lc285800/rk3588-camera-robot/artifacts/20260721/M17-guided-live-acceptance/aligned-marker.jpg

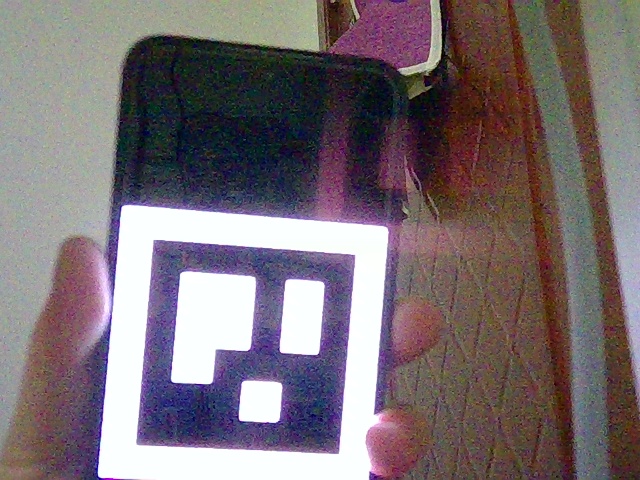
artifacts/20260721/M17-guided-live-acceptance/aligned-marker.jpg
