lc285800/rk3588-camera-robot/artifacts/20260721/M17-live-acceptance-prep/current-view.jpg

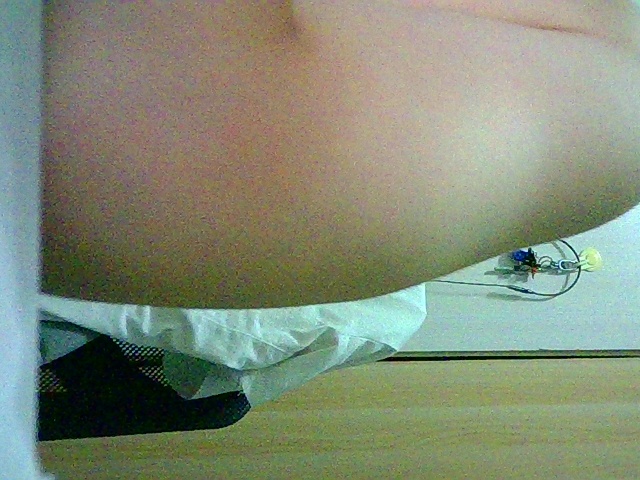
artifacts/20260721/M17-live-acceptance-prep/current-view.jpg
