lc285800/rk3588-camera-robot/README.md

# LubanVision：RK3588 ROS 2 视觉跟踪云台机器人

LubanVision 是一个以 Linux、ROS 2 和主动视觉为主线的机器人学习项目。鲁班猫5
（RK3588，4GB RAM）读取 USB 摄像头图像，ROS 2 节点识别 ArUco 标记并计算画面误差，
通过 RK3588 硬件 PWM 控制 SG90 云台，持续将目标保持在画面中心。

首版不依赖AI模型。所有核心环境、代码、日志和故障都可以通过SSH直接分析与修复，
优先保证项目完整落地。

## 系统分工

```text
MacBook M2（项目控制台）
  Git / 文档 / 任务管理 / SSH 运维
                 │ 家庭局域网
Windows + WSL2（开发工作站） ───── 鲁班猫5 RK3588（机器人运行端）
  ROS 2编译、RViz、rosbag分析          USB摄像头
                                      │ 图像
                              ArUco识别 + PID控制
                                      │ Linux PWM
                            RK3588 PWM13_M1 / Pin 32
                                      │ 3.3V PWM信号
                                1～2个SG90云台
```

Mac和Windows断开后，机器人仍能在鲁班猫5上独立运行。第一阶段使用单轴水平跟踪；验证稳定
后增加第二个SG90，升级为水平和俯仰双轴跟踪。

## 首版交付能力

- USB摄像头ROS 2驱动与远程图像查看。
- OpenCV ArUco检测、目标中心和置信状态发布。
- 可测试的PID视觉伺服控制器。
- RK3588 Linux PWM驱动和SG90安全角度控制。
- 目标丢失后的保持、回中和有限扫描状态机。
- 摄像头、PWM或节点异常时停止更新舵机，禁止无限旋转或撞限位。
- YAML参数、rosbag记录、systemd开机待命和结构化日志。
- 后续可选的人体检测、RK3588 NPU推理和网页监控。

## 仓库状态

仓库只保留LubanVision相关内容。`lubanvision_vision`提供离线ArUco检测和ROS目标观测节点；
`lubanvision_camera_cpp`提供M06验收使用的低开销V4L2相机发布和速率探针，不依赖
`cv_bridge`或OpenCV开发包。`lubanvision_interfaces`提供目标观测消息；
`lubanvision_control`提供ROS无关的PID、目标丢失状态机和模拟云台闭环；
`lubanvision_hardware`提供默认禁用、严格脉宽限位、异常清理的sysfs PWM核心，以及M16
标定和M17单轴视觉跟踪节点。M17基础跟随已完成：物理方向由静止目标A/B确定为`-1`，最终
引导式闭环取得533条有效检测，平均绝对水平误差0.0555、最终0.0341、故障0，退出后PWM与
全部进程安全清理。保守默认仍使用1.85-1.95ms；经现场验证的70-110度、`Kp=6`、最大5度/秒
配置单独记录为测试档案，不自动取代安全默认。短时手持实测确认1.00ms约0度、1.90ms约
90度、2.50ms约150度，舵机为位置型而非360度连续旋转型；目测结果不能替代升级供电后的
量角器测量与连续运行验收。M18硬件故障注入已完成：观测进程退出后按保持/回中转移，USB
摄像头断开时节点明确报错退出且重连重启恢复，PWM已有消费者时每个启用沿只拒绝一次且不
接管。当前下一任务为M19 bringup与systemd待命部署。

## 文档

- [项目协作规则](AGENTS.md)
- [快速入门](docs/01_quick_start.md)
- [系统设计](docs/02_design.md)
- [项目进展](docs/03_progress_status.md)
- [问题记录](docs/04_issue_log.md)
- [测试计划](docs/05_test_plan.md)
- [WSL2 ROS 2安装记录](docs/06_wsl_ros2_install.md)
- [RK3588 ROS 2安装与验证记录](docs/07_rk_ros2_install.md)
- [RK3588 Clash代理与ROS下载记录](docs/rk3588_clash_proxy_ros.md)
- [半小时任务执行手册](docs/08_execution_playbook.md)
- [鲁班猫5 V1硬件参考资料](硬件_鲁班猫5/README.md)
