lc285800/rk3588-camera-robot/assets/markers/aruco_4x4_50_id23.png

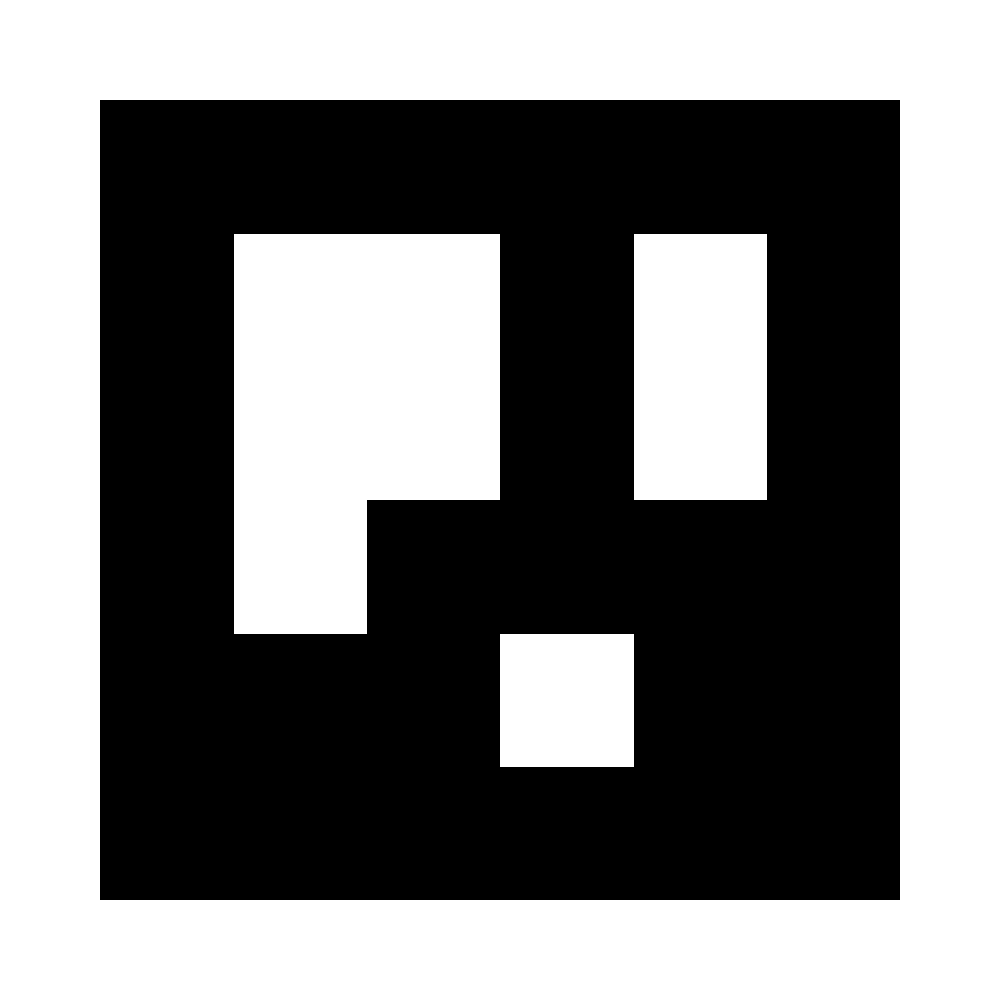
assets/markers/aruco_4x4_50_id23.png
