lc285800/rk3588-camera-robot/(list of files, cad)

Other CAD files:
硬件_鲁班猫5/EBF410149V1R0_20240221/LubanCat5_EBF410149V1R0_PCB_20240221_TOP.dxf
硬件_鲁班猫5/EBF410149V1R0_20240221/LubanCat5_EBF410149V1R0_PCB_20240221_BOT.dxf
