lc285800/rk3588-camera-robot/artifacts/20260722/M18-fault-injection/camera-unbind-result.txt

fault_exit_code=1
recovery_exit_code=124
camera_node=online
result=PASS
