lc285800/rk3588-camera-robot/artifacts/20260720/M16-three-point-calibration/result.md

# M16三点保守标定（第1轮）

## 状态

方向复验和临时软件映射已通过，M16保持进行中（受限）。正式项目代码已经在真实RK/SG90
链路执行，但本轮只重复M15已冒烟验证的1.45-1.55ms范围，不扩大脉宽，不声明机械实测
角度或正式安全范围。

## 软件与系统结果

- 使用`lubanvision_hardware.SysfsPwmChannel`，没有直接拼接sysfs动作命令。
- 顺序为1.50、1.45、1.50、1.55、1.50ms，每点保持约2秒。
- 安全核心正常退出并取消导出PWM。
- Boot ID未变化，uptime连续增长，温度约33-34 C。
- USB摄像头、NVMe和以太网保持在线，动作窗口无新增内核消息。

## 尚未完成

- 供电升级后重新执行同一序列，才可把供电稳定纳入M15完成证据。
- 尚未测量85/90/95度机械角度，YAML为`provisional_three_point`。

## 第2轮方向复验

为消除第1轮顺序记忆的不确定性，单独执行1.50ms中位2秒、1.45ms观察点3秒、1.50ms回中
2秒。安全核心正常关闭，RK与主要外设保持在线，动作窗口无新增内核消息。原始记录位于
`logs/run2-1450-direction.txt`，当前等待用户确认1.45ms实际方向。

用户要求再次观察后，第3轮原样重复同一序列。动作、系统监控和PWM清理再次通过，记录位于
`logs/run3-1450-direction-repeat.txt`。用户确认1.45ms从中位向左转动，恢复1.50ms时向右
回到中位，PWM关闭后保持不动。因此当前方向映射为：脉宽减小向左，中位为1.50ms；1.55ms
方向仍需单独确认。

第4轮从1.50ms中位单独切换到1.55ms三秒后回中，安全核心、系统监控和PWM清理均通过，
记录位于`logs/run4-1550-direction.txt`。用户确认1.55ms向右转动，恢复1.50ms时向左回中并
停止。最终方向映射为：脉宽减小向左，脉宽增大向右，1.50ms为中位。

## 临时标定模型与回归

- 新增`ServoCalibration`，把85/90/95度名义命令映射到1.45/1.50/1.55ms；PWM硬限位仍独立
  生效，越界、非数值、非有限值和非法配置均拒绝。
- WSL与RK的关键文件SHA-256一致。
- WSL硬件包：38项通过；完整工作区：82项通过，0错误、0失败、0跳过。
- RK硬件包：38项通过；完整工作区：82项通过，0错误、0失败、0跳过。
- RK测试前后`pwmchip3/pwm0`均未导出；测试本身没有驱动真实舵机。
- Mac静态编译和脚本检查通过。系统Python缺少PyYAML，YAML解析尝试未执行，已记录在
  `logs/failed-attempts.txt`，正式ROS测试由WSL和RK完成。
