lc285800/rk3588-camera-robot/artifacts/20260720/M15-safe-pwm-core/result.md

# M15受限sysfs PWM核心

## 结论

通过。新增`lubanvision_hardware`包和ROS无关的受限sysfs PWM核心，在WSL与RK完成构建、
单元测试、lint和全工作区回归。整个验证只使用模拟sysfs后端，RK真实`pwmchip3/pwm0`始终
未导出，没有驱动SG90。

## 安全语义

- 默认只接受已经完成硬件冒烟的1.45-1.55ms临时范围，中位为1.50ms，周期为20ms。
- 配置拒绝负通道、非法极性、非整数脉宽、越界脉宽和无效超时。
- 拒绝接管已由其他进程导出的PWM通道。
- 导出后先配置周期、中位和极性，默认保持禁用；显式启用前再次恢复中位。
- 应用异常时先禁用再取消导出；禁用失败仍尝试取消导出。
- 内核导出超时和启用写入异常均覆盖清理路径。
- 平台YAML明确标记`calibration_status: provisional_smoke_only`和
  `enabled_by_default: false`，不得解释为M16正式标定结果。

## 验证结果

- WSL：硬件包23项全部通过；全工作区67项、0错误、0失败、0跳过。
- RK：硬件包23项全部通过；全工作区67项、0错误、0失败、0跳过。
- 关键源码与测试文件在Mac、WSL、RK的SHA-256一致。
- Flake8依赖发出`SelectableGroups`弃用警告，不影响项目代码和测试结论。

## 状态边界

该工作消除了后续直接拼接sysfs命令的风险，但不改变M15供电结论。当前12V 1.5A输入和板载
共享5V仍只允许已有的小步冒烟记录；更换供电并复测前，M15保持进行中，M16保持未开始。
