lc285800/rk3588-camera-robot/artifacts/20260720/M15-servo-smoke/result.md

# M15 SG90硬件冒烟测试

## 结论

有限通过。PWM13_M1真实信号、Pin 32接线、共地和SG90基本动作链路成立；用户现场确认舵机
产生轻微转动。当前供电条件不满足正式标定要求，因此M15仍保持进行中，不进入扩大脉宽范围
或连续动作测试。

## 动作序列

- 周期固定为20,000,000 ns（50 Hz）。
- 依次输出1.50、1.45、1.50、1.55、1.50 ms，每步约1秒。
- 用户确认观察到轻微转动。
- 测试后PWM已关闭并取消导出。
- 原始动作时间、并行健康监控和测试后状态位于`logs/servo-smoke.txt`。

## 系统健康

- 测试期间uptime连续增长，Boot ID未变化，RK没有重启。
- SoC温度约33-35 C。
- USB摄像头、NVMe和以太网在测试后仍在线。
- 动作窗口没有新增内核错误。

## 供电限制

鲁班猫当前使用12V 1.5A输入，低于硬件规格书的12V 2A；SG90暂时使用板卡40Pin共享5V，
板上同时连接USB摄像头、CPU风扇、Mini-PCIe Wi-Fi和M.2 NVMe。该配置只接受本次短时小步
冒烟结果，不能据此声明供电裕量、堵转安全或完整舵机标定通过。

继续M16前应换为可靠的12V 3A板卡电源，或让SG90使用独立稳压5V 2A以上电源并与鲁班猫
共地。更换供电后先重复中位和小步动作，再逐步测量安全脉宽范围。

板卡电源树、40Pin 5V和Pin 32映射依据仓库`硬件_鲁班猫5/`中的V1规格书及EBF410149V1R0
原理图，资料版本和SHA-256记录在该目录的`README.md`与`checksums.txt`。
