lc285800/rk3588-camera-robot/artifacts/20260715/M09-target-observation-interface/result.md

# M09 Target Observation Interface Result

## Expected

Build one shared ROS 2 message on WSL amd64 and RK arm64. The message must carry the source image
timestamp, target ID, pixel error, normalized error, area, confidence, and detection state.

## Actual

- Both devices were reachable through passwordless SSH; the RK camera device was online.
- `lubanvision_interfaces` built successfully on WSL in 5.53 seconds and RK in 10.8 seconds.
- `ros2 interface show` exposed the same `TargetObservation` definition on both architectures.
- Python constructed a populated message on both devices and assertions for target ID, detected status,
  and normalized X error passed.

## Conclusion

PASS. M09 is complete and T-BUILD-01 is now complete. The next task is M10 offline ArUco detection.
