lc285800/rk3588-camera-robot/artifacts/20260721/M16-document-sync/result.md

# M16文档一致性复核

## 结论

- README、设计、项目进度、问题日志、测试计划和执行手册对当前状态表述一致。
- M15保持进行中：等待12V 3A板卡输入或独立稳压5V舵机电源条件下复测。
- M16保持进行中（受限）：三点方向和临时名义映射已通过，机械量角和安全边界仍待可靠供电。
- M17尚未开始，不在当前供电条件下提前进入真实视觉闭环。
- M16代码、现场记录和双端测试已由提交`8b0d1fc`留痕。

## 本次范围

本次只同步文档日期、恢复点和复核证据，不修改代码、不驱动PWM，也不重复真实舵机动作。
此前WSL/RK硬件包各38项、完整工作区各82项测试结果继续作为M16当前软件回归结论。
