lc285800/rk3588-camera-robot/artifacts/20260716/M14-simulated-gimbal/result.md

# M14 模拟云台闭环

## 结论

通过。实现确定性的ROS无关单轴云台模型和`simulation_probe`，正负阶跃均稳定收敛，控制
方向、绝对输出限幅和每周期增量限幅符合M12语义。

## 模型与验收

- 初始归一化图像误差：`+0.6`和`-0.6`。
- 仿真周期：0.05秒；持续8秒；一阶执行器时间常数0.18秒。
- 参数：`Kp=1.5`、`Ki=0`、`Kd=0.12`、死区0.003。
- 限幅：绝对输出0.5，每周期输出变化0.08。
- 通过条件：90%响应小于3秒，2%稳定时间小于5秒，超调小于5%，稳态误差小于0.005。

## 结果

| 阶跃 | 90%响应 | 2%稳定 | 超调 | 稳态误差 | 最大输出 | 最大周期变化 |
|---|---:|---:|---:|---:|---:|---:|
| +0.6 | 1.85 s | 2.75 s | 0.00% | 0.002169 | 0.500 | 0.080 |
| -0.6 | 1.85 s | 2.75 s | 0.00% | 0.002169 | 0.500 | 0.080 |

WSL与RK的控制包各33项测试全部通过，工作区各44项测试、0错误、0失败、0跳过。Mac、WSL
和RK生成的JSON、CSV和SVG哈希完全一致。

## 首轮失败与修正

首轮`Kp=1.8`、`Ki=0.12`、`Kd=0.08`、死区0.005时，上升时间1.55秒且超调3.63%，但积分
与死区形成约0.017误差的低幅极限环，8秒内未进入2%稳定带。正式验收改为保守PD参数后通过。
该过程记录为`ISSUE-20260716-15`，模拟参数不得直接作为真实SG90参数。

## 产物

- `data/step_response.csv`：两组161点原始响应。
- `data/metrics.json`：参数和验收指标。
- `data/step_response.svg`：阶跃误差曲线。
- `checksums.txt`：三端一致性校验值。
- `logs/`：WSL与RK测试摘要。

## 下一任务

M15：只读盘点PCA9685、I2C总线和独立5V供电，不驱动舵机。
