lc285800/rk3588-camera-robot/artifacts/20260716/M13-target-loss-state/result.md

# M13 目标丢失状态机

## 结论

通过。新增ROS无关的跟踪状态机，状态仅包含`TRACKING`、`HOLDING`和`RETURNING`，
首版默认不自动扫描。

## 已验证行为

- 首次发现目标进入跟踪并请求清理PID历史。
- 目标丢失后在`hold_timeout`内保持当前位置。
- 到达超时边界后进入回中状态。
- 从保持或回中重新捕获目标时请求清理PID历史。
- 持续跟踪不会每周期重复清PID。
- 零保持超时会立即回中。
- 非法时间、时间倒退和非布尔可见状态被拒绝。

## 双端结果

WSL与RK的控制包均收集27项测试并全部通过；各自工作区汇总38项测试、0错误、0失败、
0跳过。

## WSL复核

之前的免密SSH配置仍有效。正确目标是`liu@192.168.2.100:2222`；本次失败由误用
`evanliu`用户名造成。WSL的`sshd`为active，`~/.ssh`权限700，`authorized_keys`权限600。

## 下一任务

M14：建立模拟云台闭环，生成正负阶跃响应曲线和收敛指标。
