lc285800/rk3588-camera-robot/docs/04_issue_log.md

# 问题记录

问题编号使用`ISSUE-YYYYMMDD-NN`。每项记录环境、现象、复现、日志、根因、修复和回归
结果；密码、Wi-Fi密钥和私有令牌不得写入。

## 模板

- 编号、状态、日期：
- 环境：Mac、WSL或RK；系统、内核、ROS 2版本、代码提交：
- 现象与期望：
- 最小复现：
- 日志、截图或rosbag：
- 已排除项：
- 根因：
- 修复：
- 回归验证：
- 预防措施：

## 当前问题

### ISSUE-20260722-19：M18断流与PWM占用故障可能无限重试

- 状态：已解决。
- 环境：鲁班猫5、ROS 2 Humble、USB UVC摄像头、PWM13_M1。
- 现象：旧相机节点对不可恢复的`DQBUF/QBUF`错误只做节流日志并继续定时读取；跟踪节点收到
  连续`true`消息且PWM被占用时，会在每条消息上重新尝试获取硬件。
- 风险：设备断开后形成无意义循环，或故障状态下高速重试PWM，与T-CAM-03和T-SERVO-04不符。
- 修复：相机节点对不可恢复V4L2错误立即抛出并退出，增加默认1秒无帧看门狗；跟踪节点锁存
  启用请求，每个`false -> true`沿最多尝试获取一次。
- 回归：真实解绑`6-1:1.0`后节点以`No such device`和状态1退出，重新绑定后恢复15 FPS；外部
  占用PWM时10Hz启用消息只产生一次拒绝，通道保持禁用。观测源退出按保持、回中转移，测试后
  相机、NVMe、网线在线且PWM释放。证据位于`artifacts/20260722/M18-fault-injection/`。

### ISSUE-20260702-01：Mac不承担ROS 2 Humble目标构建

- 状态：已决策。
- 说明：MacBook M2负责主仓、文档和SSH；Windows/WSL2负责桌面开发，RK负责ARM64运行。
- 影响：Mac缺少colcon不是项目阻塞项。

### ISSUE-20260708-02：RK3588镜像与板卡版本待确认

- 状态：已解决。
- 风险：LubanCat-5与LubanCat-5-V2镜像、设备树不能混用。
- 验证：记录背面丝印、镜像完整名称、`uname -a`和`cat /etc/os-release`。
- 结果：设备树确认为`Embedfire LubanCat-5`，系统为Ubuntu 22.04.5 LTS ARM64，内核
  `6.1.84`；内存、存储和时间同步正常。

### ISSUE-20260708-03：WSL与RK跨机DDS验证

- 状态：已解决，采用定向发现方案。
- 结果：默认multicast受WSL2 NAT限制；M08改用RK侧Fast DDS Discovery Server
  `192.168.2.120:11811`后，WSL可以发现并订阅RK的`/camera/image_raw`，读取到
  `640x480 bgr8`样本且短测约15 Hz。
- 约束：RK主动访问WSL私网仍不可用，但不影响当前RK发布、WSL订阅的工作流；禁止通过关闭
  全部Windows防火墙规避该约束。

### ISSUE-20260708-04：舵机PWM路线和安全范围未知

- 状态：部分解决，方向已确认，等待可靠供电和机械量角。
- 风险：选错PWM复用、信号管脚、供电或脉宽范围可能导致无响应、板卡掉压、抖动或撞限位。
- 决策：首版单轴不采购PCA9685，使用物理Pin 32的`GPIO4_B6 / PWM13_M1`输出信号；
  SG90仍使用独立5V供电并与鲁班猫共地。
- 回归：2026-07-17无外设软件验证成功输出50 Hz、1.5 ms脉宽，Pin 142复用为PWM13。
- 硬件冒烟：2026-07-20真实SG90执行1.50/1.45/1.50/1.55/1.50ms短序列，用户确认轻微转动；
  RK未重启，摄像头、NVMe和网线保持在线，PWM已安全关闭并取消导出。
- 受限标定：单独复验确认1.45ms向左、1.50ms居中、1.55ms向右；临时软件映射使用
  85/90/95度名义值，双端硬件包各38项、工作区各82项测试通过。
- 待验证：当前板卡仅使用12V 1.5A输入且SG90暂接板载共享5V，不能证明供电裕量。升级为
  12V 3A输入或独立稳压5V舵机电源后，再完成M15，并对M16做实际机械量角和边界复验。

### ISSUE-20260708-05：Rockchip FFmpeg包阻塞ROS相机驱动安装

- 状态：已绕过并完成回归。
- 环境：LubanCat-5，Ubuntu 22.04.5 ARM64，Rockchip multimedia PPA，ROS 2 Humble。
- 现象：安装`ros-humble-v4l2-camera`或`ros-humble-cv-bridge`时，Ubuntu标准
  `libavcodec-dev`、`libavutil-dev`等要求精确版本，但板卡已安装带`+rkmpp`后缀的运行库。
- 已排除：ROS基础环境、V4L2设备和摄像头本身正常；640x480 MJPEG 30 FPS原始采集通过。
- 约束：不得直接强制降级或删除Rockchip多媒体运行库，以免破坏板卡硬件编解码环境。
- 最终方案：M06验收改用`lubanvision_camera_cpp/v4l2_camera_publisher`，直接读取V4L2
  YUYV并发布`bgr8`，不依赖`cv_bridge`或OpenCV开发包。Python节点只保留为低频调试样例。
- 回归：C++链路两轮15 FPS冒烟测试通过，M07稳定性预跑在暂停前累计11700帧、`missed=0`，
  且已按用户验收口径通过。因此无需改动Rockchip多媒体运行库，本问题关闭。

### ISSUE-20260708-06：ROS旧签名密钥过期

- 状态：已解决。
- 现象：使用旧`ros.key`执行`apt update`返回`EXPKEYSIG F42ED6FBAB17C654`。
- 根因：项目旧文档记录的Open Robotics签名密钥已经过期。
- 修复：从ROS官方`ros-infrastructure/ros-apt-source` 1.2.0发布获取
  `ros2-apt-source_1.2.0.jammy_all.deb`，核对SHA-256后安装，由配置包管理新密钥和软件源。
- 回归：ROS软件源`InRelease`签名通过，`ros-humble-ros-base`安装完成。
- 预防：不再手工复制长期固定的`ros.key`；优先使用官方`ros2-apt-source`配置包。

### ISSUE-20260708-07：ROS软件源下载慢且直连HTTPS异常

- 状态：已缓解。
- 现象：RK直连`packages.ros.org`时HTTPS证书主机名不匹配，HTTP下载大量小包速度慢。
- 修复：仅将`packages.ros.org`转发到MacBook Clash `7897`端口，中科大Ubuntu镜像保持直连。
- 实测：代理连通和HTTP 200正常；剩余7.33 MB ROS包用时8分54秒，平均13.7 KB/s。
- 结论：代理提高可用性和稳定性，但本次未表现出明显吞吐加速；大量小包约4秒一次请求是
  主要耗时。配置和删除方法见`docs/rk3588_clash_proxy_ros.md`。

### ISSUE-20260708-08：ROS包版权测试失败

- 状态：已解决。
- 环境：RK ROS 2 Humble，`lubanvision_vision` 0.1.0。
- 现象：`colcon test`发现3项测试，Flake8和PEP257通过，`ament_copyright`报告许可证未知。
- 根因：Humble的`ament_copyright`不识别简写`Licensed under the Apache License, Version 2.0`。
- 修复：本地5个Python文件已替换为完整Apache 2.0标准版权头。
- 回归：清理该包构建与安装缓存后重新构建，3项测试全部通过，0错误、0失败、0跳过。

### ISSUE-20260708-09：Python ROS原始图像发布性能不足

- 状态：已解决，保留Python节点但M06验收改用C++节点。
- 现象：M06消息尺寸和编码正确，但默认可靠QoS下`ros2 topic hz`短时只观察到约0.46 Hz。
- 对照：同一摄像头由Python OpenCV连续读取120帧，实测27.82 FPS，排除V4L2采集瓶颈。
- 根因：640x480 BGR图像约0.88 MiB；RK上Python给`sensor_msgs/Image.data`赋值921600字节时
  仅约6.9 msg/s，构造raw图像消息本身已低于15 FPS目标。Best Effort和Cyclone DDS不能解决
  该发布端瓶颈。
- 修复：新增`lubanvision_camera_cpp`，直接使用V4L2 YUYV采集，C++内转换为`bgr8`并发布标准
  `sensor_msgs/Image`；发布器和探针支持`reliability`参数，M06使用reliable QoS验收。
- 回归现状：发布者实际QoS确认为`BEST_EFFORT/VOLATILE`；`topic echo --qos-profile
  sensor_data`能够收到640高的图像，但收到前报告丢失2条。轻量Python订阅计数器首次得到
  0帧，测试脚本又因未启用`pipefail`误返回成功，结果无效。
- 修复补充：2026-07-09已新增`image_rate_probe`作为包内订阅计数探针；相机节点新增
  `stats_interval_sec`发布端计数日志。
- 回归：`lubanvision_camera_cpp`在RK构建通过；C++发布器以640x480、`bgr8`、15 FPS、reliable
  QoS运行两轮短测，发布端稳定15 FPS，C++探针接收端分别为15.06 FPS和15.09 FPS，
  `bad_frames=0`，SIGINT退出正常。
- 预防措施：后续高带宽raw图像链路优先使用C++节点；Python节点可保留作低频调试或接口样例。

### ISSUE-20260708-10：相机节点退出时重复关闭ROS上下文

- 状态：已解决。
- 现象：测试发送SIGINT或timeout后，`rclpy.shutdown()`报告`rcl_shutdown already called`。
- 根因：信号处理已关闭上下文，`finally`再次无条件调用shutdown。
- 修复：只在`rclpy.ok()`为真时调用`rclpy.shutdown()`。
- 回归：同步RK后使用SIGINT退出，要求进程无Python traceback。
- 2026-07-09回归：使用`timeout -s INT`结束相机节点，日志未出现Python traceback或
  `rcl_shutdown already called`。

### ISSUE-20260709-11：WSL2 NAT阻塞默认跨机DDS图像发现

- 状态：已绕过，M08通过；默认multicast和RK主动访问WSL私网仍不可用。
- 环境：RK `192.168.2.120/24`，WSL Linux接口`172.30.122.43/20`，Windows/SSH入口
  `192.168.2.100:2222`，ROS_DOMAIN_ID=20。
- 现象：RK发布`/camera/image_raw`正常，RK本机可通过Fast DDS discovery server发现该话题；
  WSL无法通过默认multicast或`ROS_DISCOVERY_SERVER=192.168.2.120:11811`发现该话题。
- 最小复现：RK启动`v4l2_camera_publisher`；WSL执行`ros2 topic list`仅看到`/parameter_events`
  和`/rosout`。RK启动ROS自带Fast DDS discovery server后，RK本机配合`ROS_SUPER_CLIENT=True`
  可见`/camera/image_raw`，WSL仍不可见。
- 网络证据：WSL可ping RK且可TCP连接RK SSH 22。2026-07-09首次`nc -u`探测未到达；2026-07-10
  WSL重启并恢复portproxy后，WSL到RK UDP探测可到达RK监听端口。RK经Windows路由访问WSL私网
  `172.30.127.238`仍失败。
- 根因判断：当前WSL2 NAT网络不提供ROS 2 DDS所需的UDP/multicast可达性；`192.168.2.100`
  是Windows侧地址，不是WSL Linux参与DDS的接口地址。
- 解决：M08采用RK侧Fast DDS Discovery Server `192.168.2.120:11811`。RK相机发布器和WSL订阅
  端统一设置`ROS_DOMAIN_ID=20`、`ROS_DISCOVERY_SERVER=192.168.2.120:11811`；WSL额外设置
  `ROS_SUPER_CLIENT=True`。该方案下WSL可发现`/camera/image_raw`，可读取`640x480 bgr8`
  图像样本，`ros2 topic hz`短测约15 Hz。
- 后续：不要依赖默认multicast发现；不要直接关闭全部Windows防火墙。若将来需要RK主动连接WSL
  私网服务，再处理Windows路由或迁移到支持mirrored networking的环境。
- 2026-07-10补充：Windows 10 Home环境未验证到可用mirrored networking。删除`.wslconfig`后
  WSL私网IP变更导致`2222`端口转发失效，已更新portproxy到`172.30.127.238:22`并恢复SSH。
  尝试启用Windows三层转发：`以太网`和`vEthernet (WSL)`接口Forwarding已开启，
  `IPEnableRouter=1`已写入注册表，RemoteAccess服务已启动；RK添加
  `172.30.112.0/20 via 192.168.2.100`后仍无法访问WSL私网。当前M08不再等待Windows重启，
  后续如需双向三层互访，再重启Windows验证路由开关或改用不依赖WSL2 NAT的网络/桥接方案。

### ISSUE-20260715-12：M11独立进程发现和图像QoS不稳定

- 状态：已解决，保留Discovery Server启动等待约束。
- 环境：RK ROS 2 Humble/Fast DDS，M11 ArUco节点，640x480 BGR图像。
- 现象：默认发现、`ROS_LOCALHOST_ONLY=1`以及双方都设`ROS_SUPER_CLIENT=True`时，独立探针
  发布82帧而检测节点收到0帧；Best Effort订阅真实Reliable相机时接收间歇，约4至5 FPS。
- 无效尝试：在加载ROS环境前启用`set -u`导致`AMENT_TRACE_SETUP_FILES`未定义；停止
  `ros2 run`外层PID未结束实际节点；两项均已在后续脚本修正并保留失败记录。
- 根因：该网络必须沿用M08的Fast DDS角色配置；发布端是普通Discovery Server客户端，检测
  订阅端设为SUPER_CLIENT。图像QoS必须与M06的Reliable发布路径一致。
- 修复：节点图像订阅改为Reliable/Volatile；按Server、SUPER_CLIENT检测节点、普通相机发布
  端顺序启动并等待发现。停止时先停相机，后停检测节点；捕获`ExternalShutdownException`。
- 回归：真实相机发布225帧保持15 FPS；发现完成后检测节点每2秒稳定增加30帧，输入错误0，
  无标记场景误检0。确定性同executor集成用于字段和时间戳验证，61条观测错误0。
- 预防：M11后续启动文件固化DDS角色和Reliable QoS；性能窗口忽略发现建立前的累计时间。

### ISSUE-20260716-13：macOS tar元数据干扰RK Python lint

- 状态：已解决。
- 环境：Mac向RK同步新`lubanvision_control`包，RK ROS 2 Humble。
- 现象：首次tar同步生成`._setup.py`等AppleDouble文件，导致copyright、Flake8和PEP257
  读取到非UTF-8内容或空字节。
- 根因：macOS文件扩展属性随归档生成AppleDouble伴随文件，非项目源码问题。
- 修复：远端同步后删除`._*`，清理该包build/install缓存后重新构建测试。
- 回归：本包16项测试全部通过，0失败。
- 预防：从macOS向Linux归档同步源码时禁用扩展属性，并在验收前检查和删除`._*`。

### ISSUE-20260716-14：WSL SSH误用Mac本地用户名

- 状态：已解决。
- 环境：Mac连接Windows端口转发`192.168.2.100:2222`进入WSL Ubuntu 22.04。
- 现象：TCP端口和SSH协议均正常，但使用`evanliu@192.168.2.100:2222`时公钥认证被拒绝。
- 已排除：Windows主机在线、2222端口可达、WSL `sshd`为active、远端主机密钥未变化。
- 根因：WSL Linux账号是`liu`，`evanliu`是Mac本地账号；公钥安装在
  `/home/liu/.ssh/authorized_keys`，错误账号下自然无法匹配。
- 修复：恢复使用`ssh -p 2222 liu@192.168.2.100`。
- 回归：BatchMode免密登录成功；主机`DESKTOP-KSDDPU2`、ROS 2 Humble和colcon均可用。
- 预防：快速入门固定记录三机用户名；认证失败时先核对目标用户，再检查密钥和端口转发。

### ISSUE-20260716-15：模拟闭环积分与死区形成低幅极限环

- 状态：已解决，硬件参数仍需M16-M17重新标定。
- 环境：M14归一化单轴模拟云台，`dt=0.05 s`，一阶舵机时间常数`0.18 s`。
- 现象：首轮参数`Kp=1.8`、`Ki=0.12`、`Kd=0.08`、死区`0.005`时，正负阶跃上升时间
  1.55秒、超调3.63%，但8秒内未进入2%稳定带；末段误差在约0.017附近持续摆动。
- 根因：积分在死区外继续积累，进入死区后输出回零；一阶执行器惯性将误差推过中心，随后
  积分反向释放，形成对称低幅极限环。
- 修复：M14验收参数改为保守PD：`Kp=1.5`、`Ki=0`、`Kd=0.12`、死区`0.003`，保留输出
  和周期增量限幅。
- 回归：正负阶跃均1.85秒达到90%响应、2.75秒进入2%稳定带、0%超调、稳态误差0.002169。
- 预防：软件模拟参数不得直接作为硬件参数；真实SG90接入后从PD开始，小步增加积分并监测
  死区附近振荡。

### ISSUE-20260720-16：受限PWM核心首次回归与清理边界

- 状态：已解决。
- 环境：WSL与RK ROS 2 Humble，`lubanvision_hardware`首次构建测试。
- 无效尝试：在加载ROS环境前启用`set -u`，两端均因`AMENT_TRACE_SETUP_FILES`未定义而在
  构建前退出；Mac的系统Python和工作区Python均无pytest，未在Mac临时安装依赖。
- 首轮回归：20项功能测试通过，但PEP257因`__exit__`文档字符串不是祈使语气而失败。
- 安全审计：修正文档字符串时发现，导出后若等待通道节点超时，旧实现可能不请求取消导出；
  启用写入报错时也应立即尝试关闭。
- 修复：ROS环境在nounset前加载；修正文档字符串；导出写入成功后立即记录所有权；新增导出
  超时清理测试；启用写入异常时尝试关闭。
- 回归：WSL和RK硬件包各23项测试全部通过，全工作区各67项测试0失败；RK真实PWM未导出。

### ISSUE-20260721-17：M17真实闭环视场方向与安全启动

- 状态：安全启动工具已完成，机械朝向待用户调整后复核。
- 环境：鲁班猫5、`/dev/video1`、单轴Pan云台、M17默认禁用跟踪节点。
- 现象：实拍640x480画面明显侧转并朝向桌面/柜体下方；当前场景没有ID 23标记。若画面水平轴
  与Pan机械转轴不一致，控制器虽能识别旋转后的ArUco，图像X误差却不能代表实际Pan方向。
- 风险：未经目标检测直接启动会造成无意义动作；脚本异常可能留下相机、检测或录包进程。
- 修复：新增确定性的ID 23标记和`m17_live_acceptance.sh`。脚本要求连续5帧检测才显式启用，
  使用精确进程组管理相机、检测、控制、指标和rosbag；退出时发布禁用并复核PWM，绝不接管
  已导出的通道。
- 无效尝试：首轮脚本在加载ROS环境前保持`set -u`，因Humble环境脚本读取未定义变量而提前
  退出；修正为仅在source期间关闭nounset。本轮发生在启动节点前，PWM未导出。
- 回归：无标记3秒门控超时按预期返回失败，未启用舵机，所有精确进程组退出且PWM清理通过。
- 待办：将相机安装为画面水平轴与Pan轴一致，让ID 23标记入镜后运行20秒真实动态验收。

### ISSUE-20260721-18：SG90名义角度与实际位置不一致

- 状态：已修正当前默认映射，精确量角和长期端点安全性仍待验收。
- 现象：原1.45/1.50/1.55ms只验证方向，却被临时标成85/90/95度；扩展测试中也曾把脉宽中点
  1.75ms误称为90度，实际用户观察约80度。连续序列结束后的视觉判断又造成位置混淆。
- 根因：在没有量角器的情况下把理论线性中点和命令标签误当成机械实测角度。
- 实测事实：用户手持观察确认1.00ms约0度、1.90ms约90度、2.50ms约150度；各点均停止在
  固定位置并可返回。舵机为位置型，非360度连续旋转型，未实测到180度。
- 修复：以后一次只保持一个待确认位置；代码与YAML的自动跟踪中心改为1.90ms，默认硬限位
  改为1.85-1.95ms，对应名义85-95度。扩展端点只记录为短时目测标定，不用于自动跟踪。
- 预防：角度标签必须区分“命令值”“目测值”和“量具实测值”；用户确认前不得写成正式角度。

### ISSUE-20260721-19：安装后主观方向判断矛盾

- 状态：已解决。
- 现象：移动手机的动态测试中，用户先后观察到方向可能正确和可能相反；大幅移动又导致标记
  离开画面，无法仅凭摄像头动作判断控制符号。
- 根因：手机、摄像头和图像坐标的左右参照不同，同时移动目标会改变误差，主观观察不可靠。
- 方法：舵机每轮从90度启动，手机标记固定不动；分别运行`direction=+1`和`-1`，比较同一轮
  最初10条与最后10条观测的绝对水平误差。
- 结果：`+1`从0.590恶化到0.754；`-1`从0.185收敛到0.035，降低约81%。负方向测试持续
  检测91帧、故障0，PWM从1.900增至1.924ms且结束后释放。
- 修复：硬件节点、平台YAML和验收脚本默认方向统一固定为`-1`；后续方向回归必须使用静止
  目标的误差收敛数据，不接受单独的肉眼方向描述作为结论。

### ISSUE-20260721-20：M17验收启用竞态与人工动作时机不明确

- 状态：已解决。
- 现象：一次动态测试的启用消息先匹配rosbag而非跟踪节点，整轮状态均为disabled；人工测试
  又因不知道何时移动手机而产生无效数据。手机过近且屏幕过亮时识别率仅28.7%。
- 修复：启用/禁用消息改为多次可靠发布；开始计时前订阅`/gimbal/state`并强制确认
  `enabled=true`。最终测试由模型逐步发出中央、左移、回中、右移指令；手机后移20-30厘米、
  亮度约50%，使预检恢复到81/81帧。
- 回归：最终引导式闭环533条有效检测，平均绝对误差0.0555、最终0.0341、故障0；PWM和所有
  进程清理通过。未启用的竞态轮明确作废，不纳入性能结论。
