lc285800/rk3588-camera-robot/硬件_鲁班猫5/EBF410149V1R0_20240221/LubanCat5_EBF410149V1R0_SCH_20240221.pdf

# Page 1 Content

# 野火 RK3588 LubanCat 5 原理图

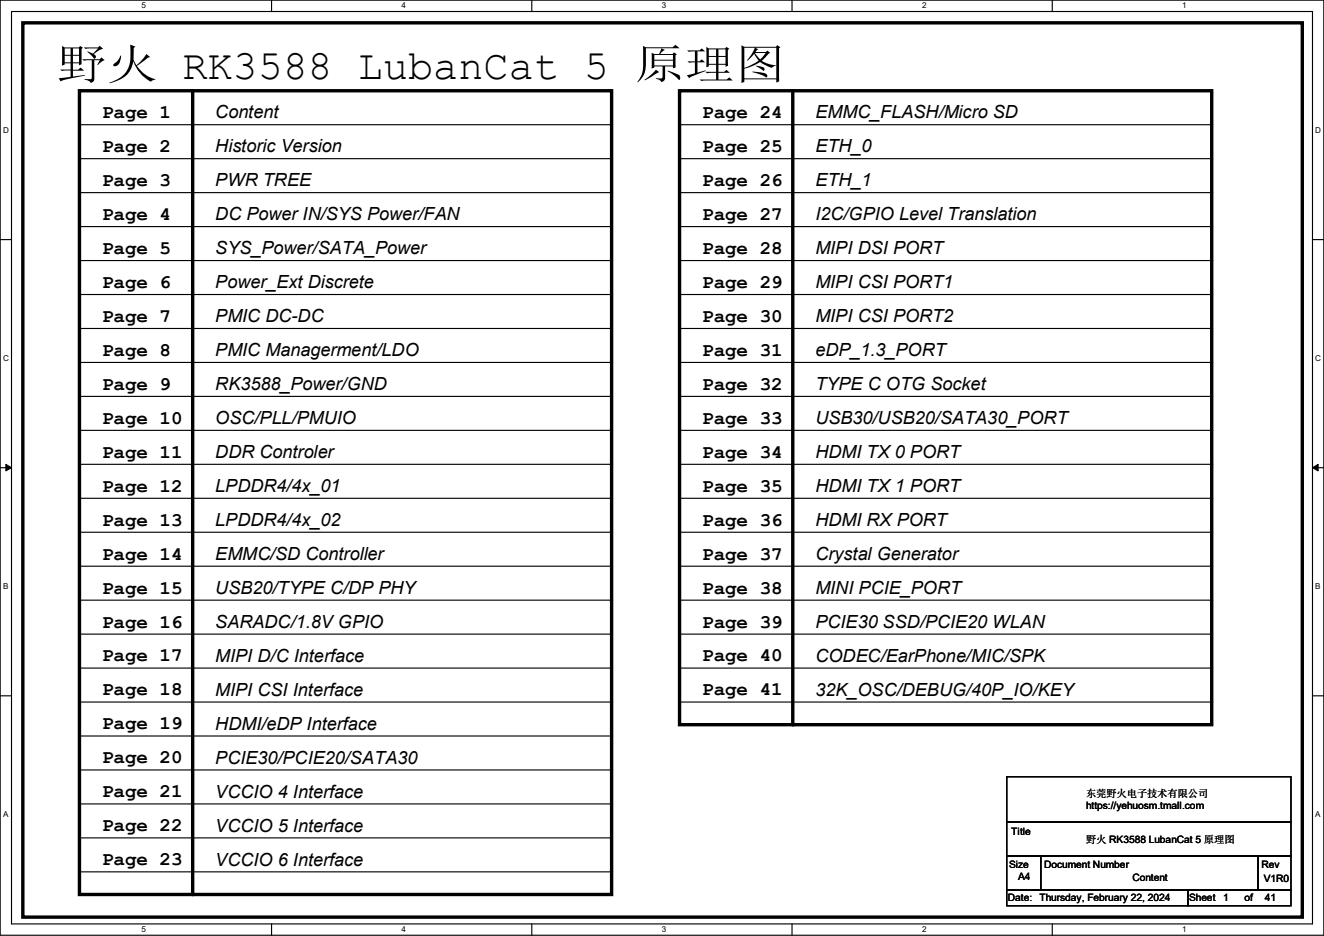
[picture p4: page 1]
Page 14; Page 15; Page 16; Page 17; Page 12; Page 2; Page 3; Page 4; Page 5; Page 6; Page 8; Page 7; Page 9; Page 10; Page 11; Page 13; Page 18; Page 19; Page 20; Page 21; Page 22; Page 23; VCCIO 6 Interface; Page 24; EMMC_FLASH/Micro SD; Page 25; ETH_0; Page 26; ETH_1; Page 27; I2C/GPIO Level Translation; Page 28; MIPI DSI PORT; Page 29; MIPI CSI PORT1; Page 30; MIPI CSI PORT2; Page 31; eDP_1.3_PORT; Page 32; TYPE C OTG Socket; Page 33; USB30/USB20/SATA30_PORT; Page 34; HDMI TX 0 PORT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

Historic Version
PWR TREE
DC Power IN/SYS Power/FAN
SYS_Power/SATA_Power
Power_Ext Discrete
PMIC DC-DC
PMIC Managerment/LDO
RK3588_Power/GND
OSC/PLL/PMUIO
DDR Controler
LPDDR4/4x_01
LPDDR4/4x_02
EMMC/SD Controller
USB20/TYPE C/DP PHY
SARADC/1.8V GPIO
MIPI D/C Interface
MIPI CSI Interface
HDMI/eDP Interface
PCIE30/PCIE20/SATA30
VCCIO 4 Interface
VCCIO 5 Interface

东莞野火电子技术有限公司
https://yehuosm.tmall.com

野火 RK3588 LubanCat 5 原理图

# Historic Version

# 版本号

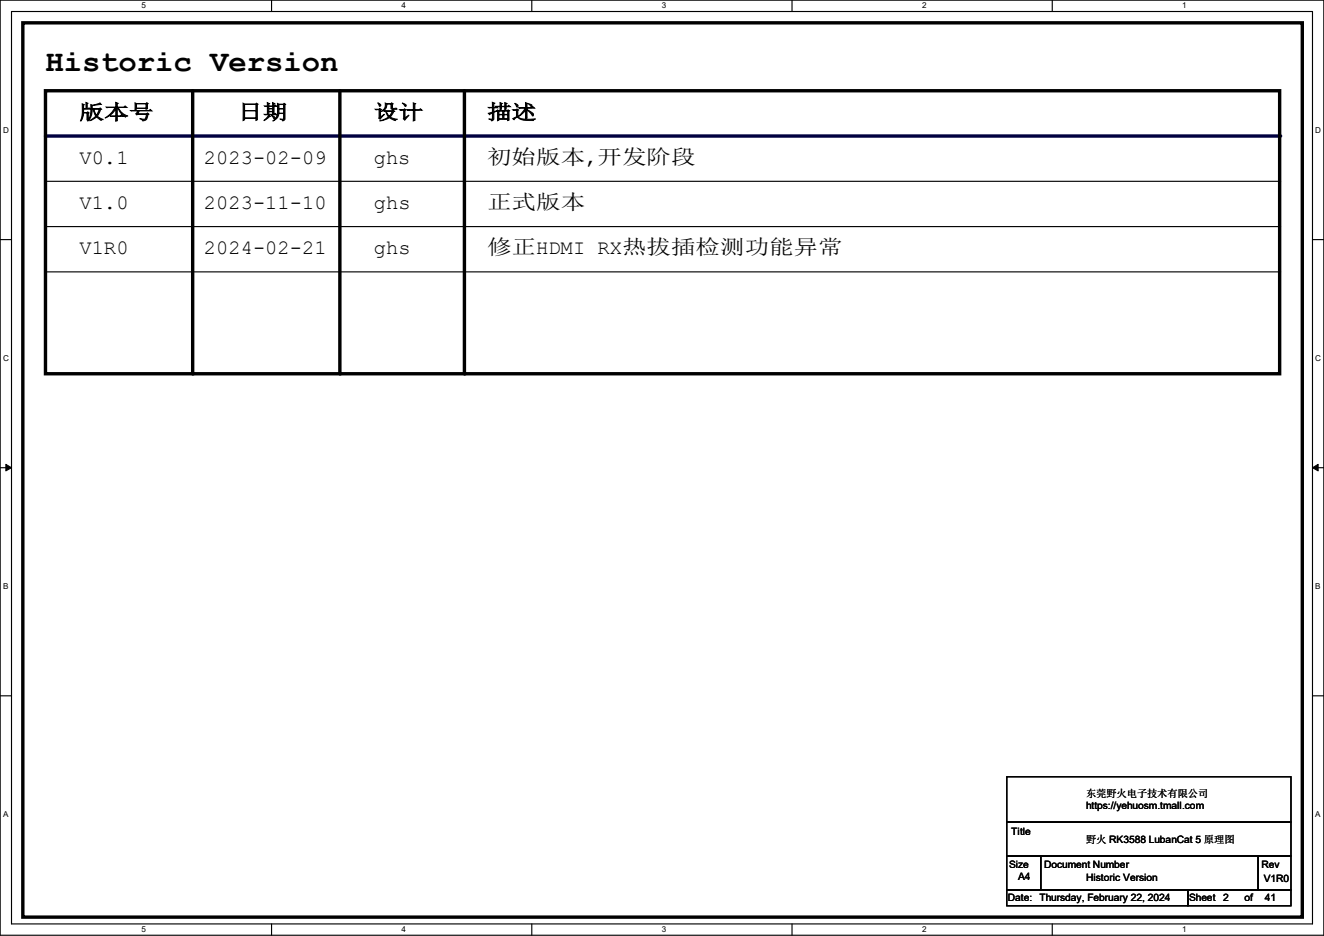
[picture p5: page 2]
ghs; 初始版本,开发阶段; 正式版本; 修正HDMI RX热拔插检测功能异常; Title; Size; Document Number; Rev; Date:; Sheet; Historic Version; Thursday, February 22, 2024

东莞野火电子技术有限公司
https://yehuosm.tmall.com

野火 RK3588 LubanCat 5 原理图

# Power tree

## VCC3V3_SYS

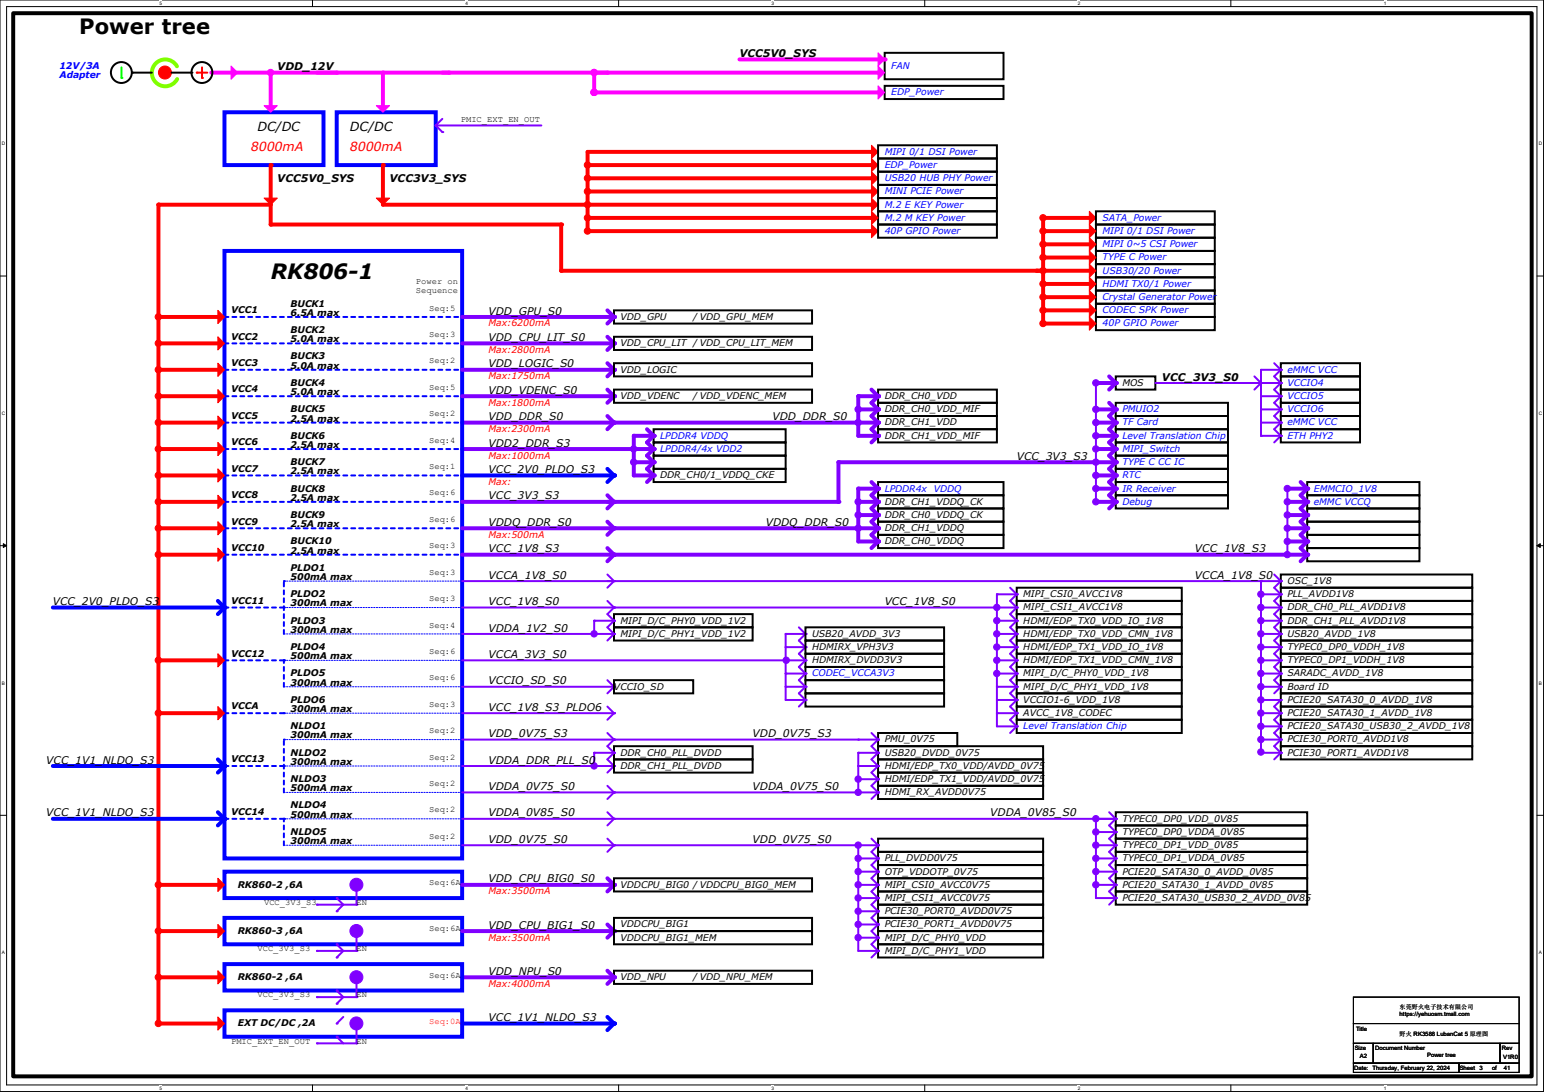
[picture p6: page 3]
VCCIO4 VCCIO5; eMMC VCC; USB20_DVDD_0V75; VCC5V0_SYS; HDMIRX_VPH3V3; USB20_AVDD_3V3; VCCIO_SD; HDMI/EDP_TX1_VDD/AVDD_0V75; PMU_0V75; AVCC_1V8_CODEC; VCCIO1-6_VDD_1V8; FAN; MOS; DDR_CH0_VDD_MIF; DDR_CH0_VDD; DDR_CH1_VDD_MIF; DDR_CH1_VDD; VCC_3V3_S3; DDR_CH0/1_VDDQ_CKE; Power on Sequence; Seq:3; Seq:5; LPDDR4/4x VDD2; LPDDR4 VDDQ Seq:2; VCC1; BUCK3 5.0A max; BUCK4 5.0A max; BUCK1 6.5A max; VCC2; BUCK2; 5.0A max; VCC3; VCC4; Seq:4; Seq:2; Seq:1; VCC5; BUCK7 2.5A max; BUCK8 2.5A max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

MIPI 0/1 DSI Power
EDP_Power
USB20 HUB PHY Power
MINI PCIE Power
M.2 E KEY Power
M.2 M KEY Power
40P GPIO Power

SATA_Power
MIPI 0~5 CSI Power
TYPE C Power
USB30/20 Power
HDMI TX0/1 Power
Crystal Generator Power
CODEC SPK Power

PMUIO2
TF Card
Level Translation Chip
MIPI_Switch
TYPE C CC IC
RTC
IR Receiver
Debug

东莞野火电子技术有限公司 https://yehuosm.tmall.com

野火 RK3588 LubanCat 5 原理图

# DC IN

12V 3A

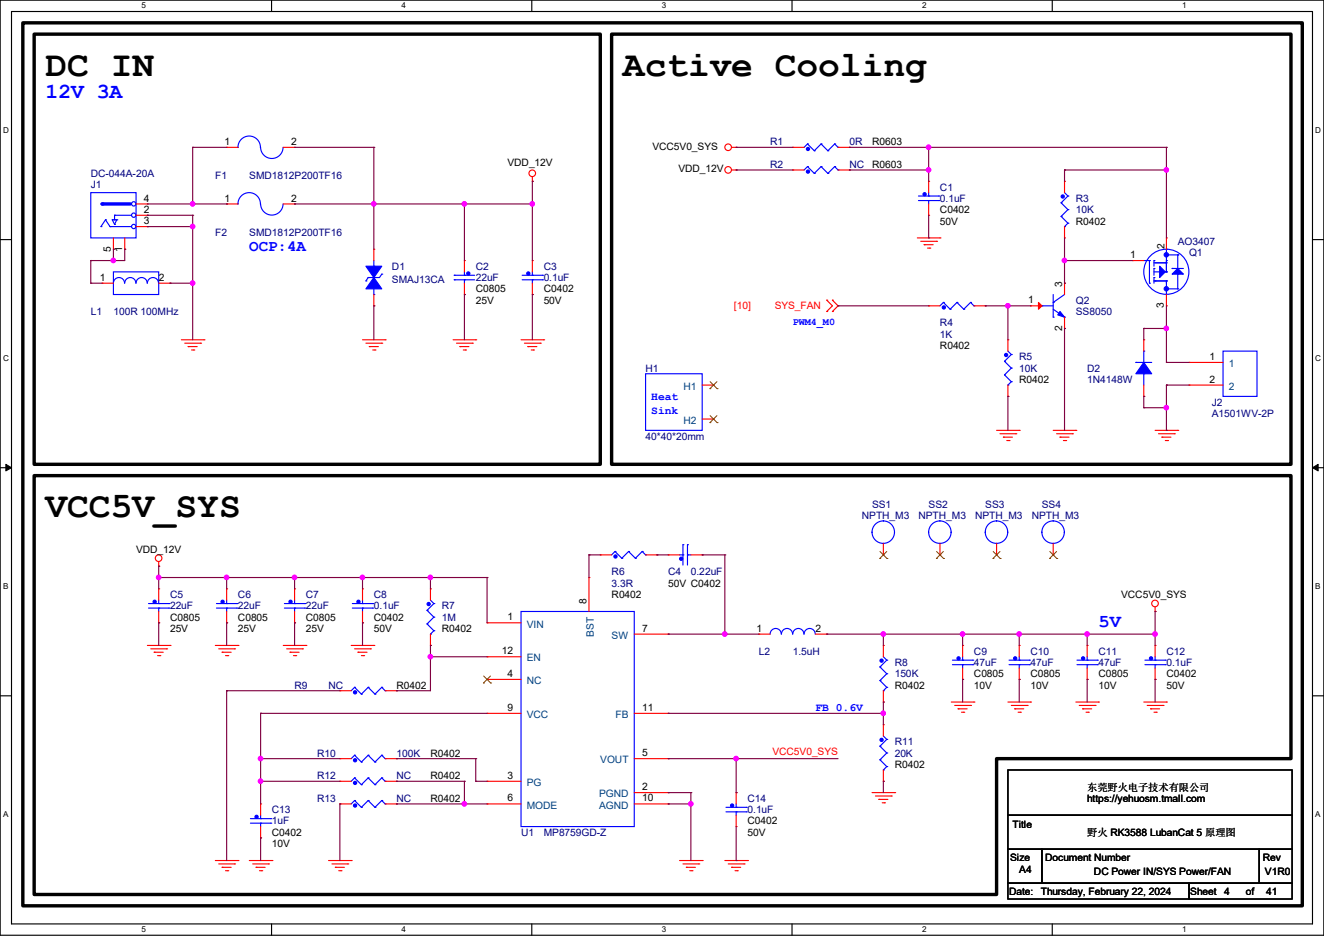
[picture p7: page 4]

东莞野火电子技术有限公司
https://yehuosm.tmall.com

# VCC3V3_SYS

3.4V

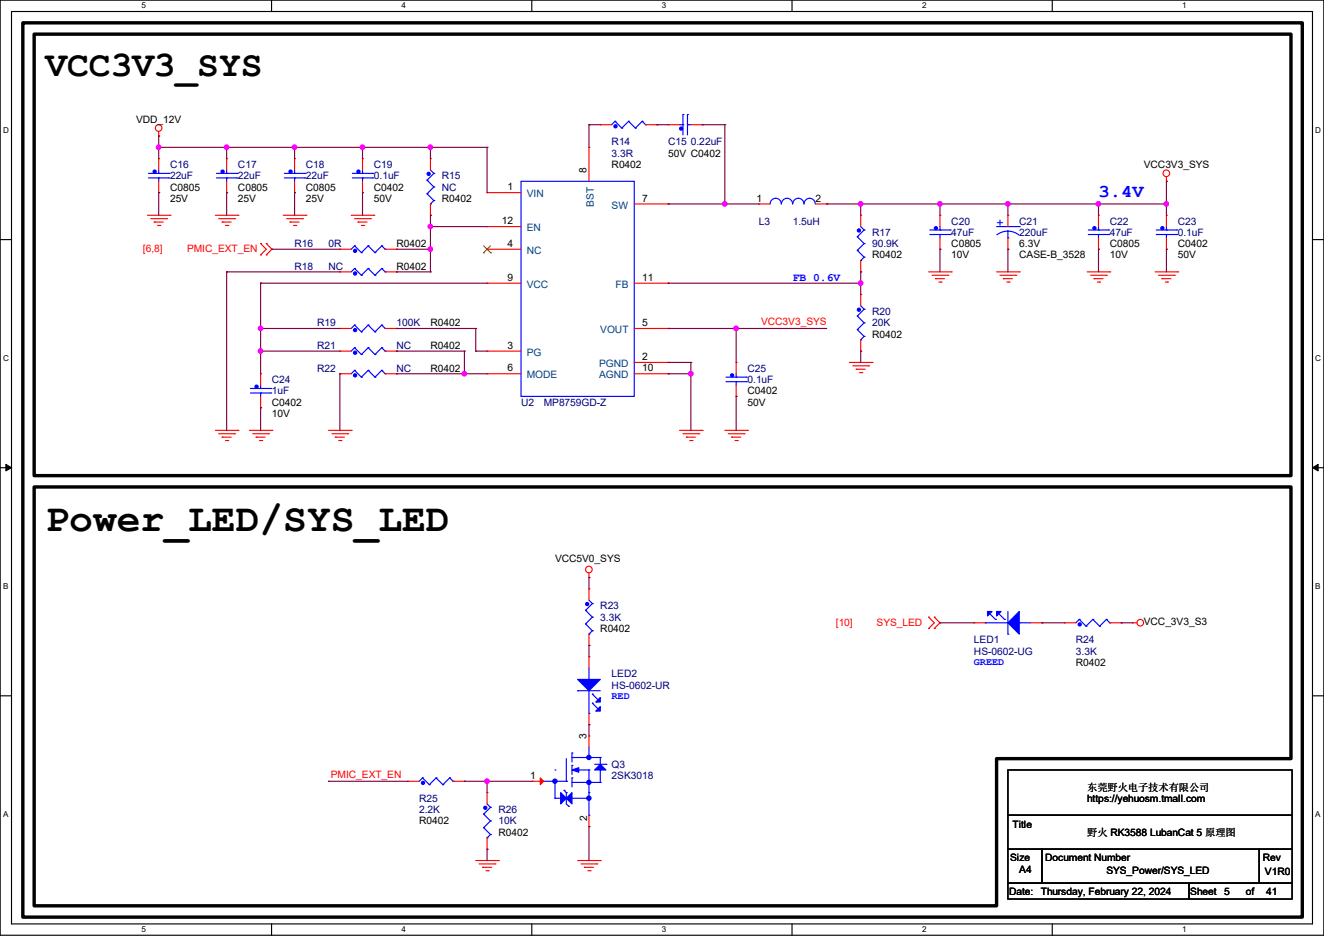
[picture p8: page 5]

东莞野火电子技术有限公司
https://yehuosm.tmall.com

VDD_CPU_BIG1 100R | RK3588

## Feedback from RK3588

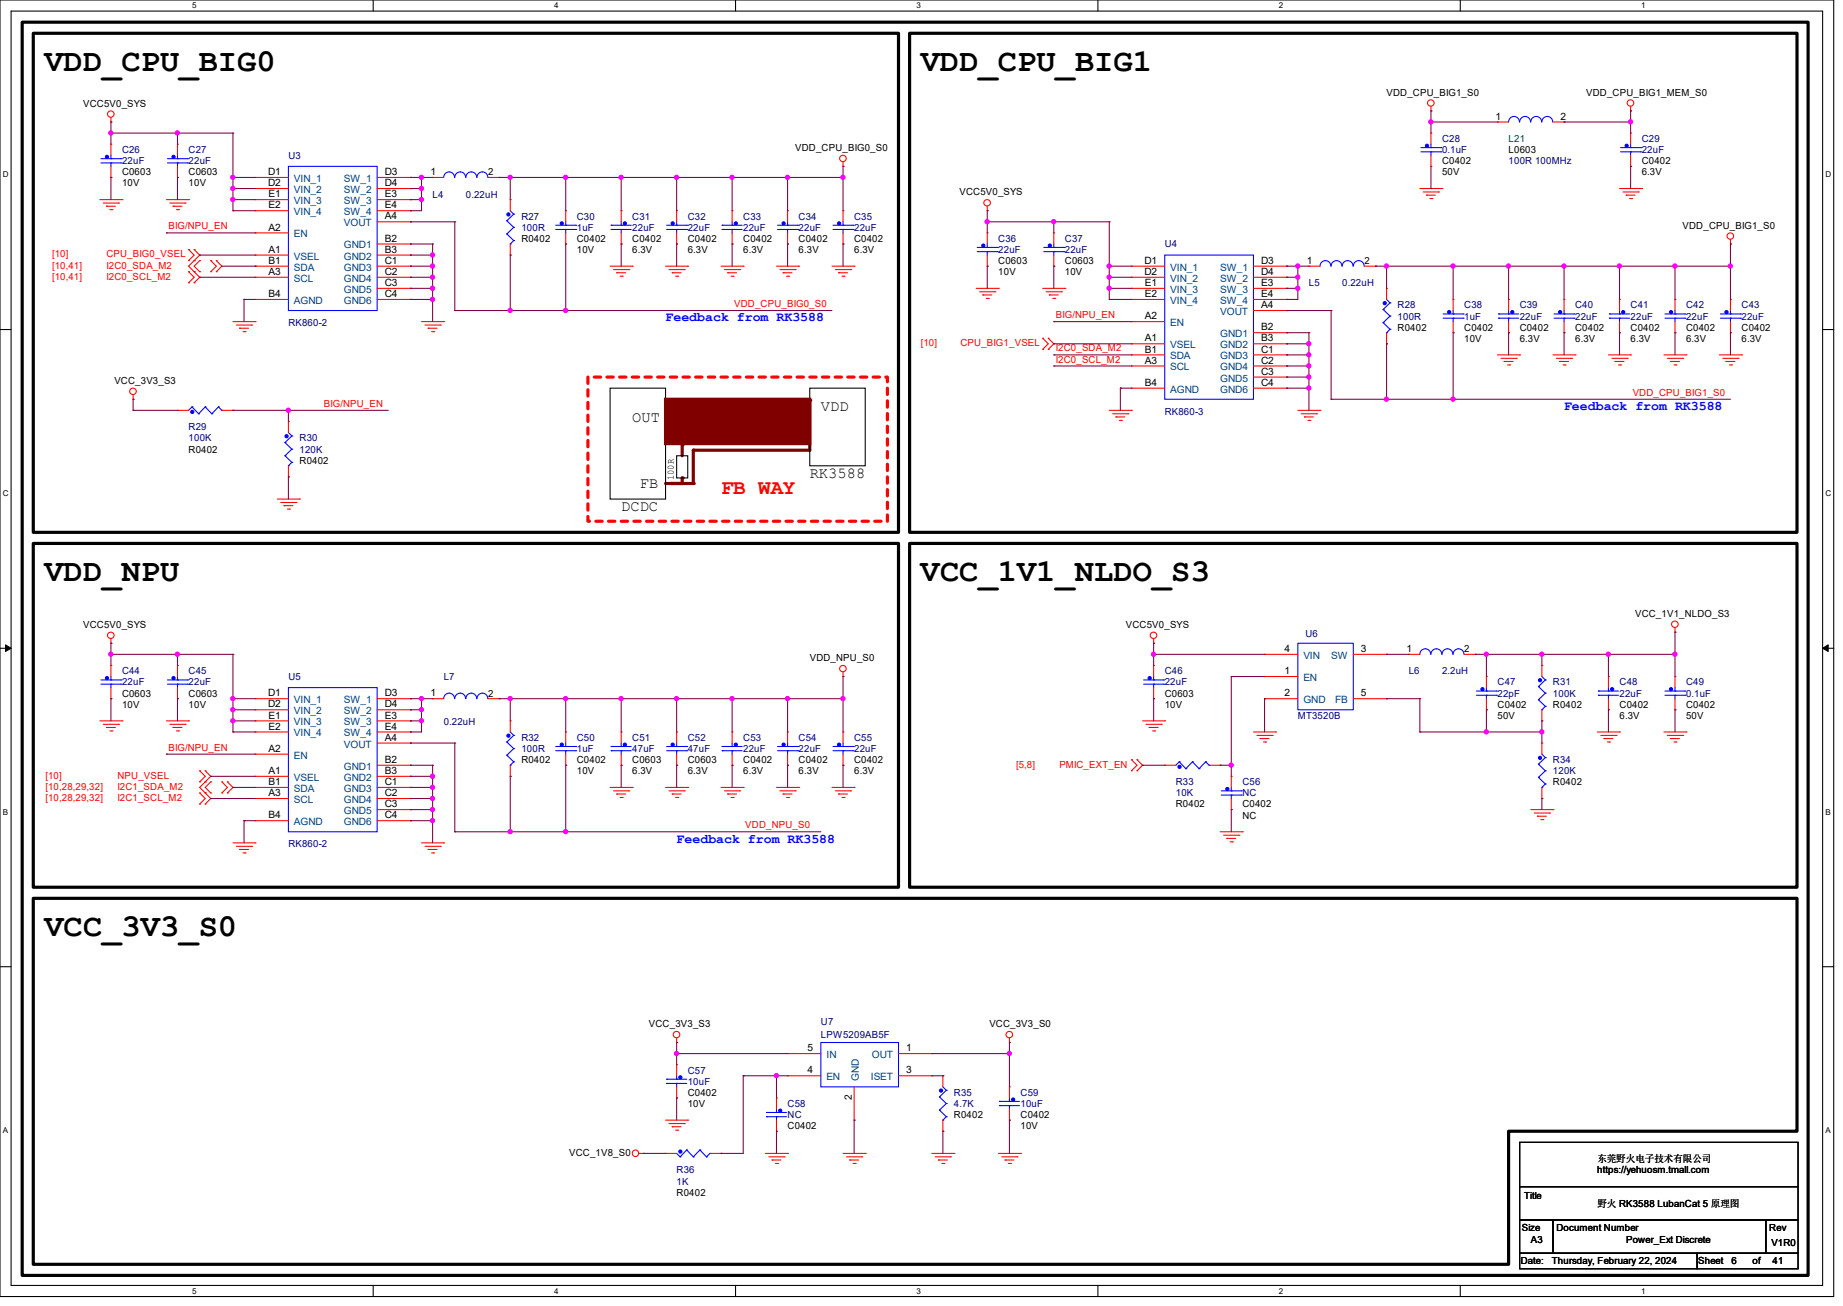
[picture p9: page 6]

东莞野火电子技术有限公司 https://yehuosm.tmall.com

# PMIC DC-DC 100R RK3588S

## Low frequency:

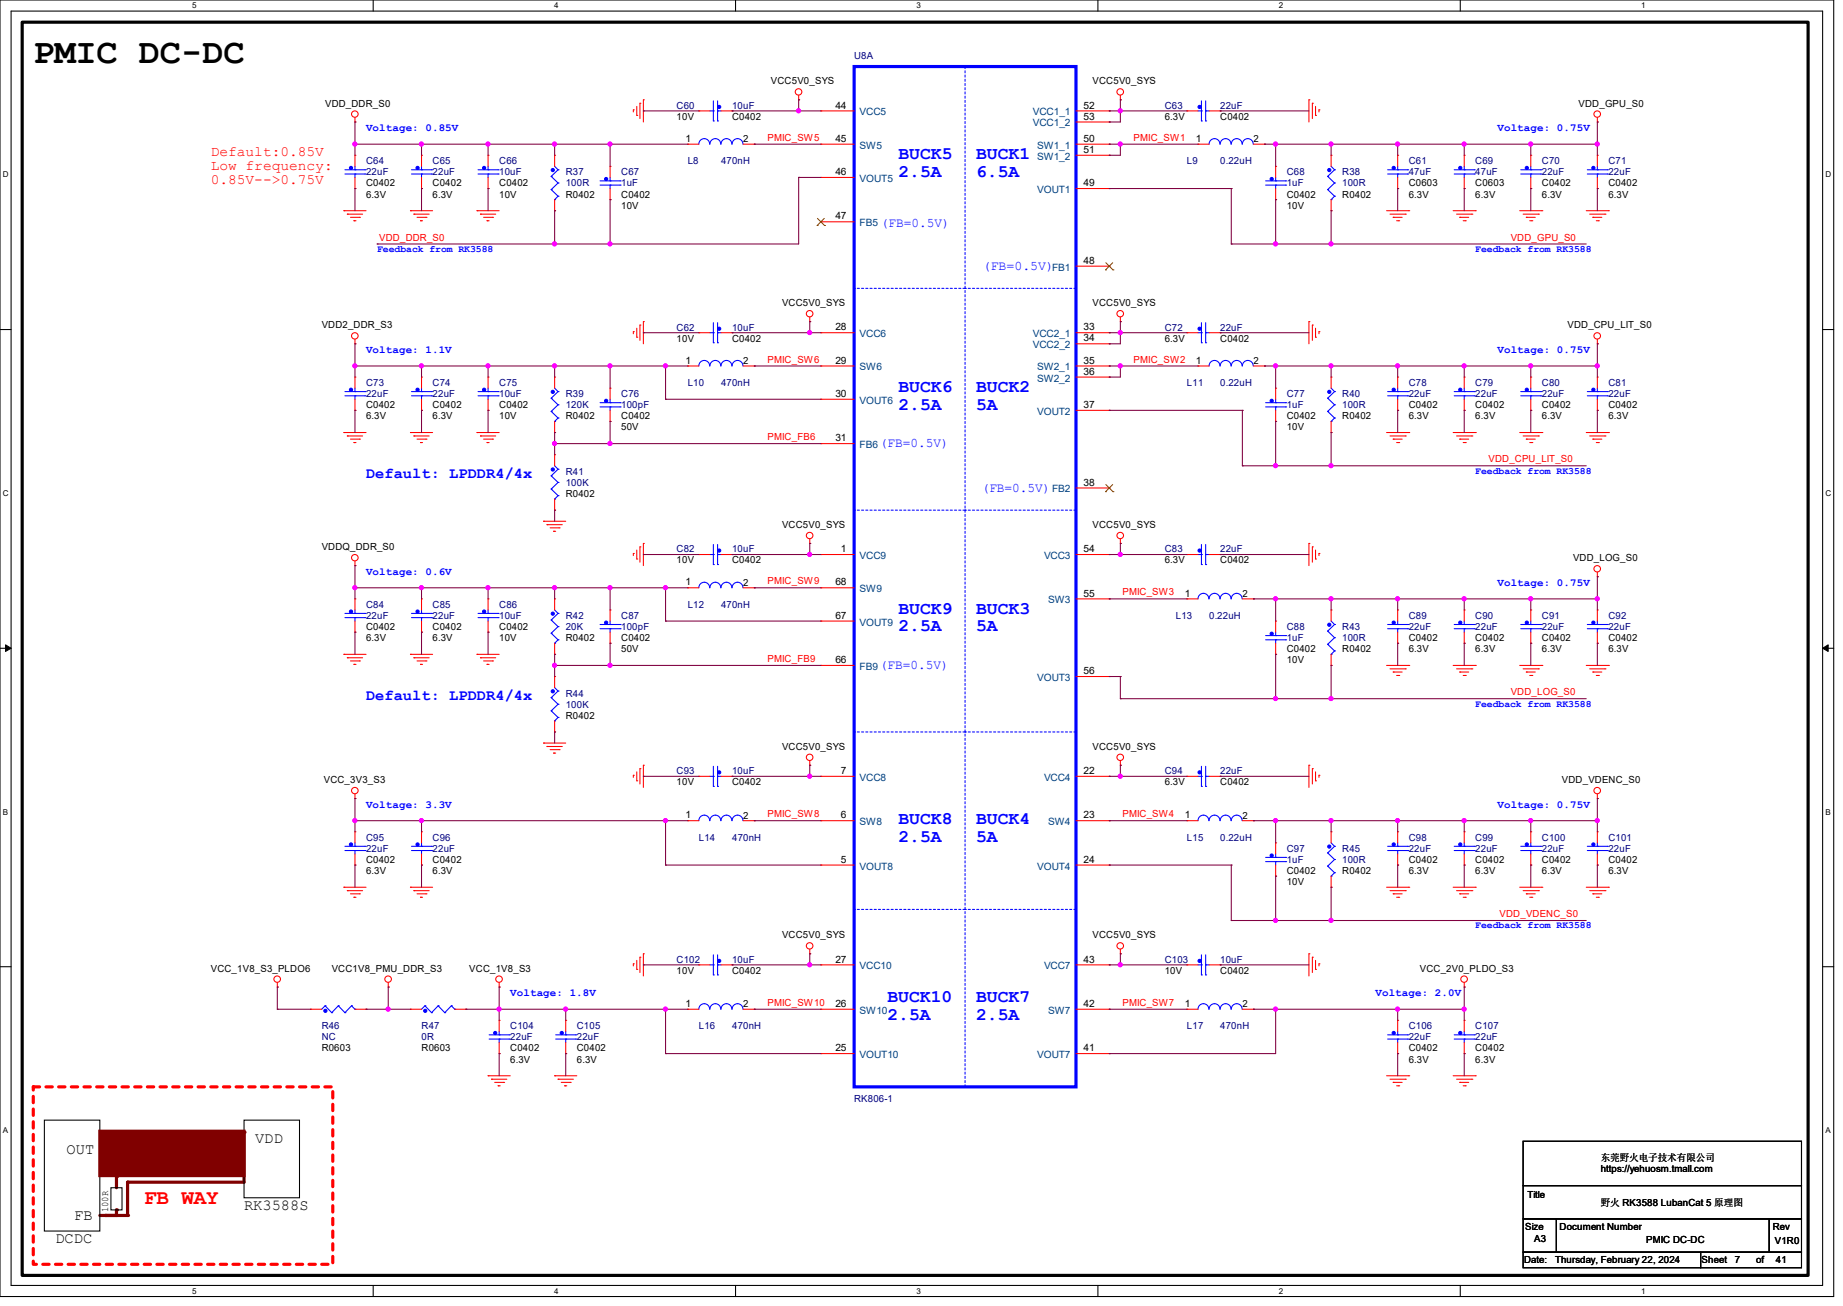
[picture p10: page 7]

东莞野火电子技术有限公司 https://yehuosm.tmall.com

D D

# PMIC RK806-1 Managerment

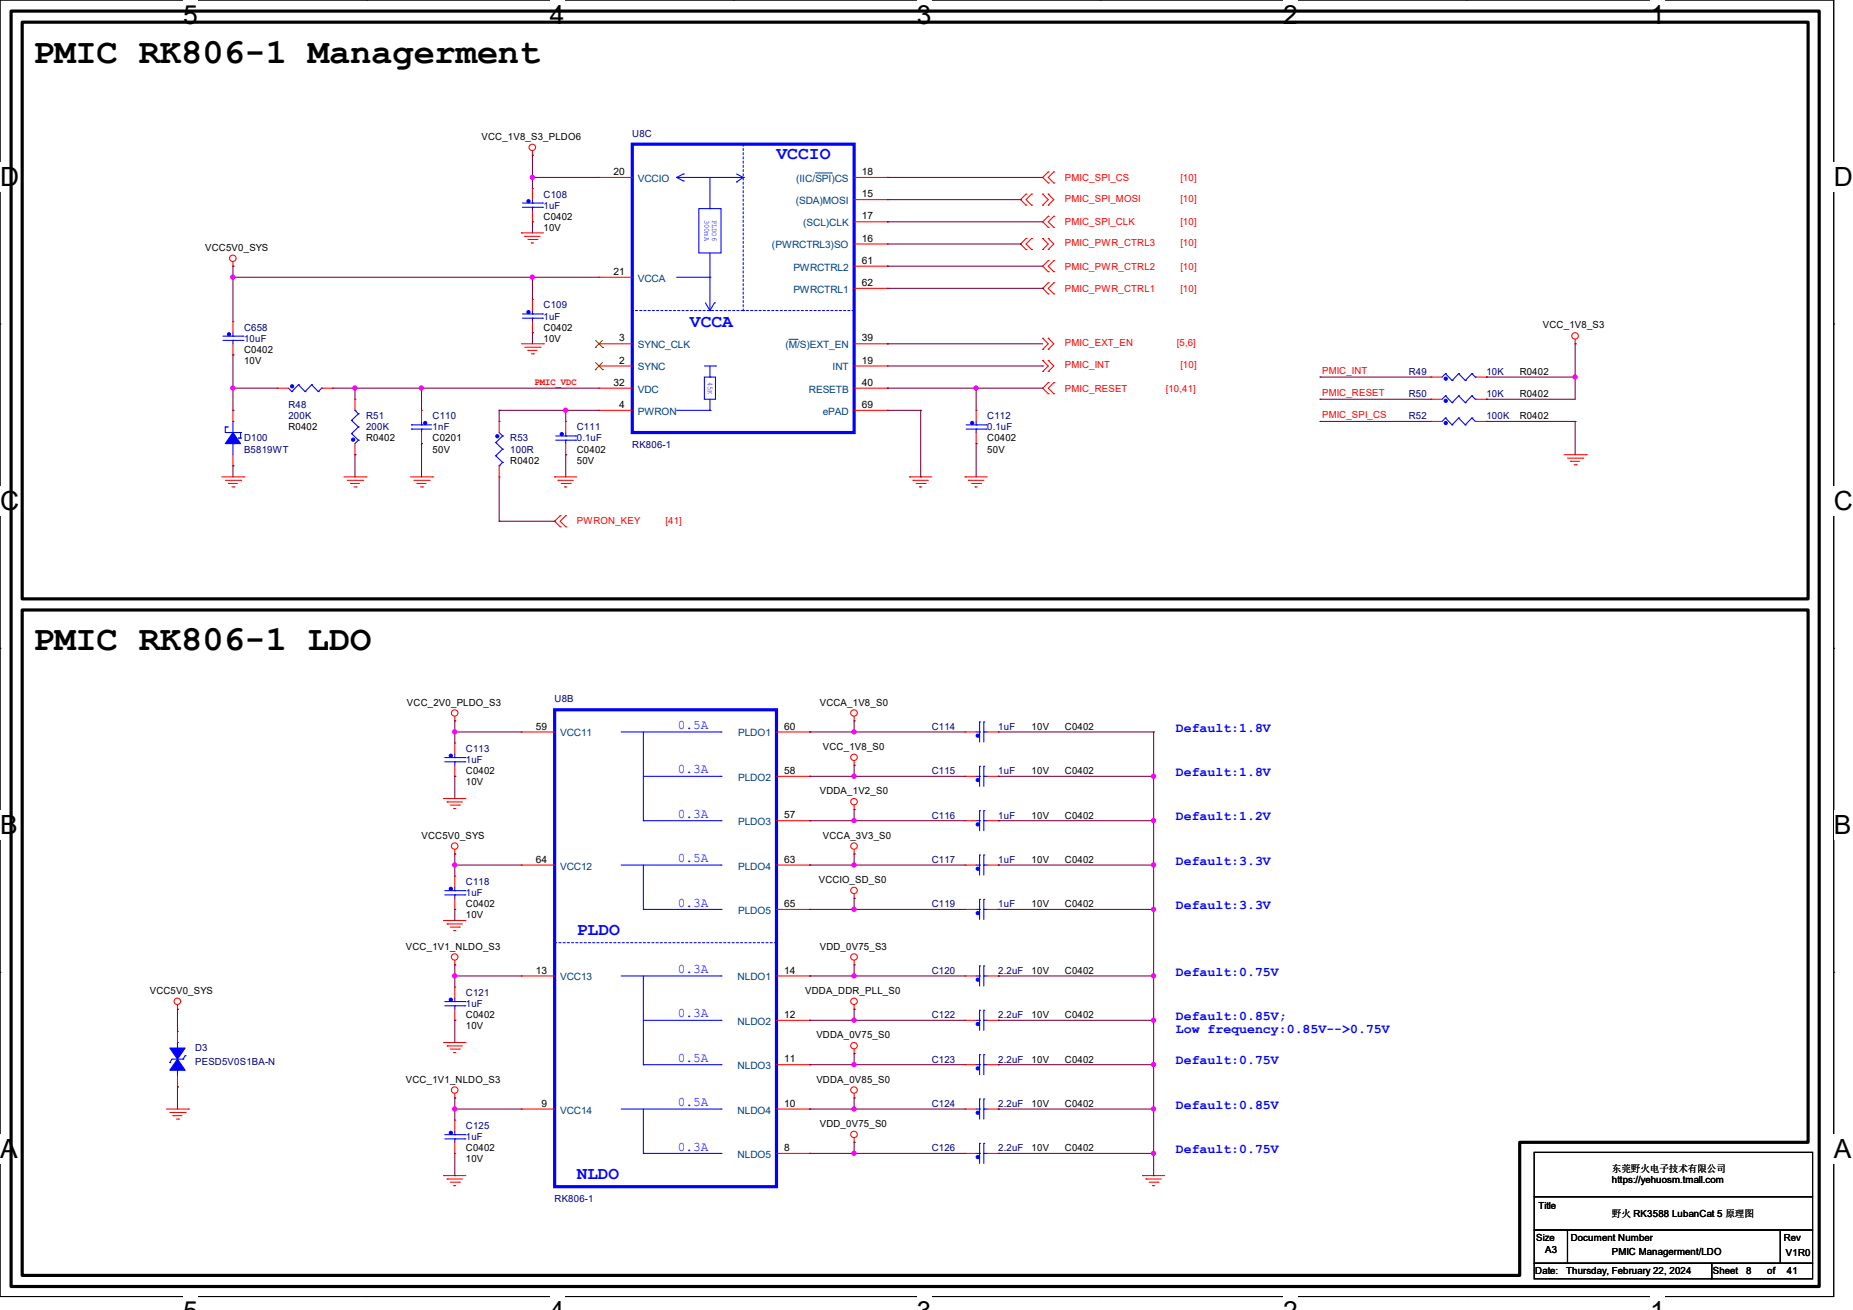
[picture p11: page 8]

(SCL)CLK 17 PWRON 4 SYNC_CLK 3 SYNC 2 VDC 32

东莞野火电子技术有限公司 https://yehuosm.tmall.com

# RK3588_V(POWER)

10V C175

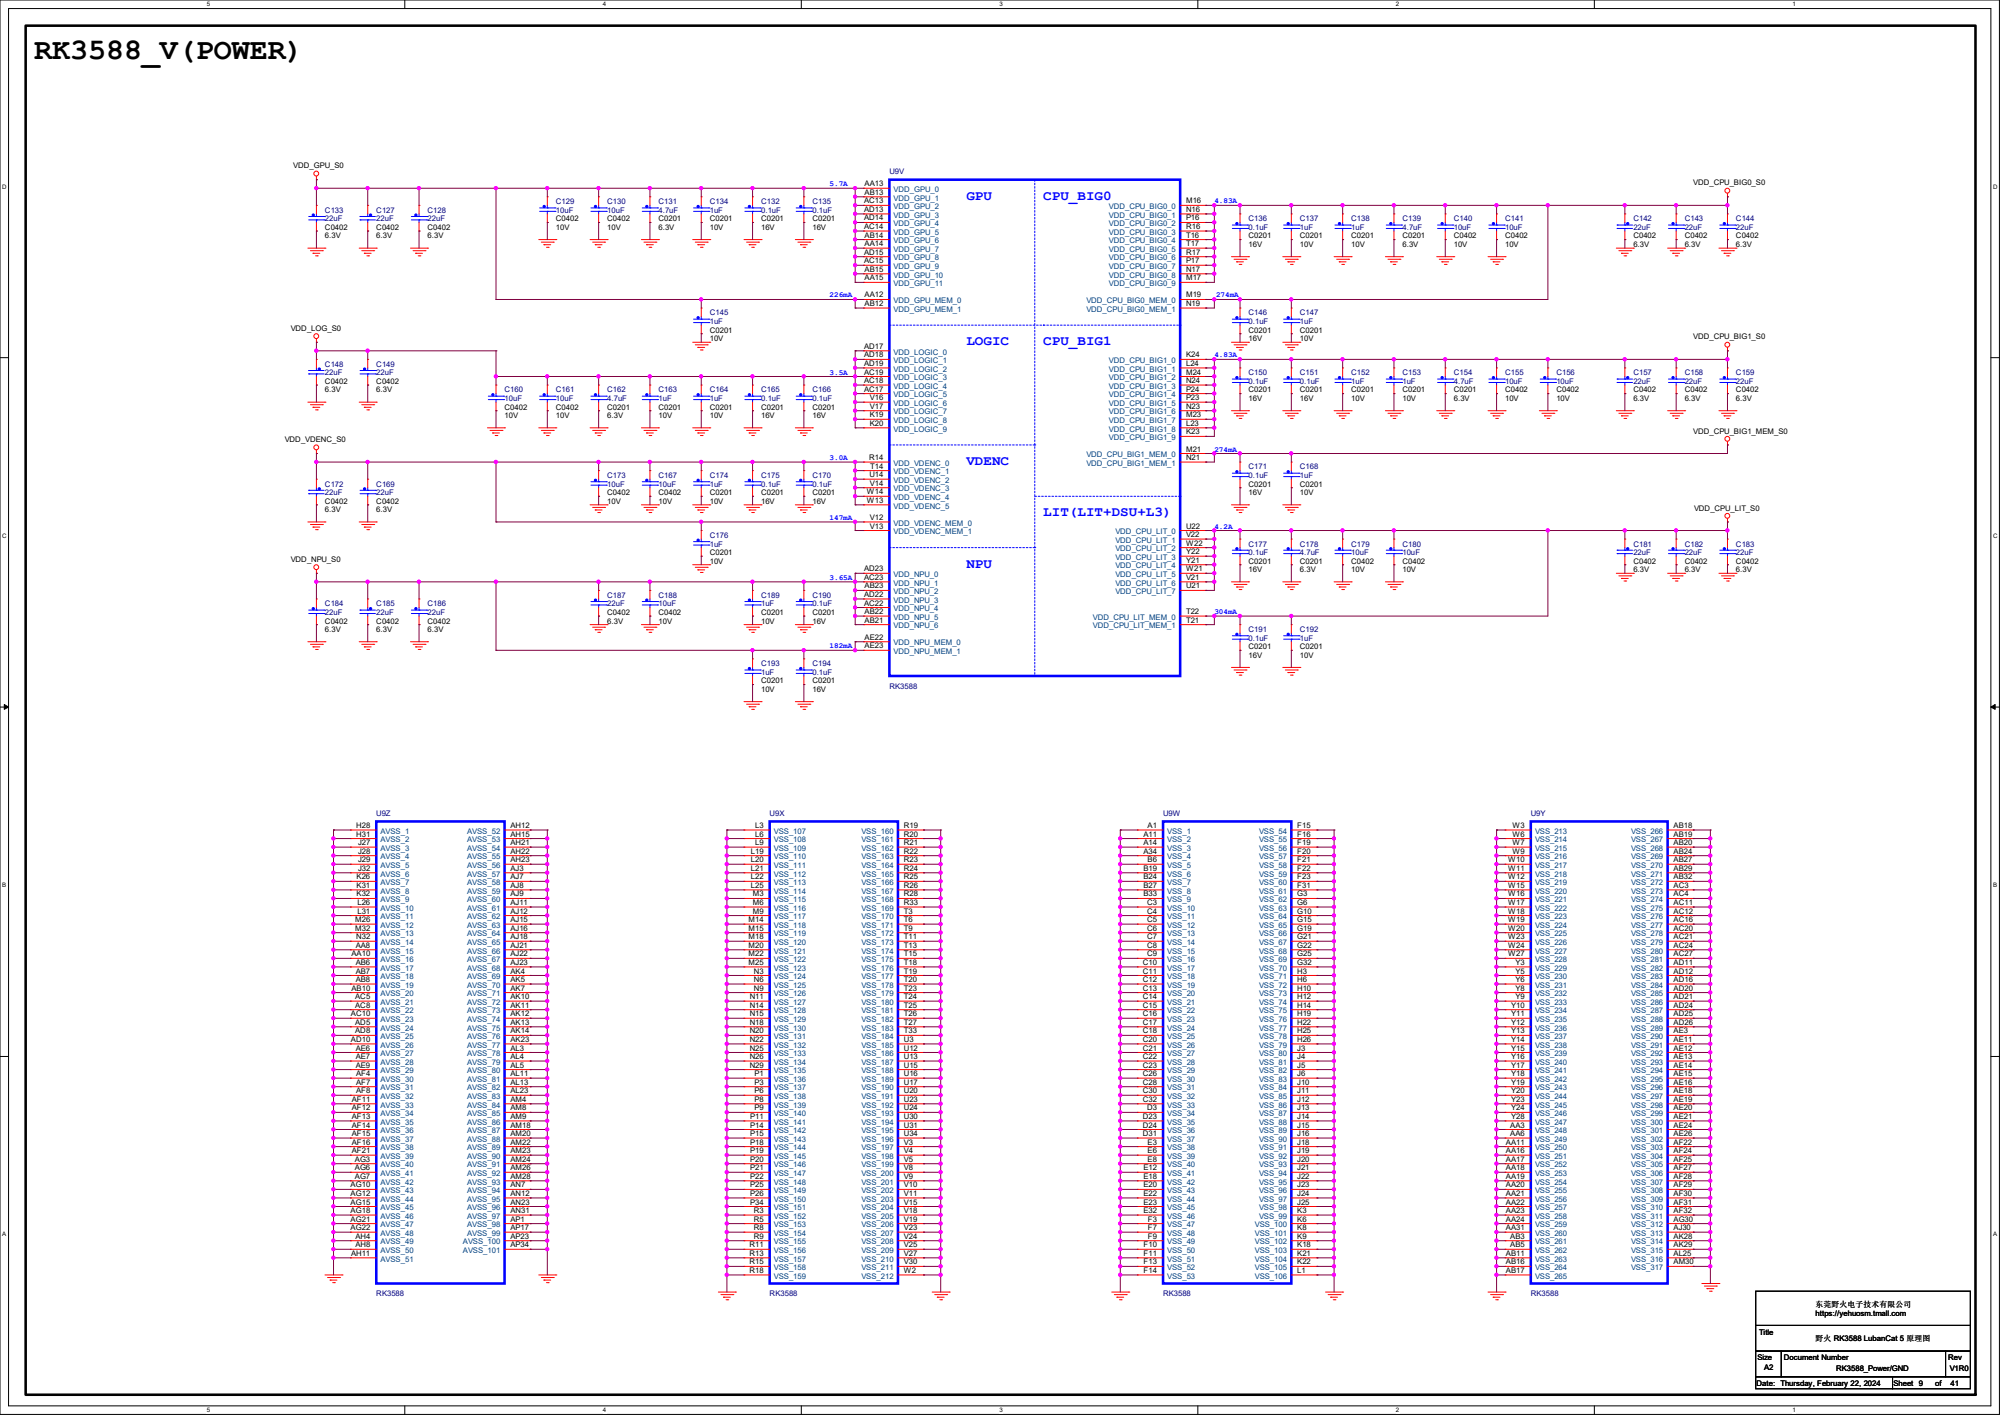
[picture p12: page 9]

东莞野火电子技术有限公司 https://yehuosm.tmall.com

# RK3588_E(OSC/PLL/PMUIO1/2)

# PMUIO1 Domain

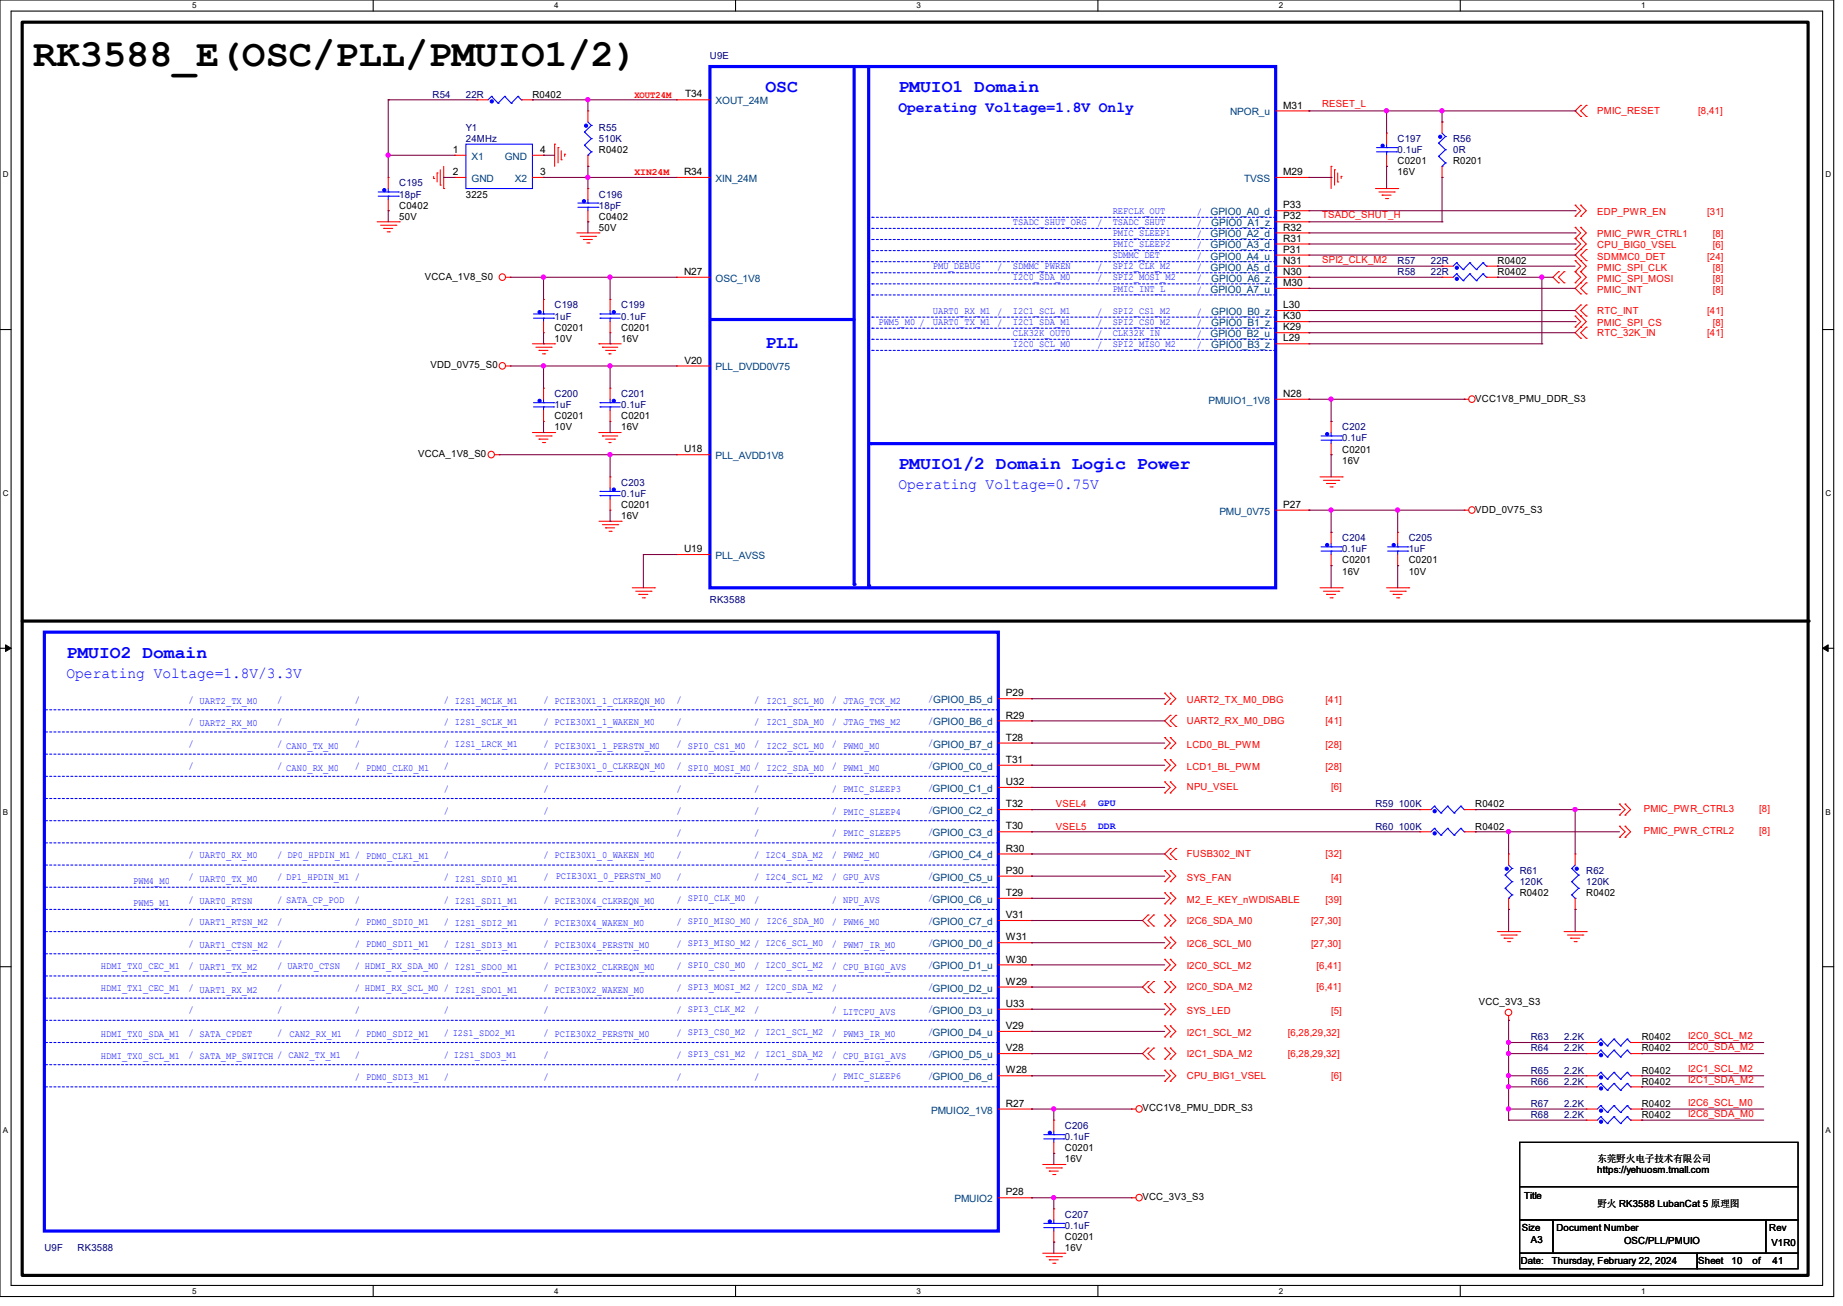
[picture p13: page 10]

东莞野火电子技术有限公司 https://yehuosm.tmall.com

# RK3588(DDR PHY)

# DDR_CH1_DM0_C F8 DDR_CH1_ZQ_C G8

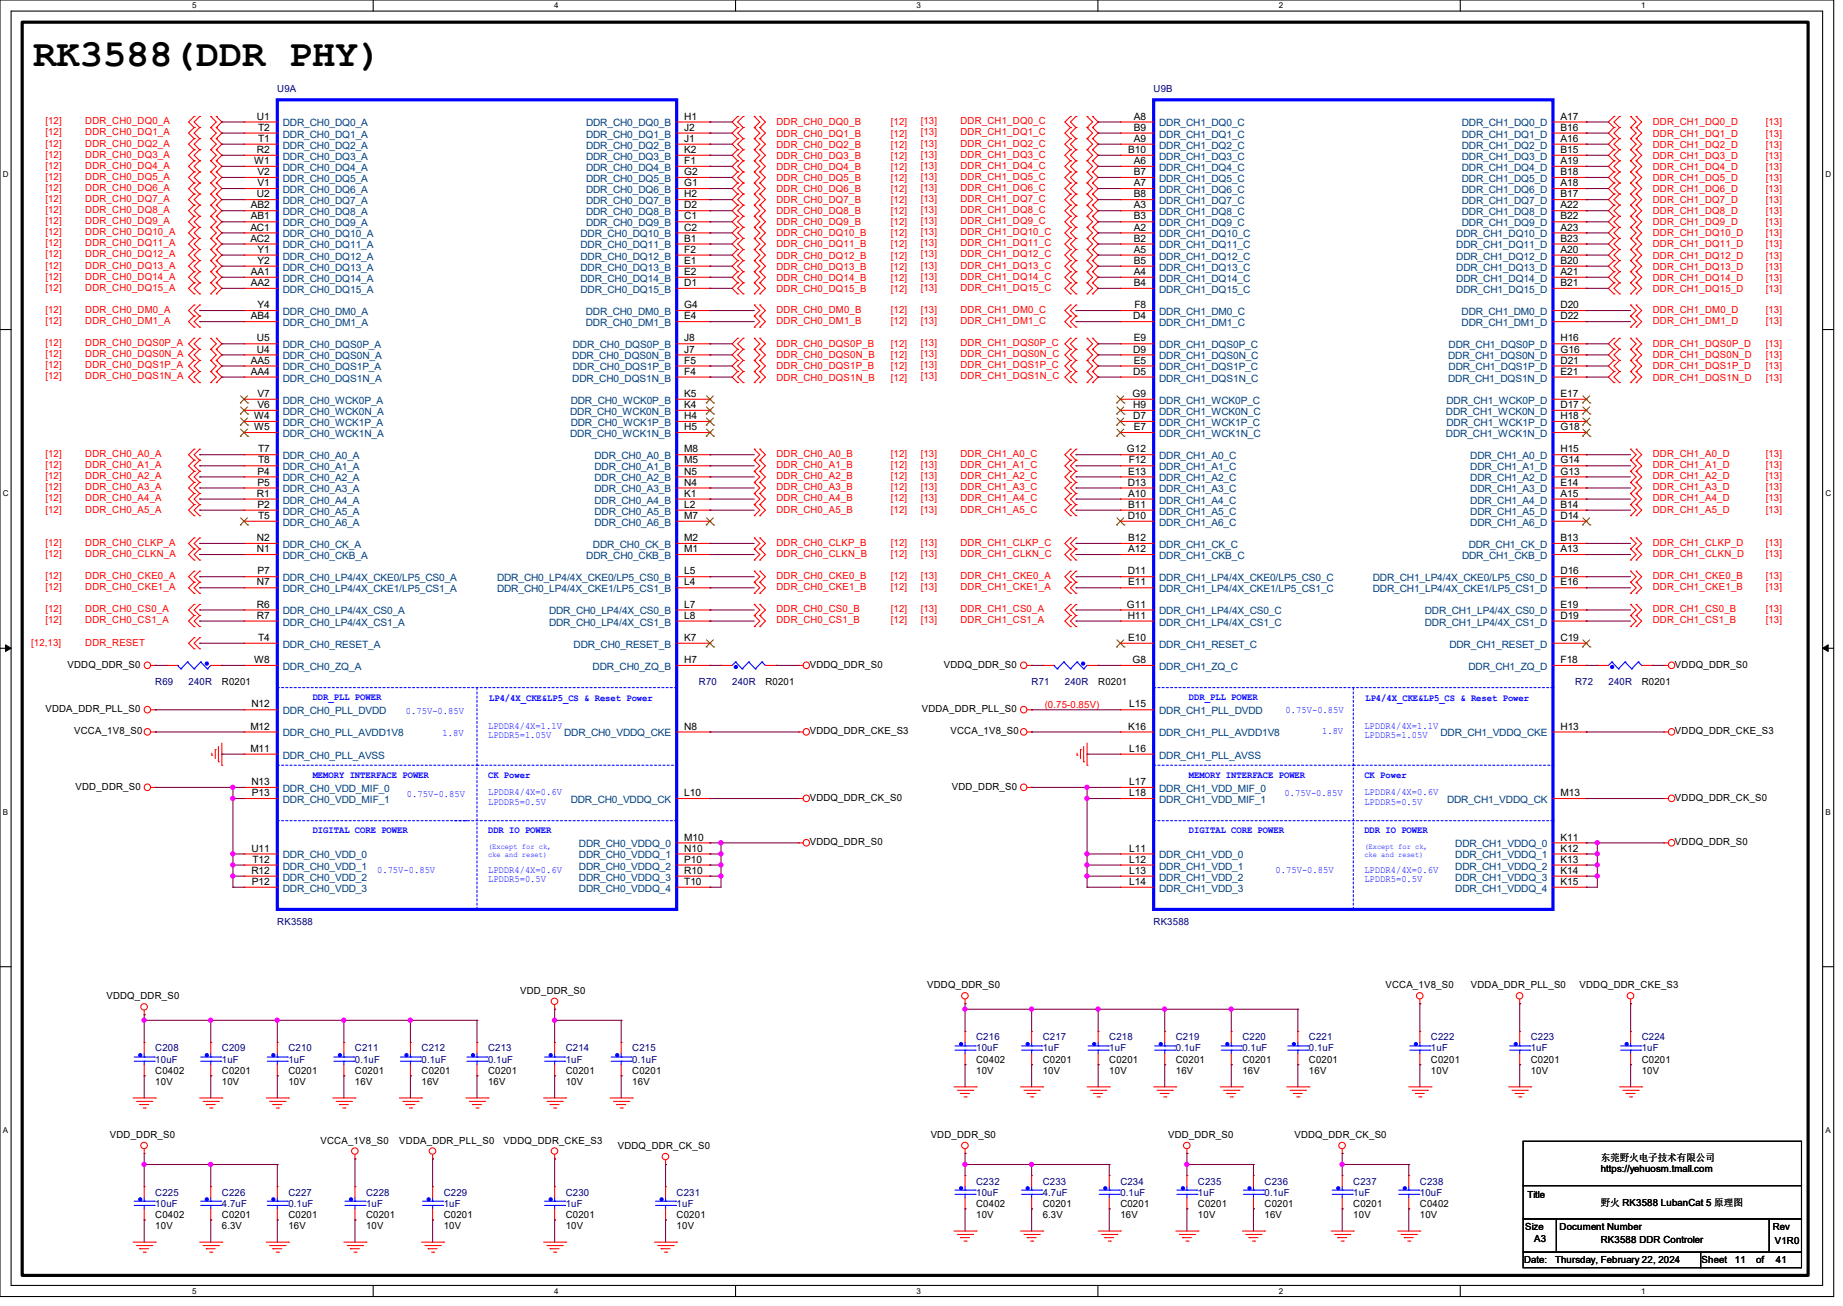
[picture p14: page 11]

东莞野火电子技术有限公司 https://yehuosm.tmall.com

# LPDDR4/4x_01

# VCC1V8_PMU_DDR_S3 VDD2_DDR_S3 VDDQ_DDR

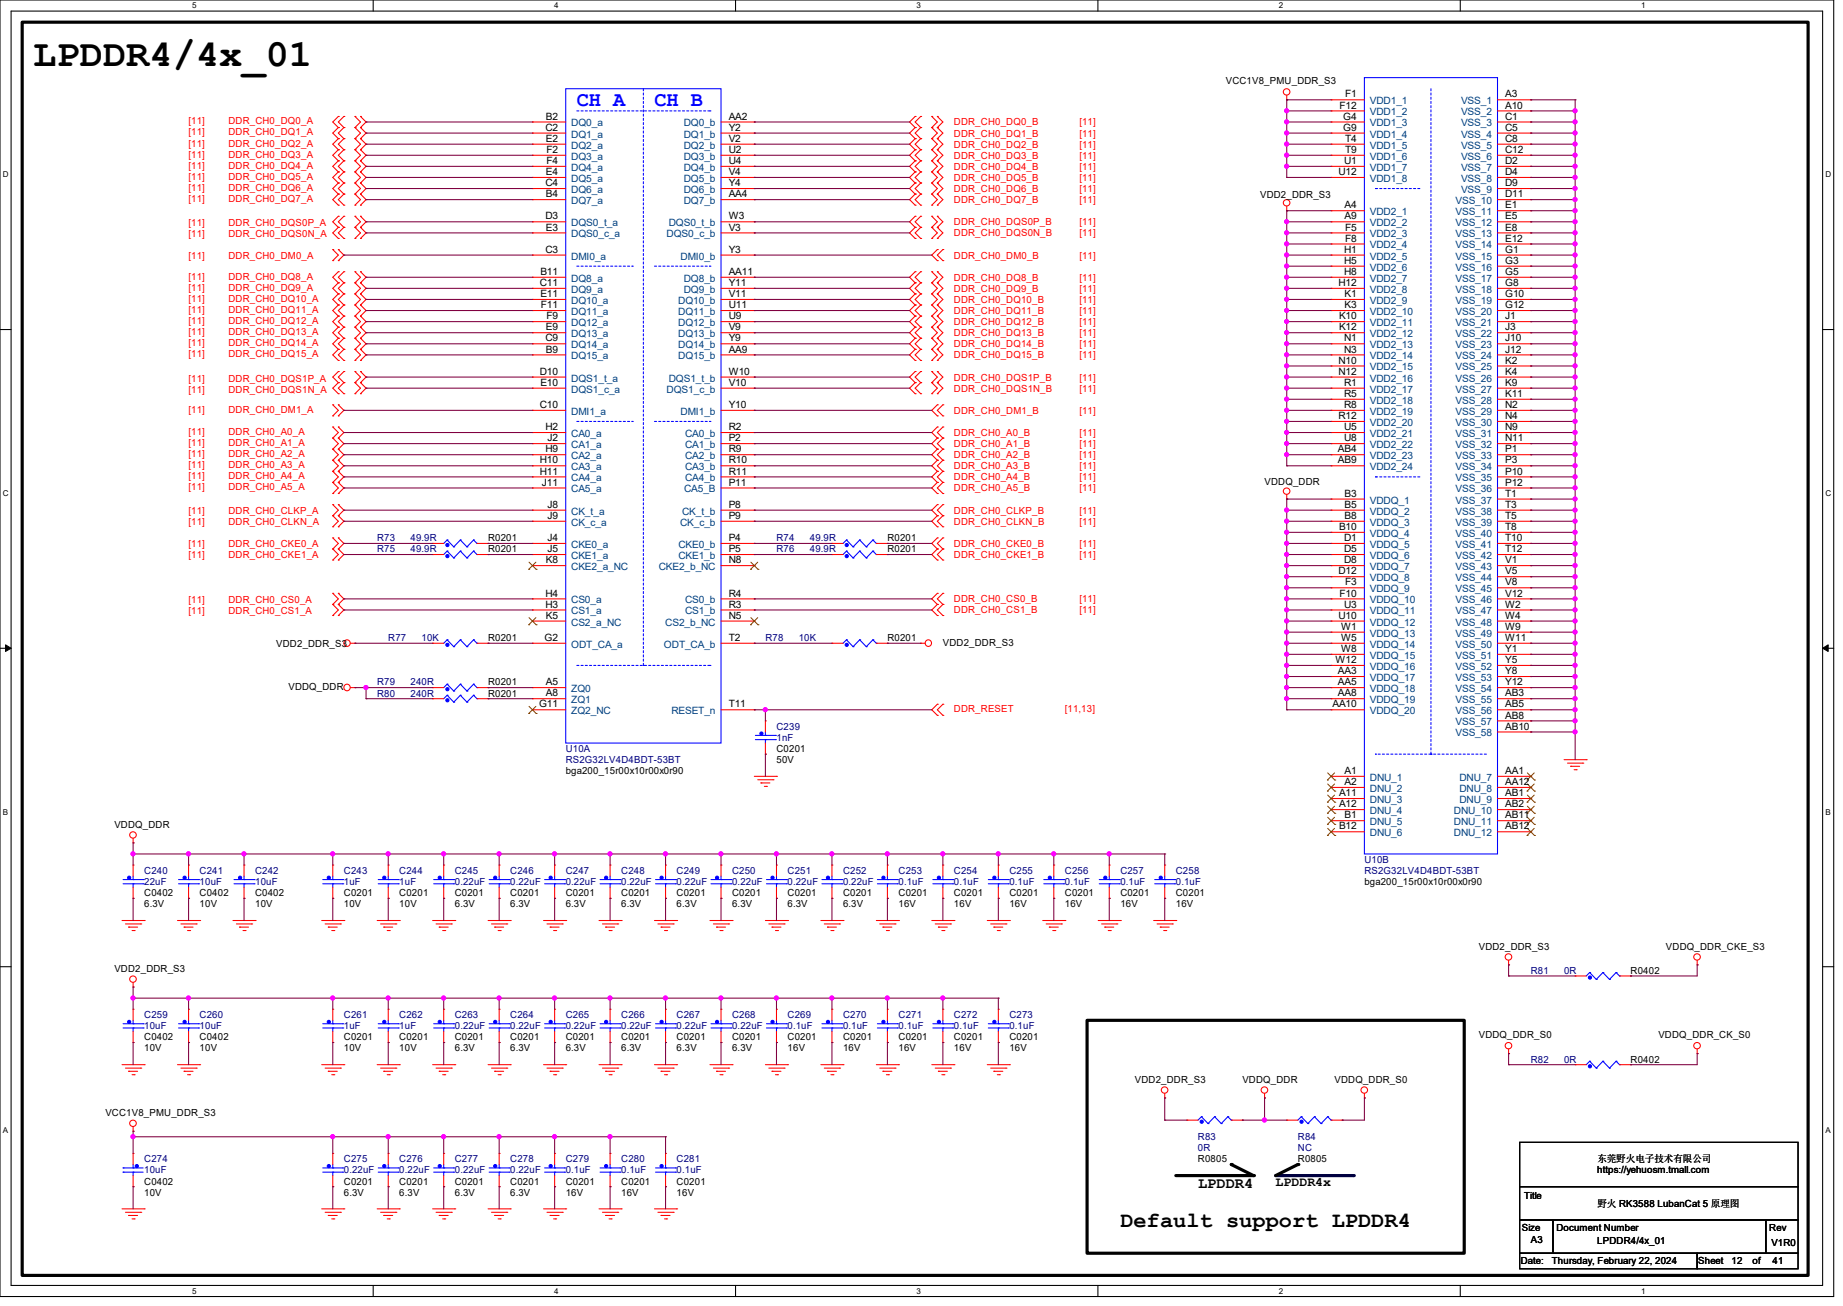
[picture p15: page 12]

东莞野火电子技术有限公司 https://yehuosm.tmall.com

D D

# LPDDR4/4x_02

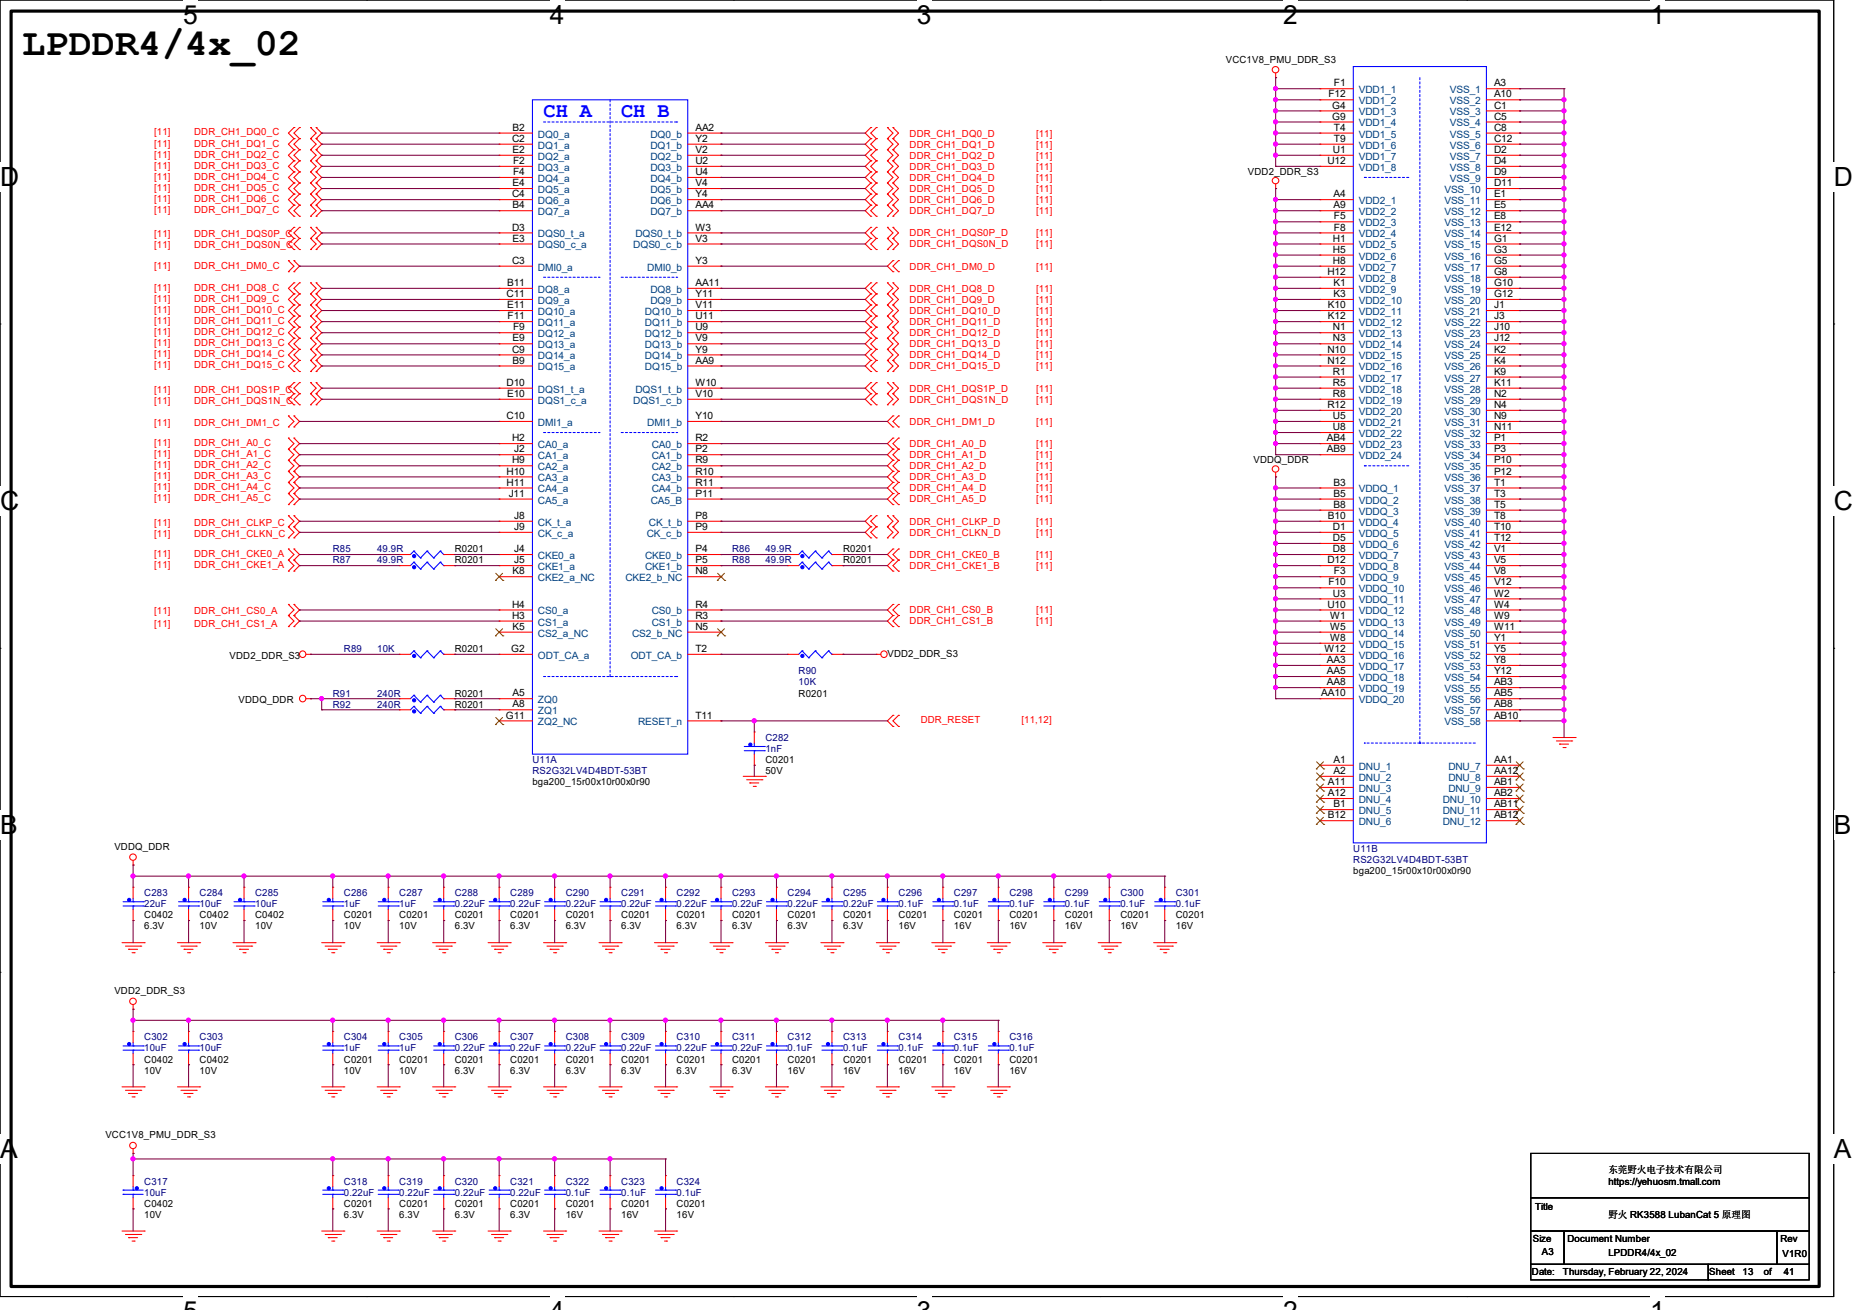
[picture p16: page 13]

东莞野火电子技术有限公司 https://yehuosm.tmall.com

# RK3588_C(EMMCIO Domain)

EMMC_D0 | [24]

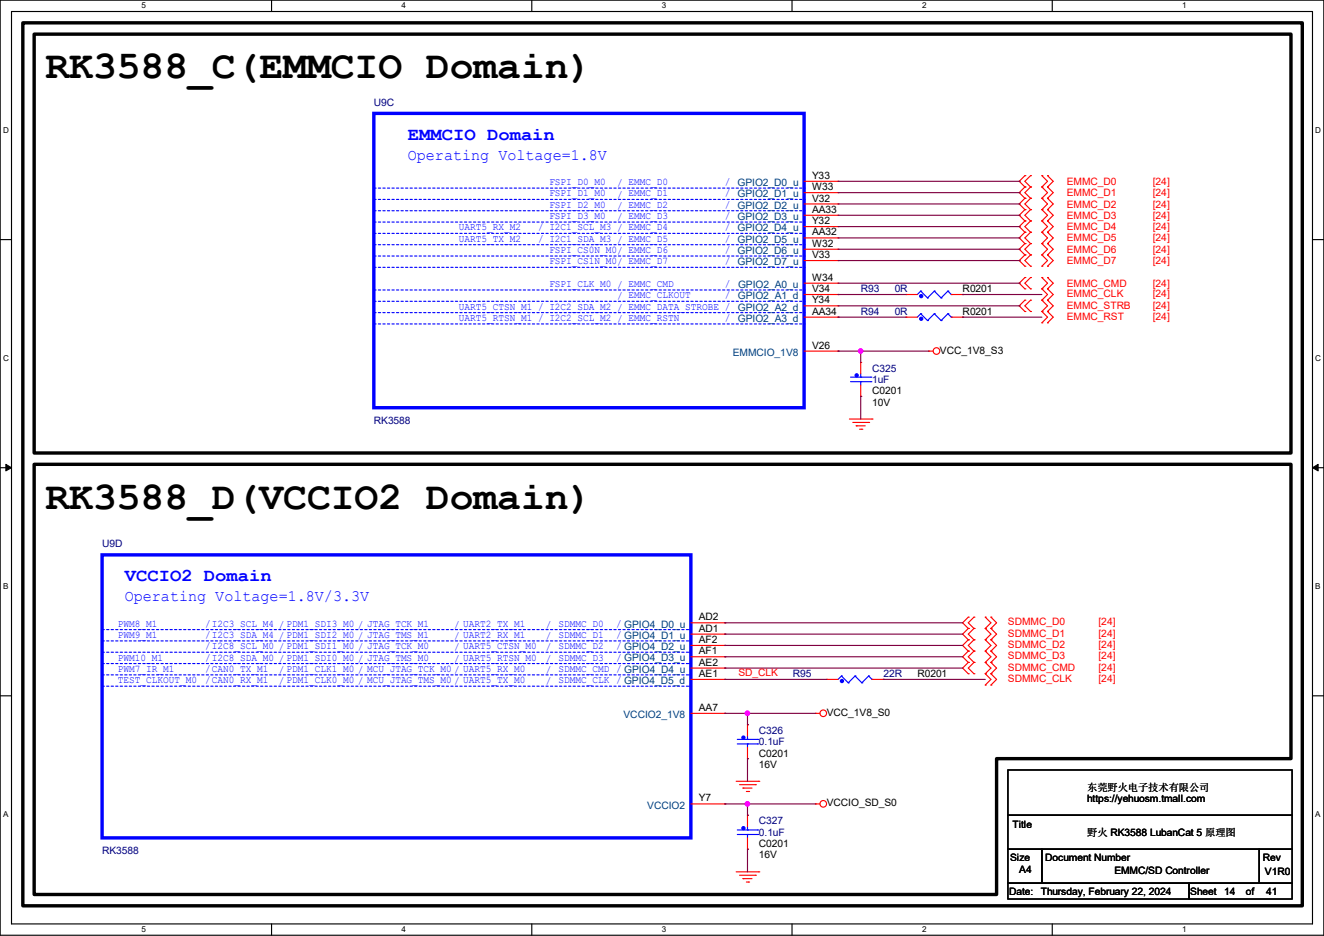
[picture p17: page 14]

东莞野火电子技术有限公司
https://yehuosm.tmall.com

RK3588_M(TYPEC/DP) | RK3588_L(USB2.0 HOST/OTG)

## USB:U3/Gen1----Controller0

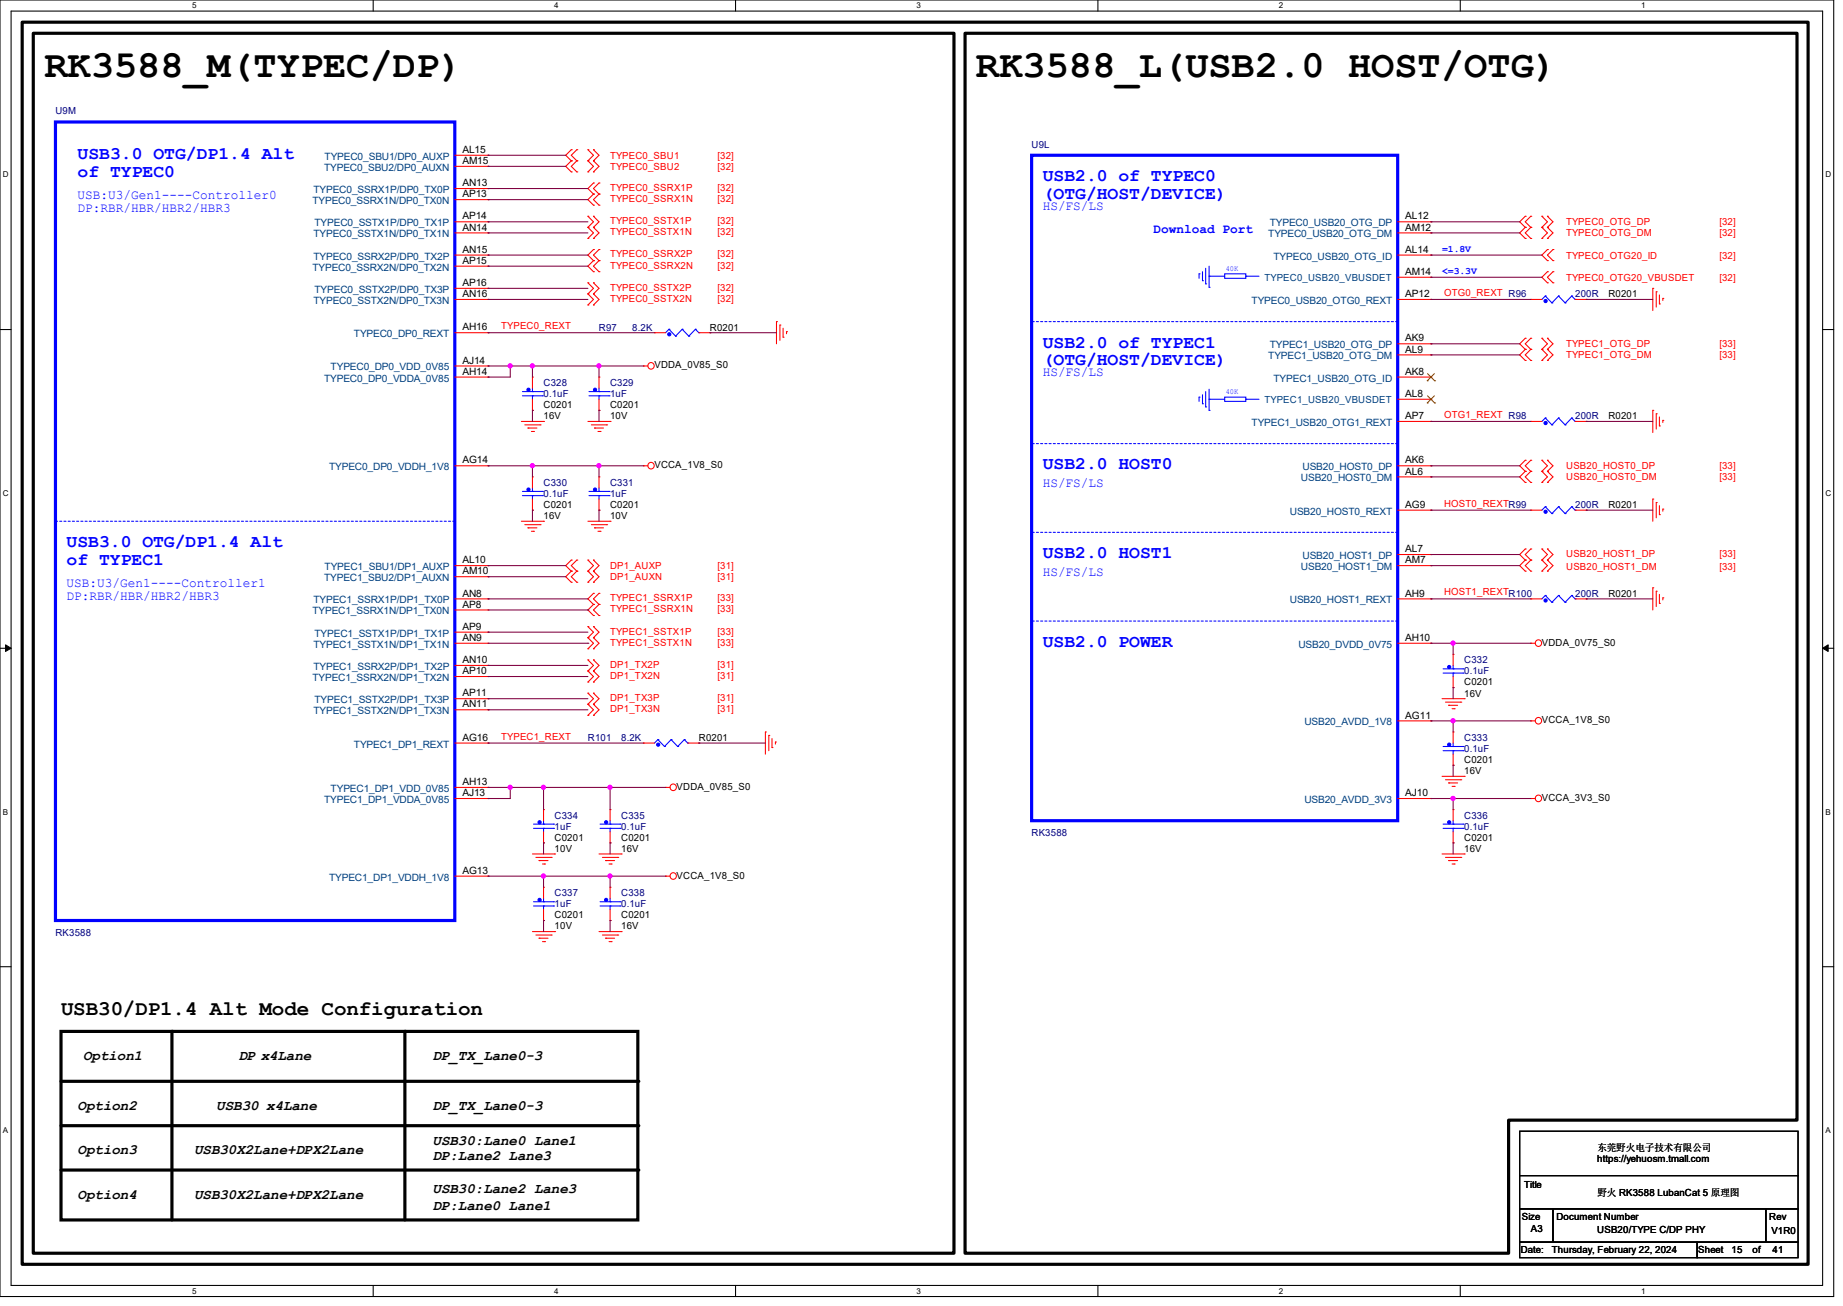
[picture p18: page 15]

东莞野火电子技术有限公司 https://yehuosm.tmall.com

RK3588_G(VCCIO1 Domain) | RK3588_U(SARADC/OTP)

## 12-bit 1MS/s

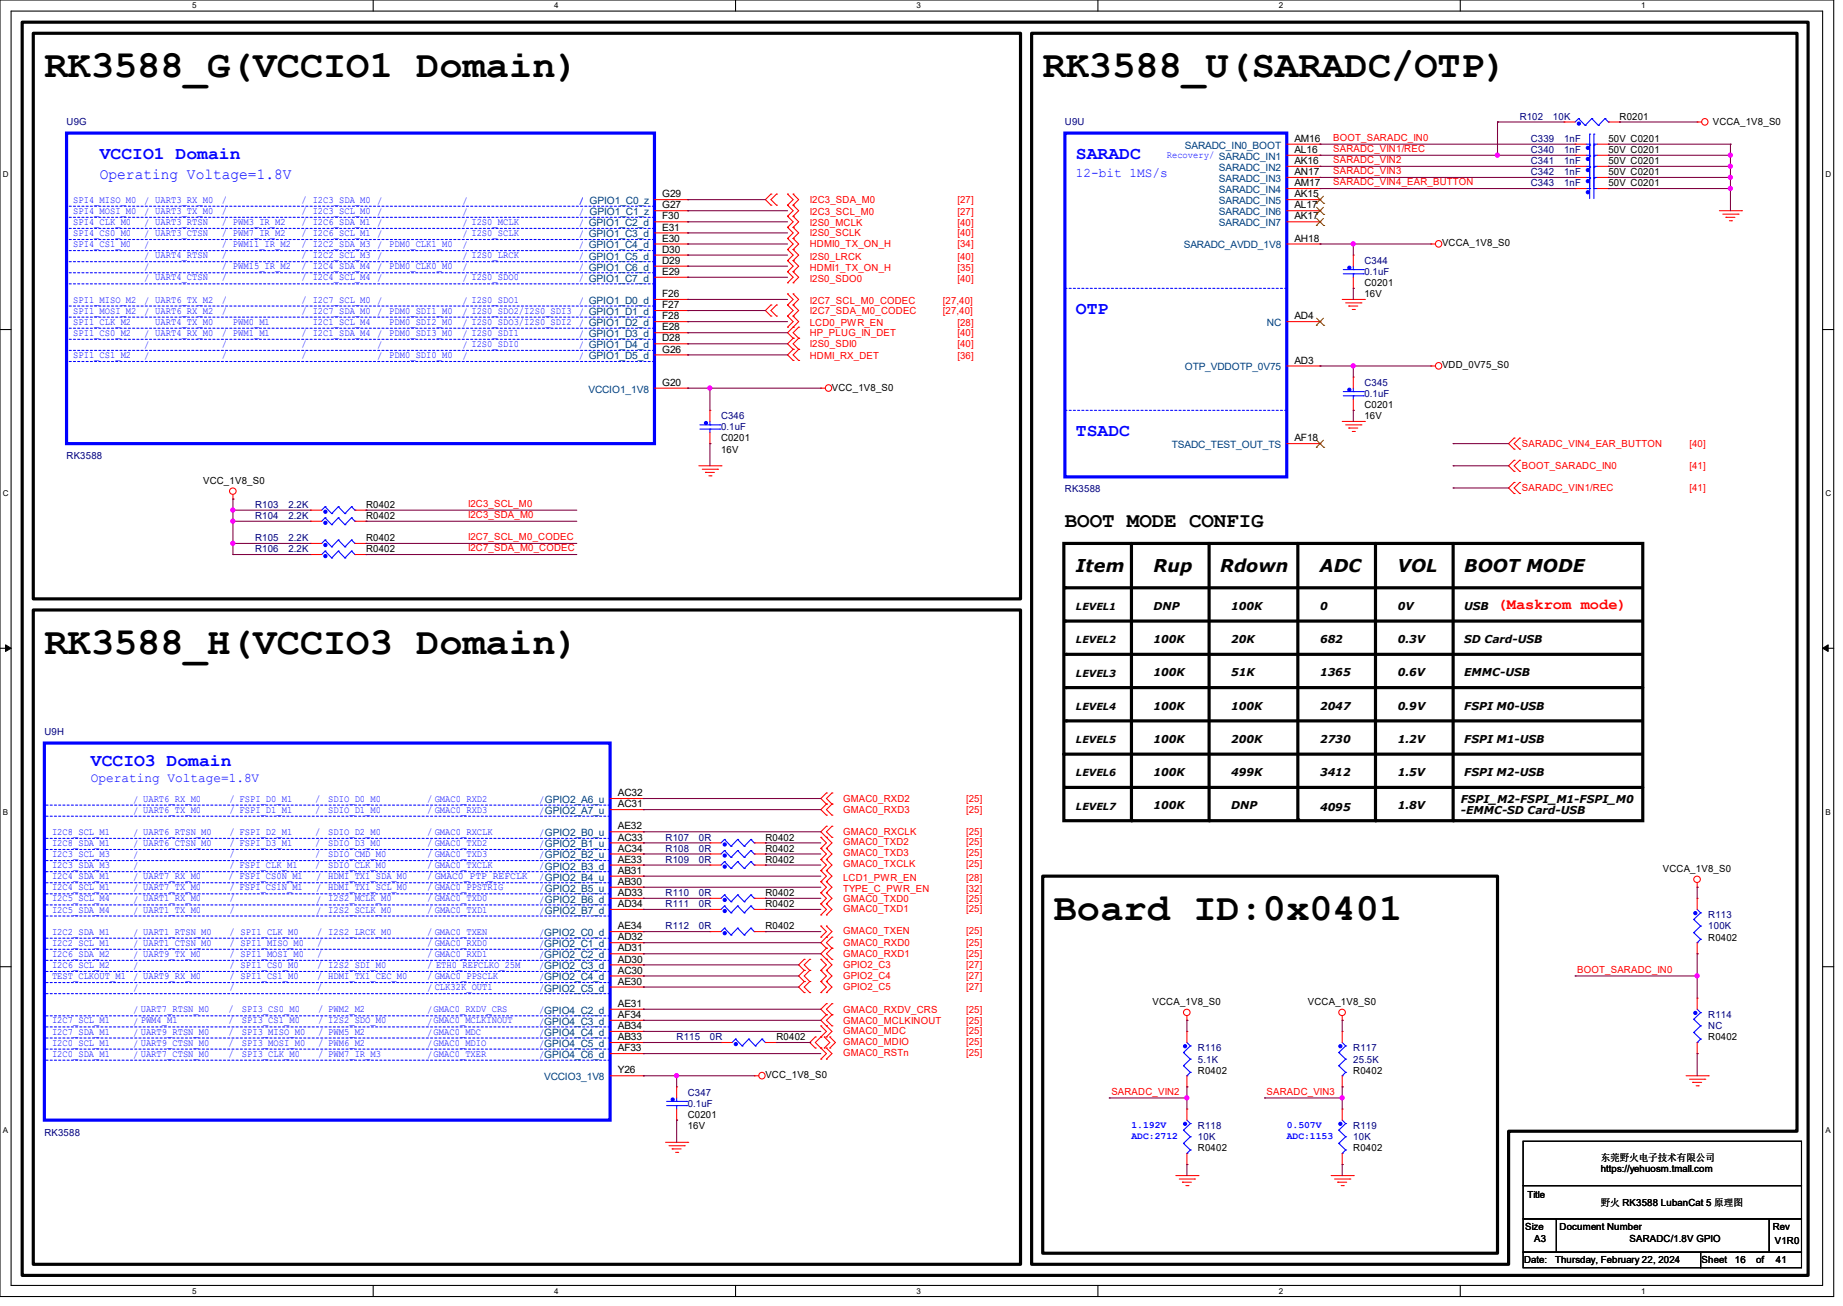
[picture p19: page 16]

FSPI_M2-FSPI_M1-FSPI_M0
-EMMC-SD Card-USB

东莞野火电子技术有限公司 https://yehuosm.tmall.com

# RK3588_Q/R(MIPI_D/C_PHY0)

## TX and RX port must

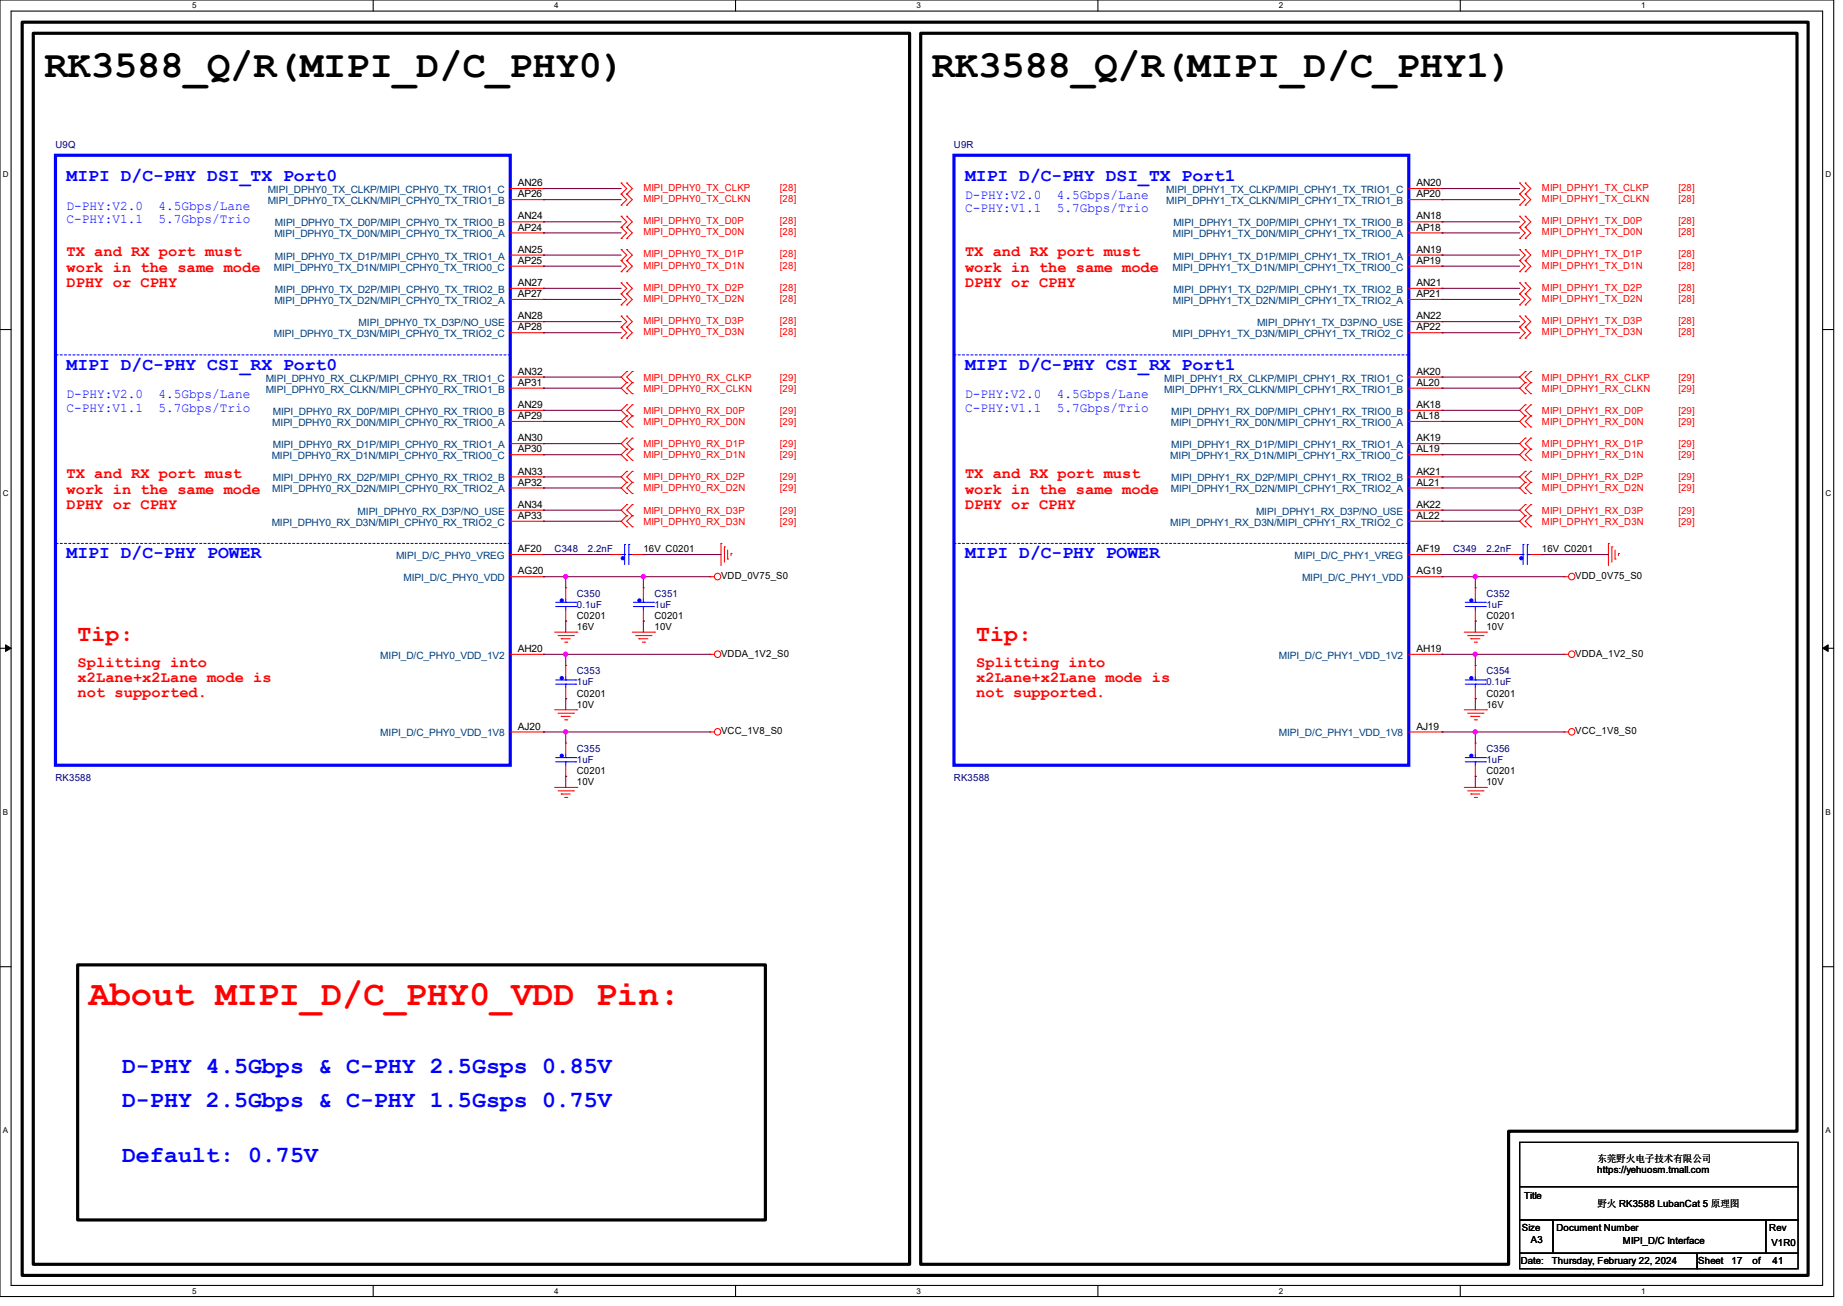
[picture p20: page 17]

TX and RX port must
work in the same mode
DPHY or CPHY

东莞野火电子技术有限公司 https://yehuosm.tmall.com

D D

# x2Lane

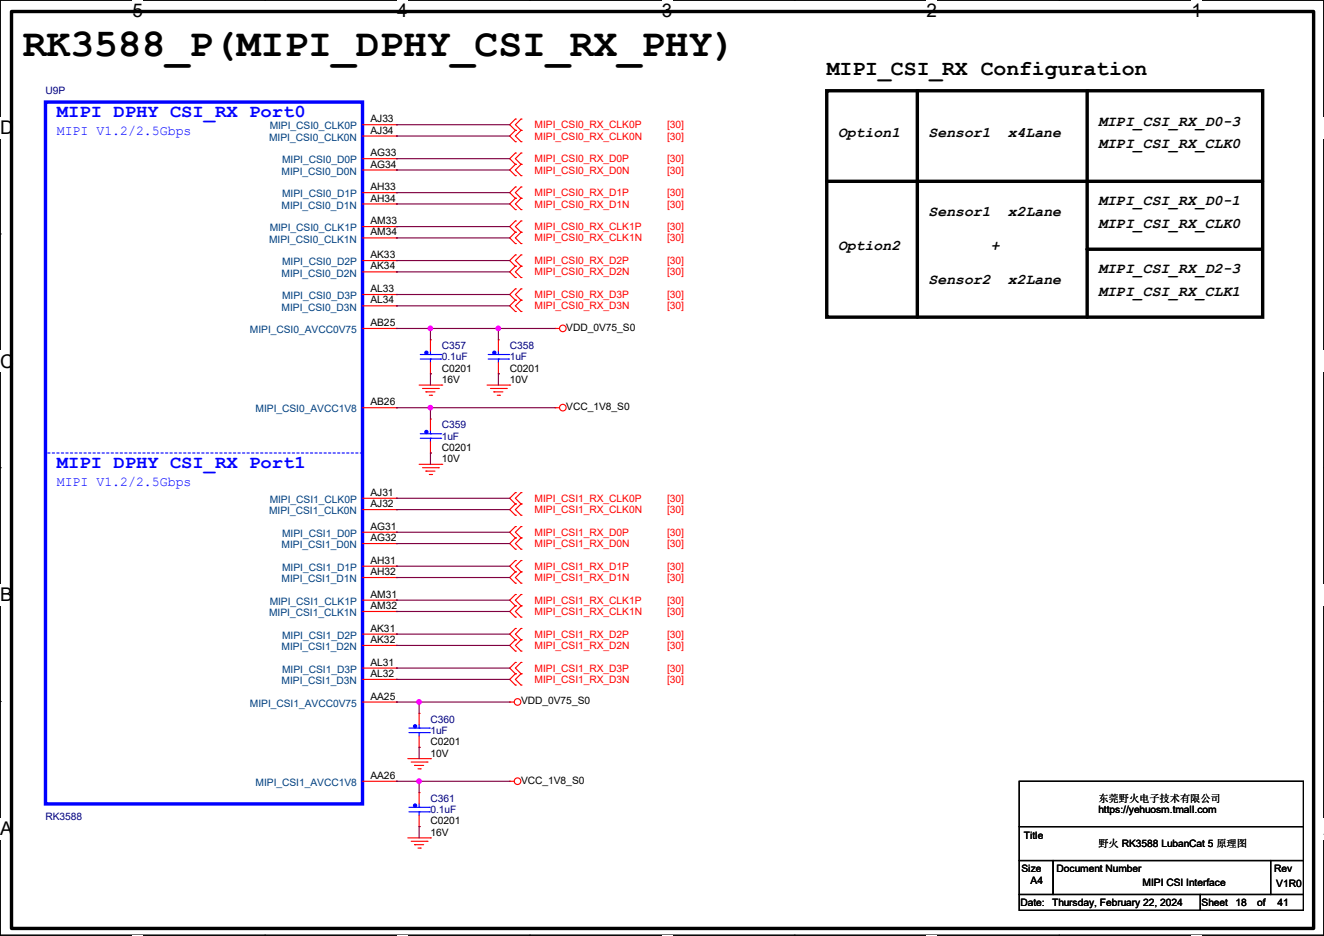
[picture p21: page 18]
Sensor2; Sensor1; x2Lane; Sensor1 x4Lane; MIPI_CSI_RX_D0-3 MIPI_CSI_RX_CLK0; MIPI_CSI_RX_D0-1 MIPI_CSI_RX_CLK0; MIPI_CSI_RX_D2-3 MIPI_CSI_RX_CLK1; Option1; Option2; MIPI_CSI_RX Configuration; RK3588_P(MIPI_DPHY_CSI_RX_PHY); VDD_0V75_S0; VCC_1V8_S0; MIPI_CSI0_RX_CLK0P; MIPI_CSI0_RX_CLK0N; MIPI_CSI0_RX_D0P; MIPI_CSI0_RX_D0N; MIPI_CSI0_RX_D1P; MIPI_CSI0_RX_D1N; MIPI_CSI0_RX_D2P; MIPI_CSI0_RX_D2N; MIPI_CSI0_RX_D3P; MIPI_CSI0_RX_D3N; MIPI_CSI1_RX_CLK0N; MIPI_CSI1_RX_CLK0P; MIPI_CSI1_RX_D0P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

东莞野火电子技术有限公司
https://yehuosm.tmall.com

野火 RK3588 LubanCat 5 原理图

RK3588_S(HDMI2.1 TX) | RK3588_T(HDMI20 RX)
HDMI:V2.1 | 12Gbps

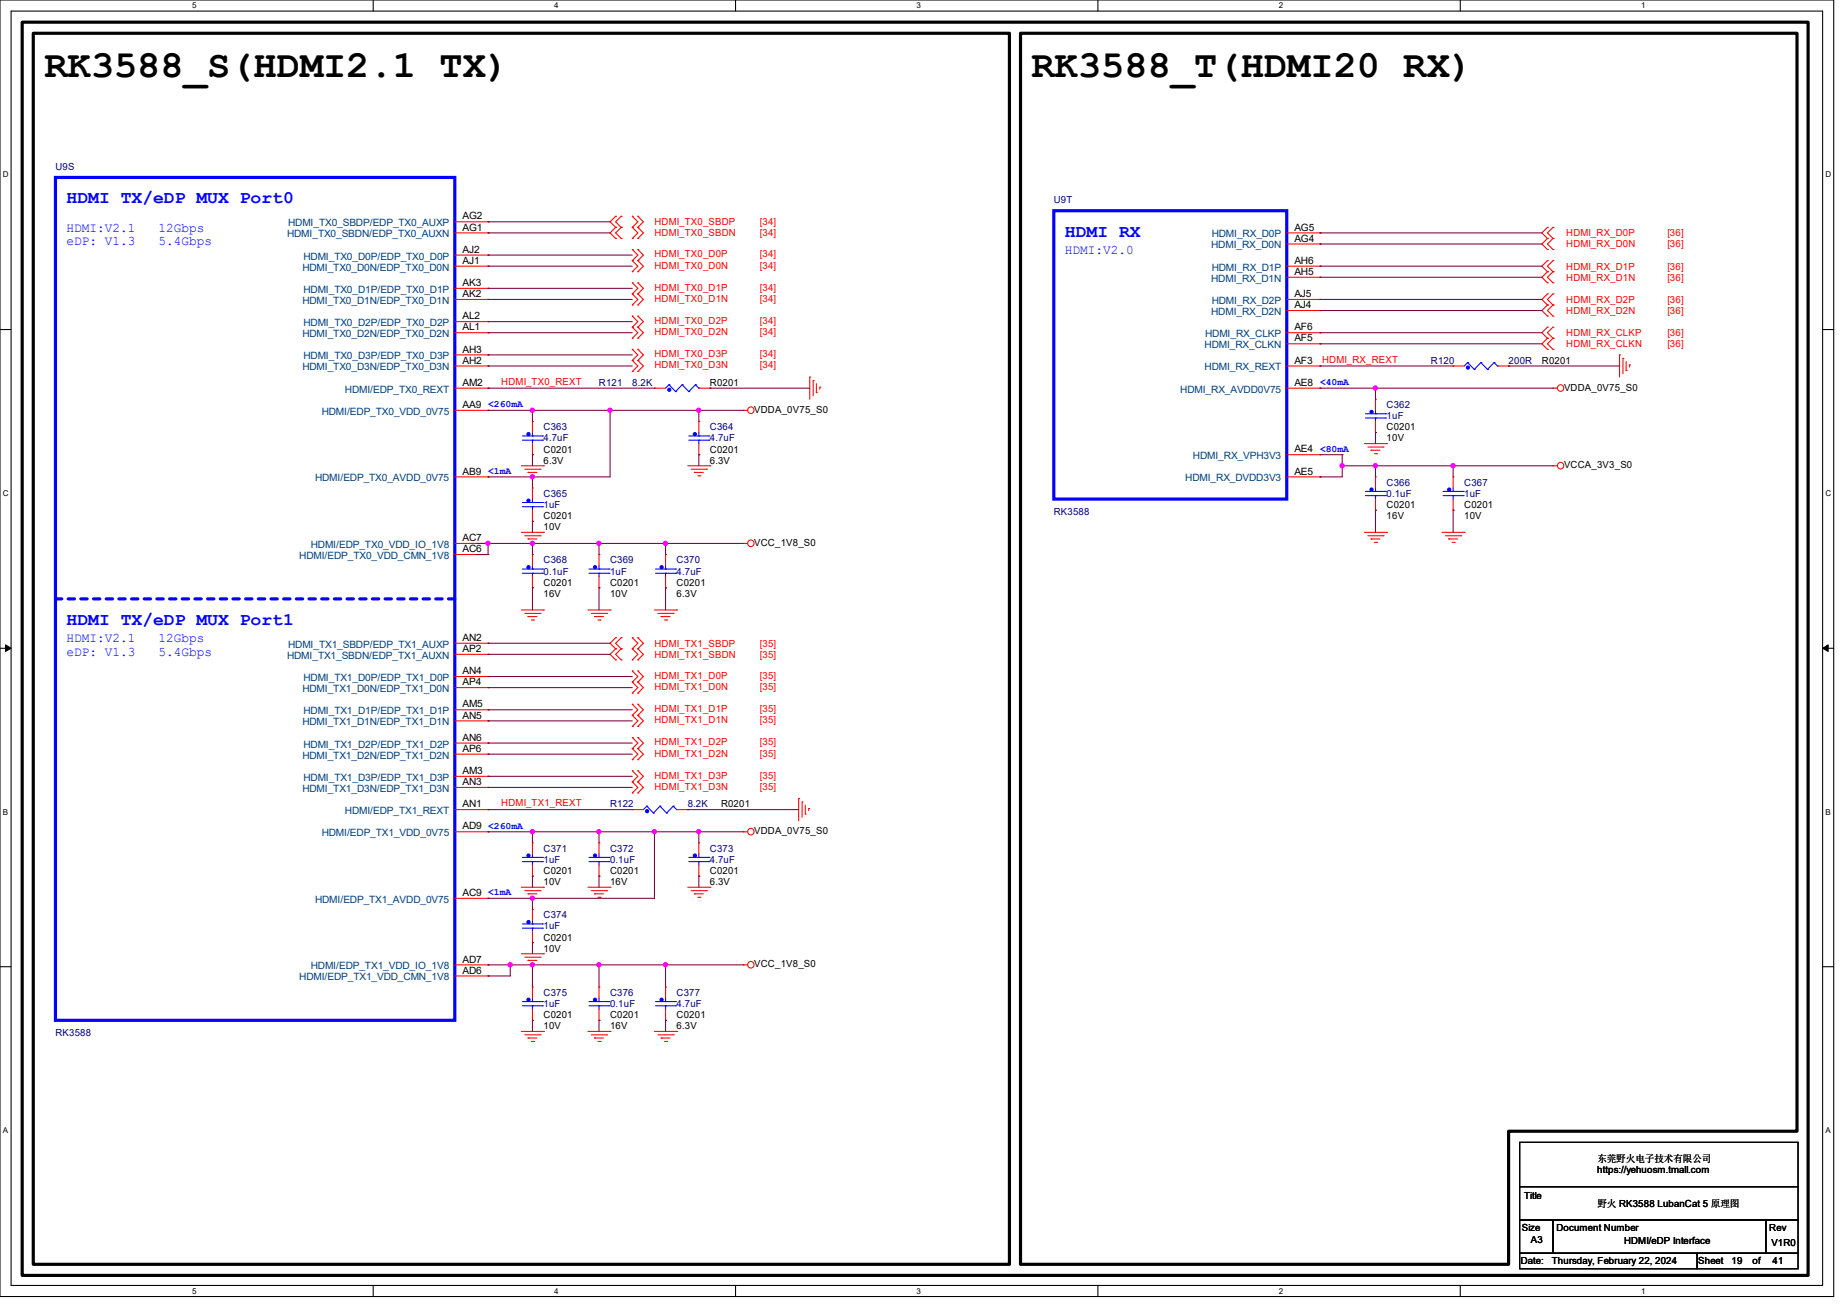
[picture p22: page 19]

HDMI TX/eDP MUX Port0

HDMI TX/eDP MUX Port1

东莞野火电子技术有限公司 https://yehuosm.tmall.com

RK3588_N(PCIE20) | RK3588_O(PCIE30)

## Only PCIE3.0 Controller 0

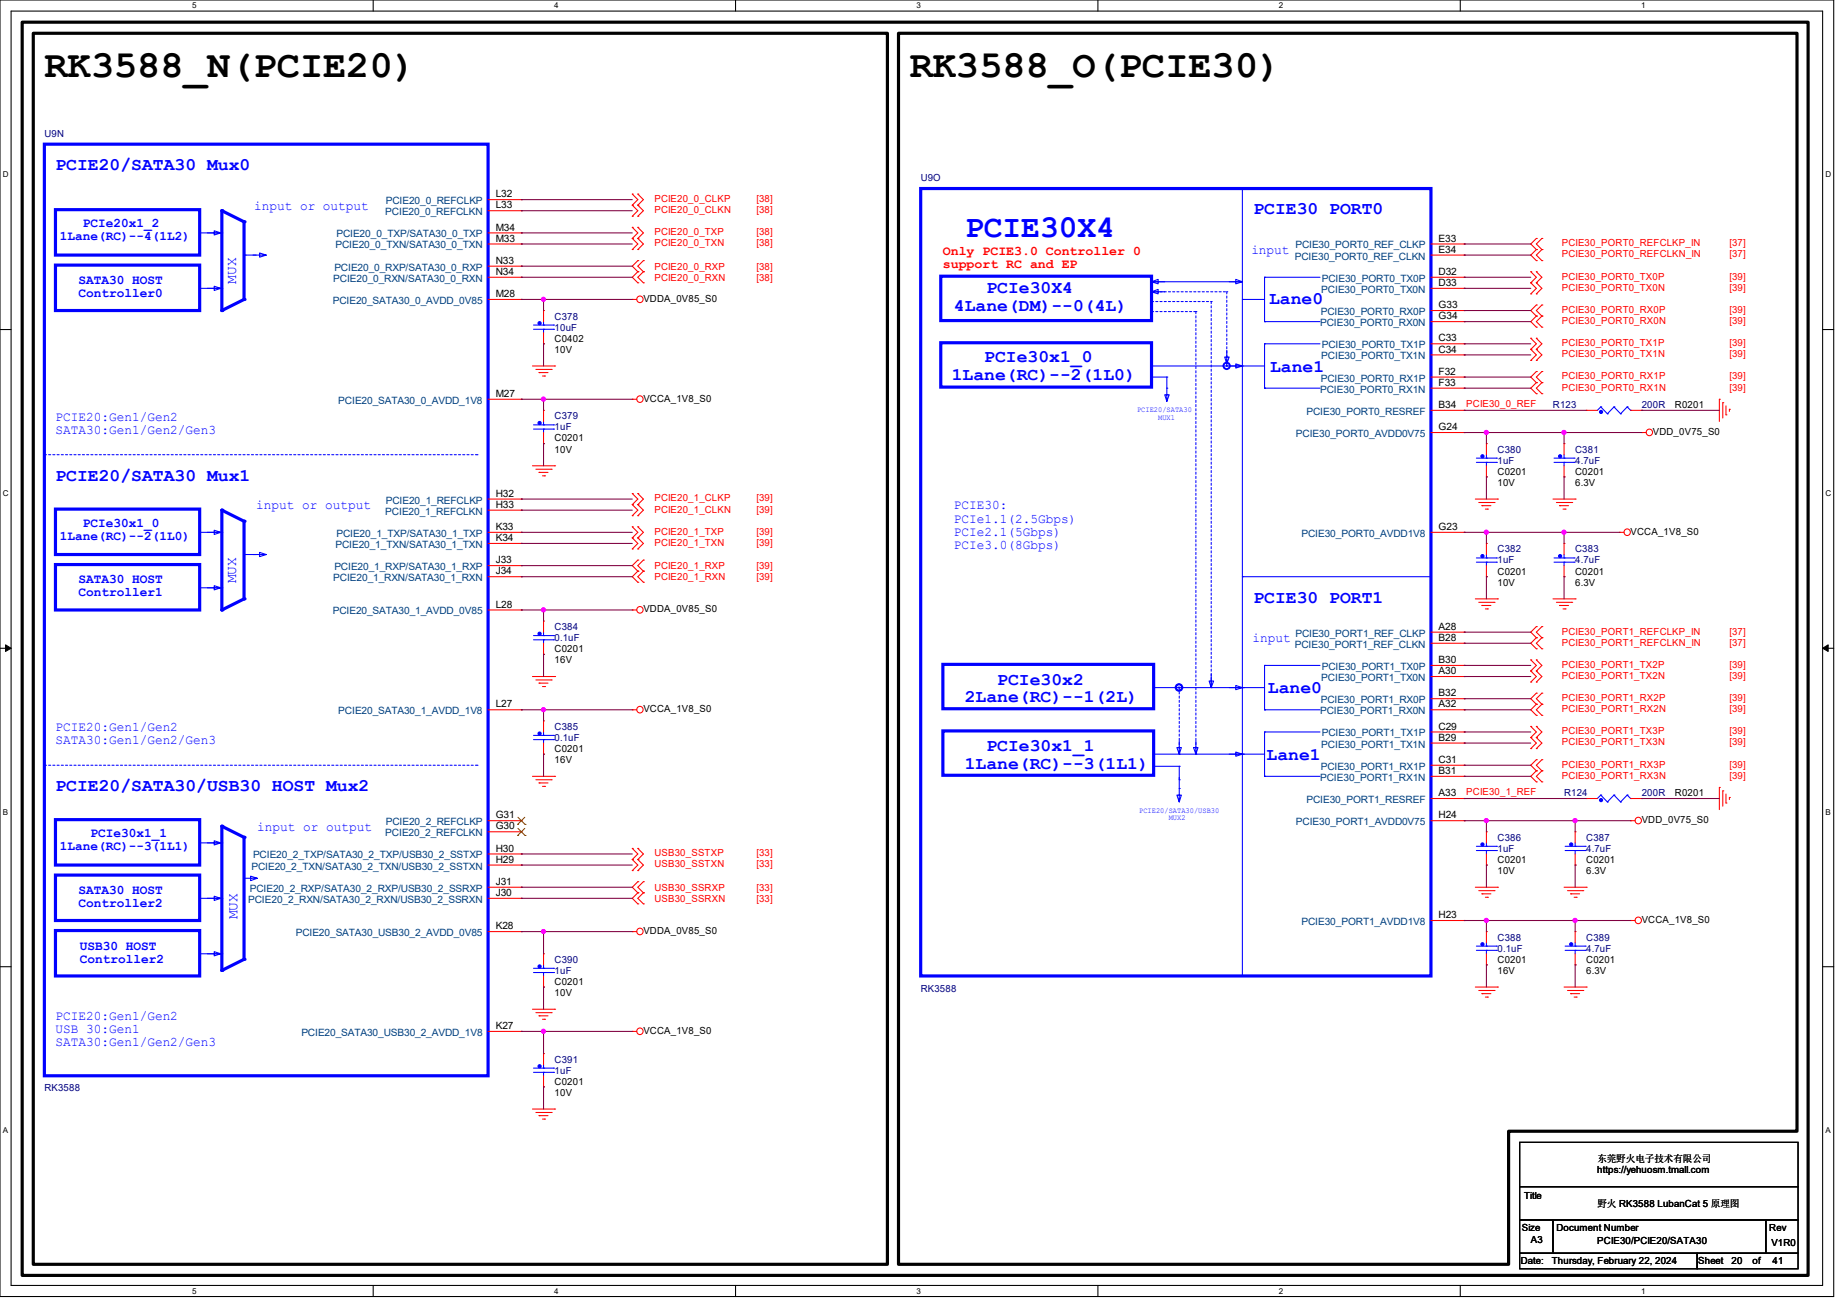
[picture p23: page 20]

东莞野火电子技术有限公司 https://yehuosm.tmall.com

D D

# RK3588_I(VCCIO4 Domain)

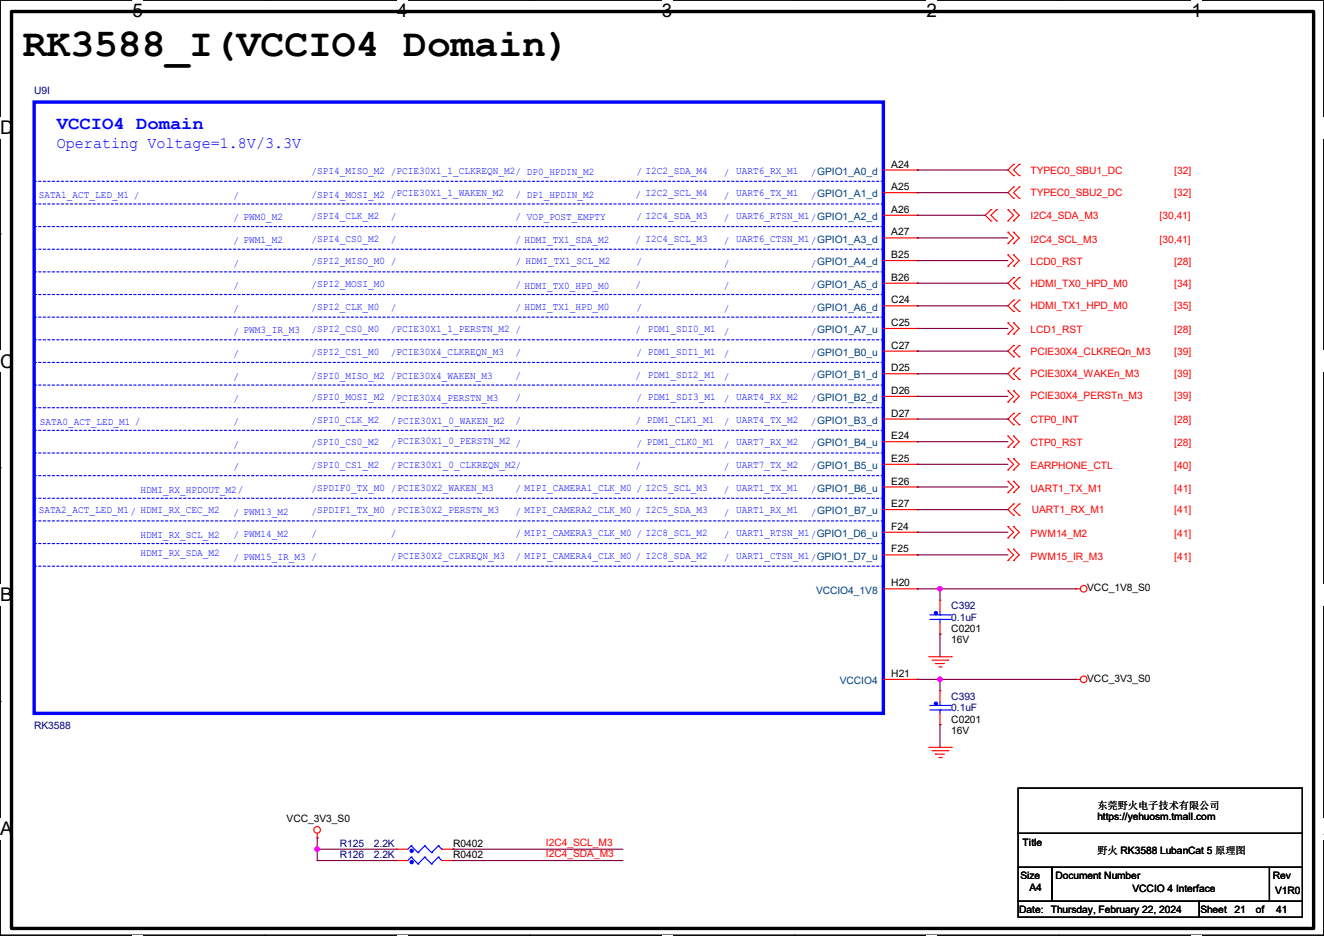
[picture p24: page 21]

东莞野火电子技术有限公司
https://yehuosm.tmall.com

# RK3588_J(VCCIO5 Domain)

GMAC1_RXD2 | [26] GMAC1_RXD3 | [26] GMAC1_RXCLK | [26] GMAC1_TXCLK | [26] GMAC1_TXD2 | [26] GMAC1_TXD3 | [26] GMAC1_RXD0 | [26] GMAC1_RXD1 | [26] GMAC1_RXDV_CRS | [26] GMAC1_MCLKINOUT | [26] GMAC1_TXD0 | [26] GMAC1_TXD1 | [26] GMAC1_TXEN | [26] GMAC1_MDC | [26] HDMI_TX1_CEC_M2 | [35] HDMI_TX1_SCL_M1 | [35] MINIPCIE_nWDISABLE | [38] PWM3_IR_M1 | [41] GMAC1_MDIO | [26] HDMI_TX1_SDA_M1 | [35] HDMI_RX_SCL_M1 | [36] HDMI_RX_SDA_M1 | [36] HDMI_RX_HPDOUT_M1 | [36] DP1_HPDIN_M0 | [31] PCIE20X1_2_CLKREQN_M0 | [38] PCIE20x1_2_WAKEn_M0 | [38] PCIE20x1_2_PERSTn_M0 | [38] CTP1_RST | [28] GMAC1_RSTn | [26] CTP1_INT | [28]

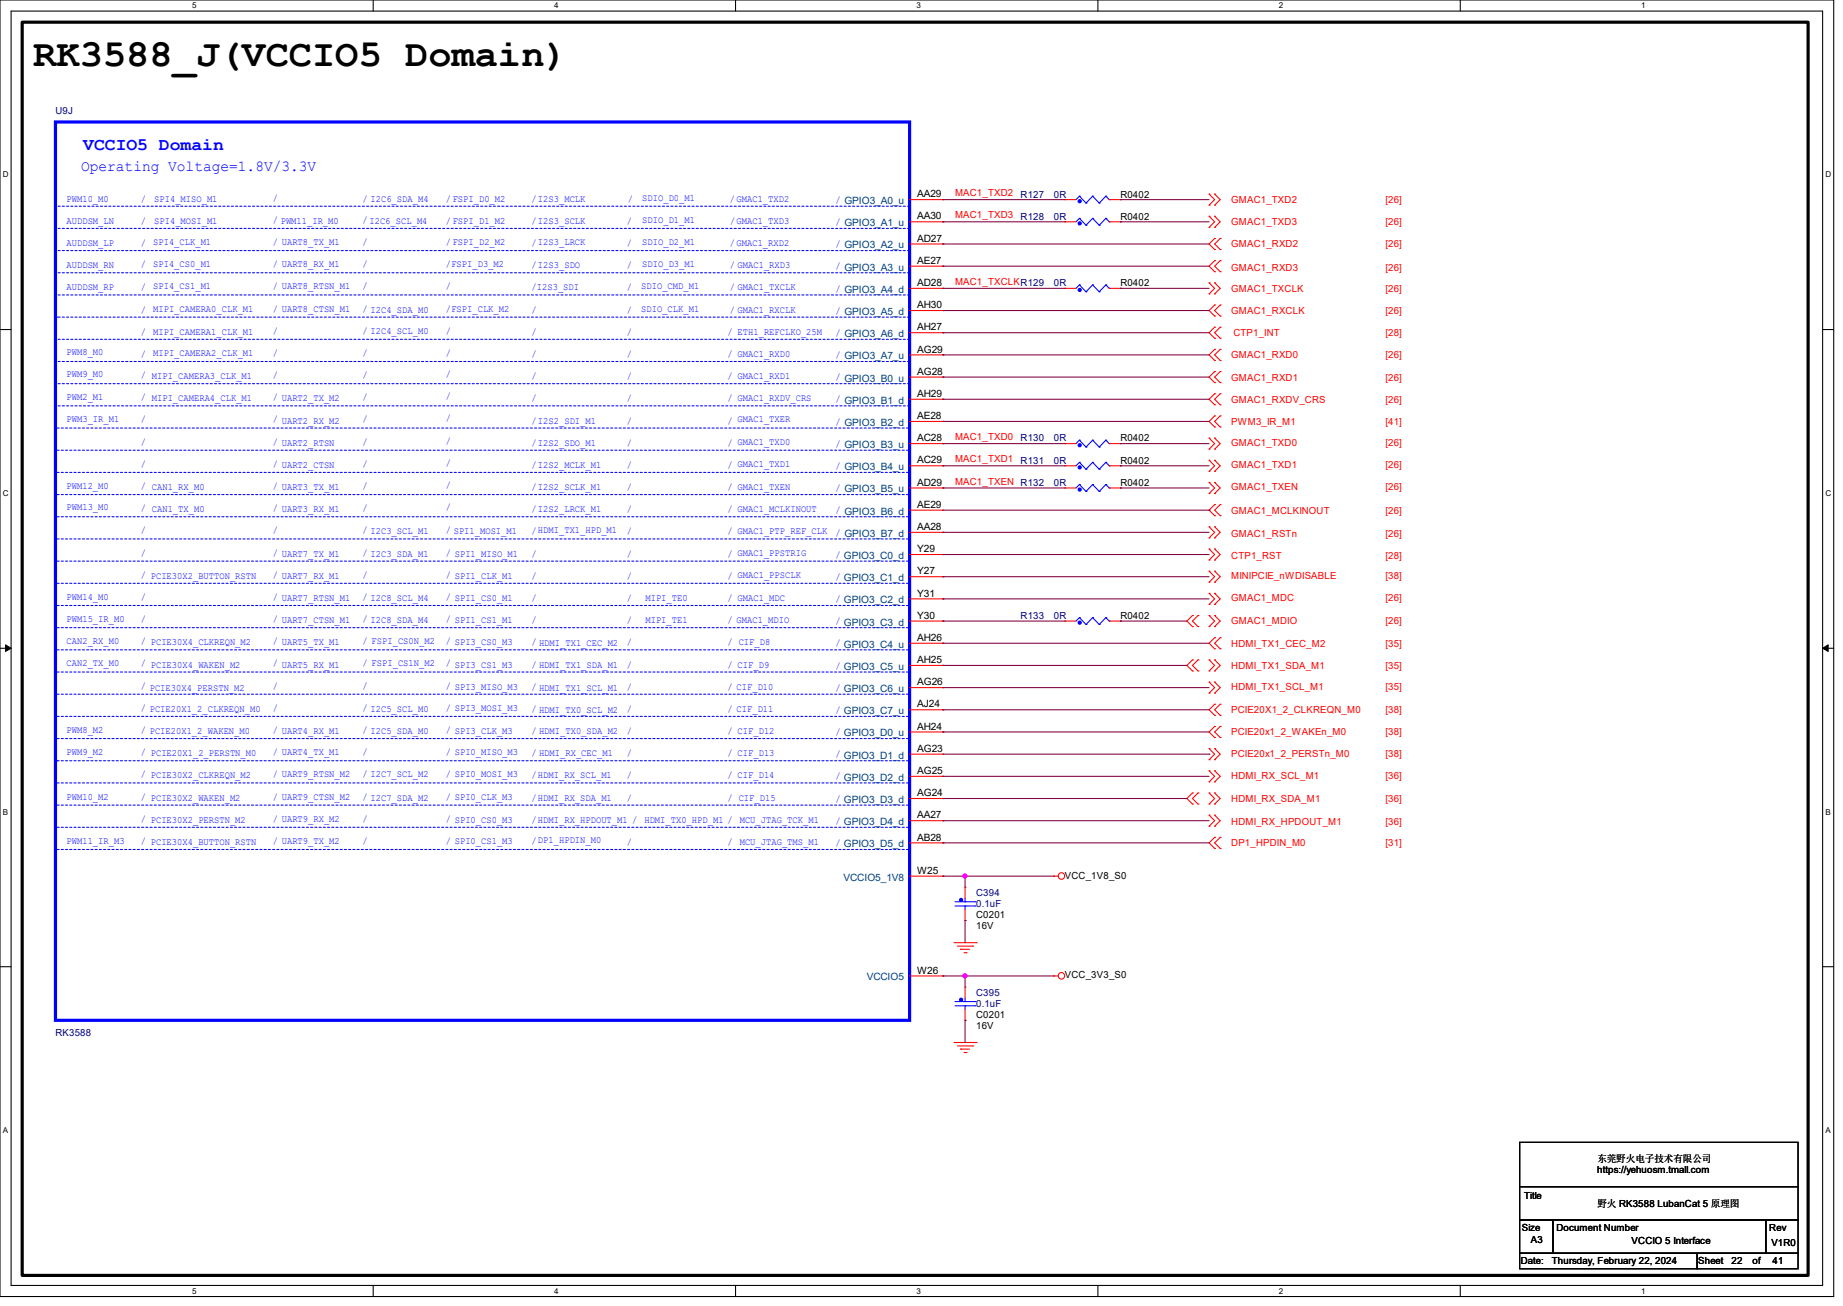
[picture p25: page 22]

东莞野火电子技术有限公司 https://yehuosm.tmall.com

D D

# RK3588_K(VCCIO6 Domain)

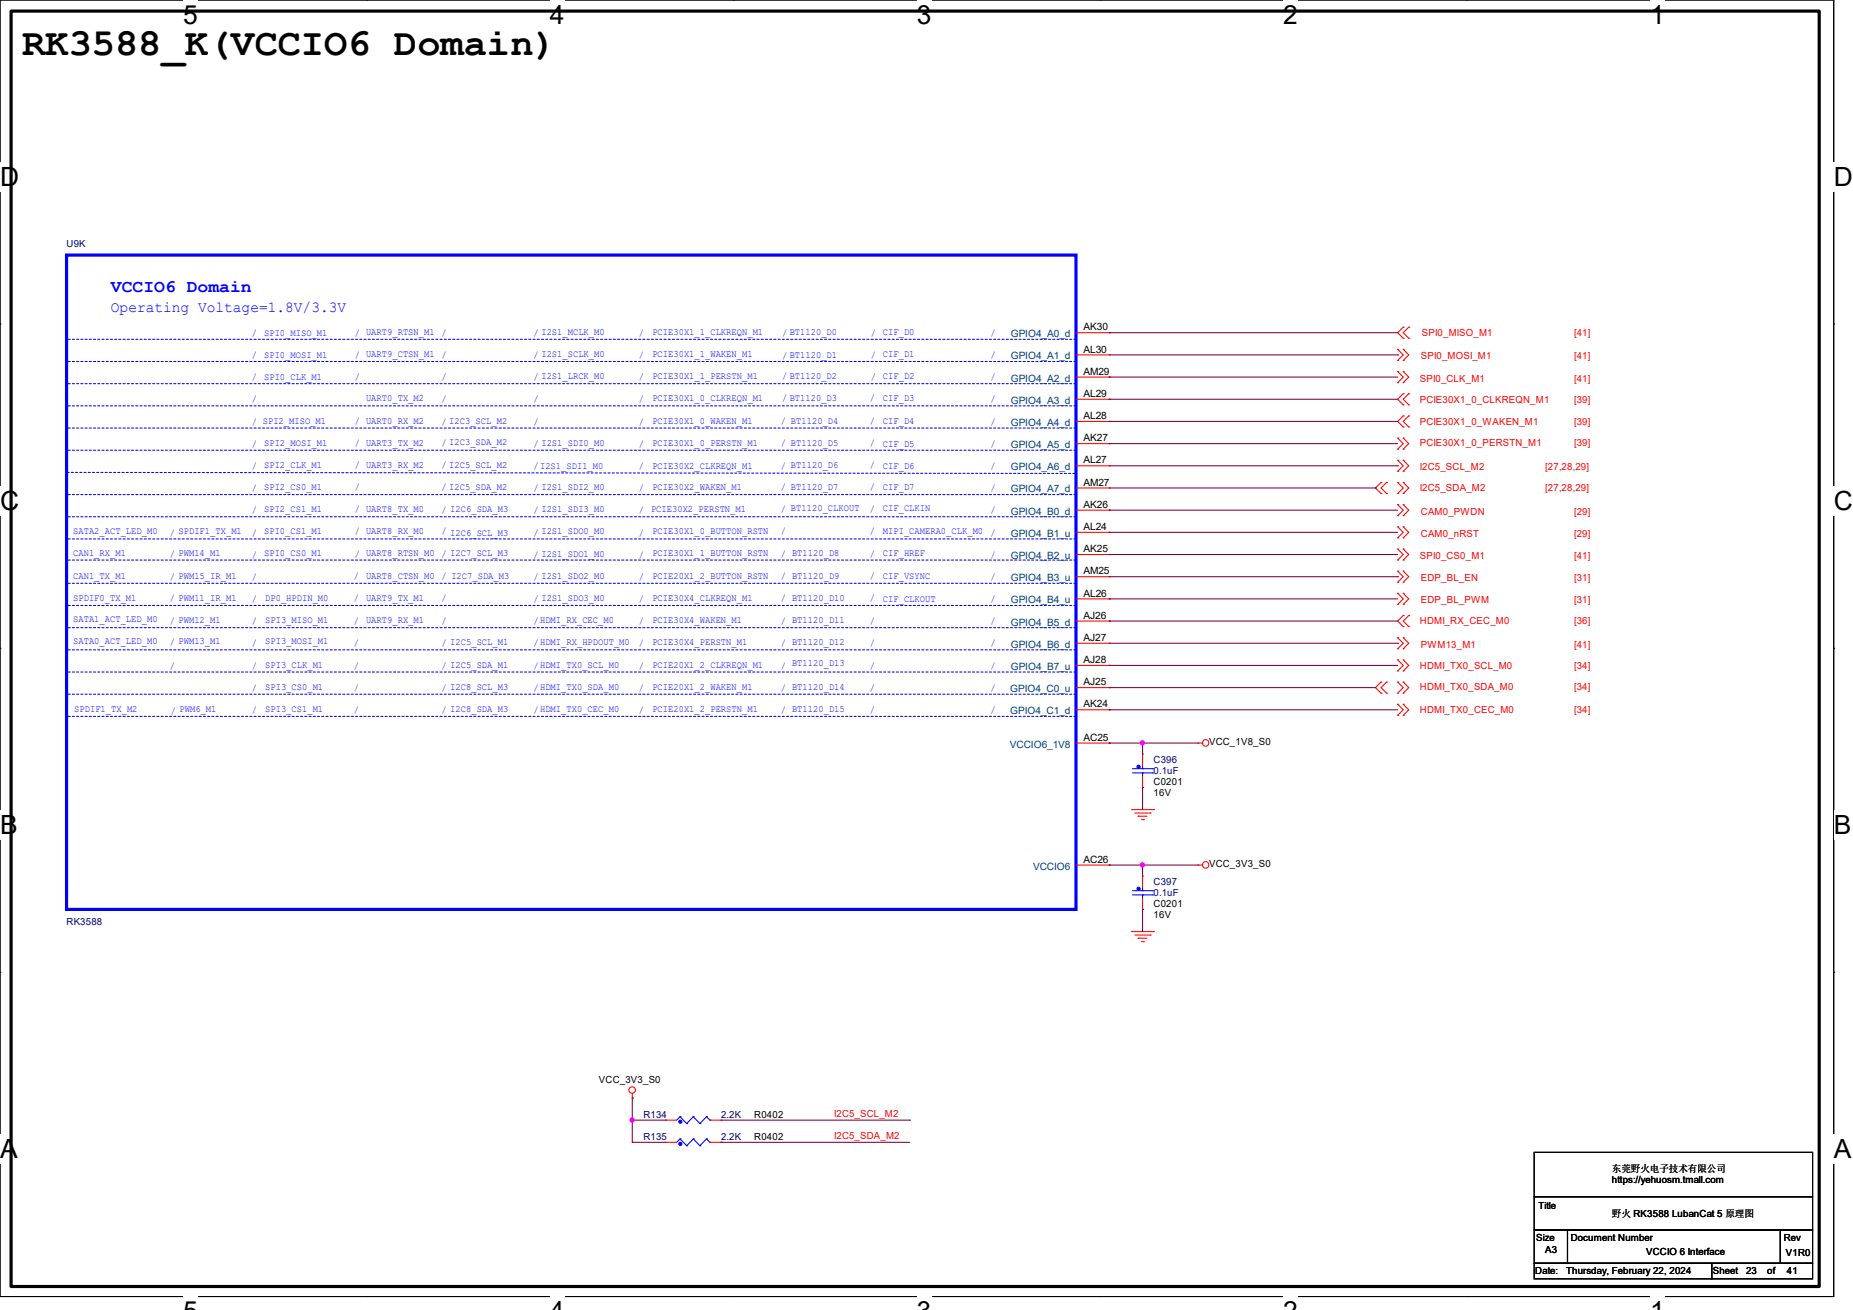
[picture p26: page 23]
VCC_1V8_S0 VCC_3V3_S0 VCC_3V3_S0; PCIE30X1_0_WAKEN_M1; [39] PCIE30X1_0_CLKREQN_M1; [39] PCIE30X1_0_PERSTN_M1; I2C5_SCL_M2; I2C5_SDA_M2; [27,28,29] HDMI_TX0_SDA_M0; [34] HDMI_TX0_SCL_M0; [34] HDMI_TX0_CEC_M0; [34] HDMI_RX_CEC_M0; [36] SPI0_CS0_M1; [41] SPI0_CLK_M1; [41] SPI0_MOSI_M1; [41] SPI0_MISO_M1; [41] CAM0_PWDN; [29] CAM0_nRST; [29] EDP_BL_EN; [31] EDP_BL_PWM; [31] PWM13_M1; Title Size; Document Number; Rev Date:; Sheet; of VCCIO 6 Interface; A3 Thursday, February 22, 2024; 41 Title Size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

东莞野火电子技术有限公司 https://yehuosm.tmall.com

# EMMC FLASH

# 10K R138 R0402 R139

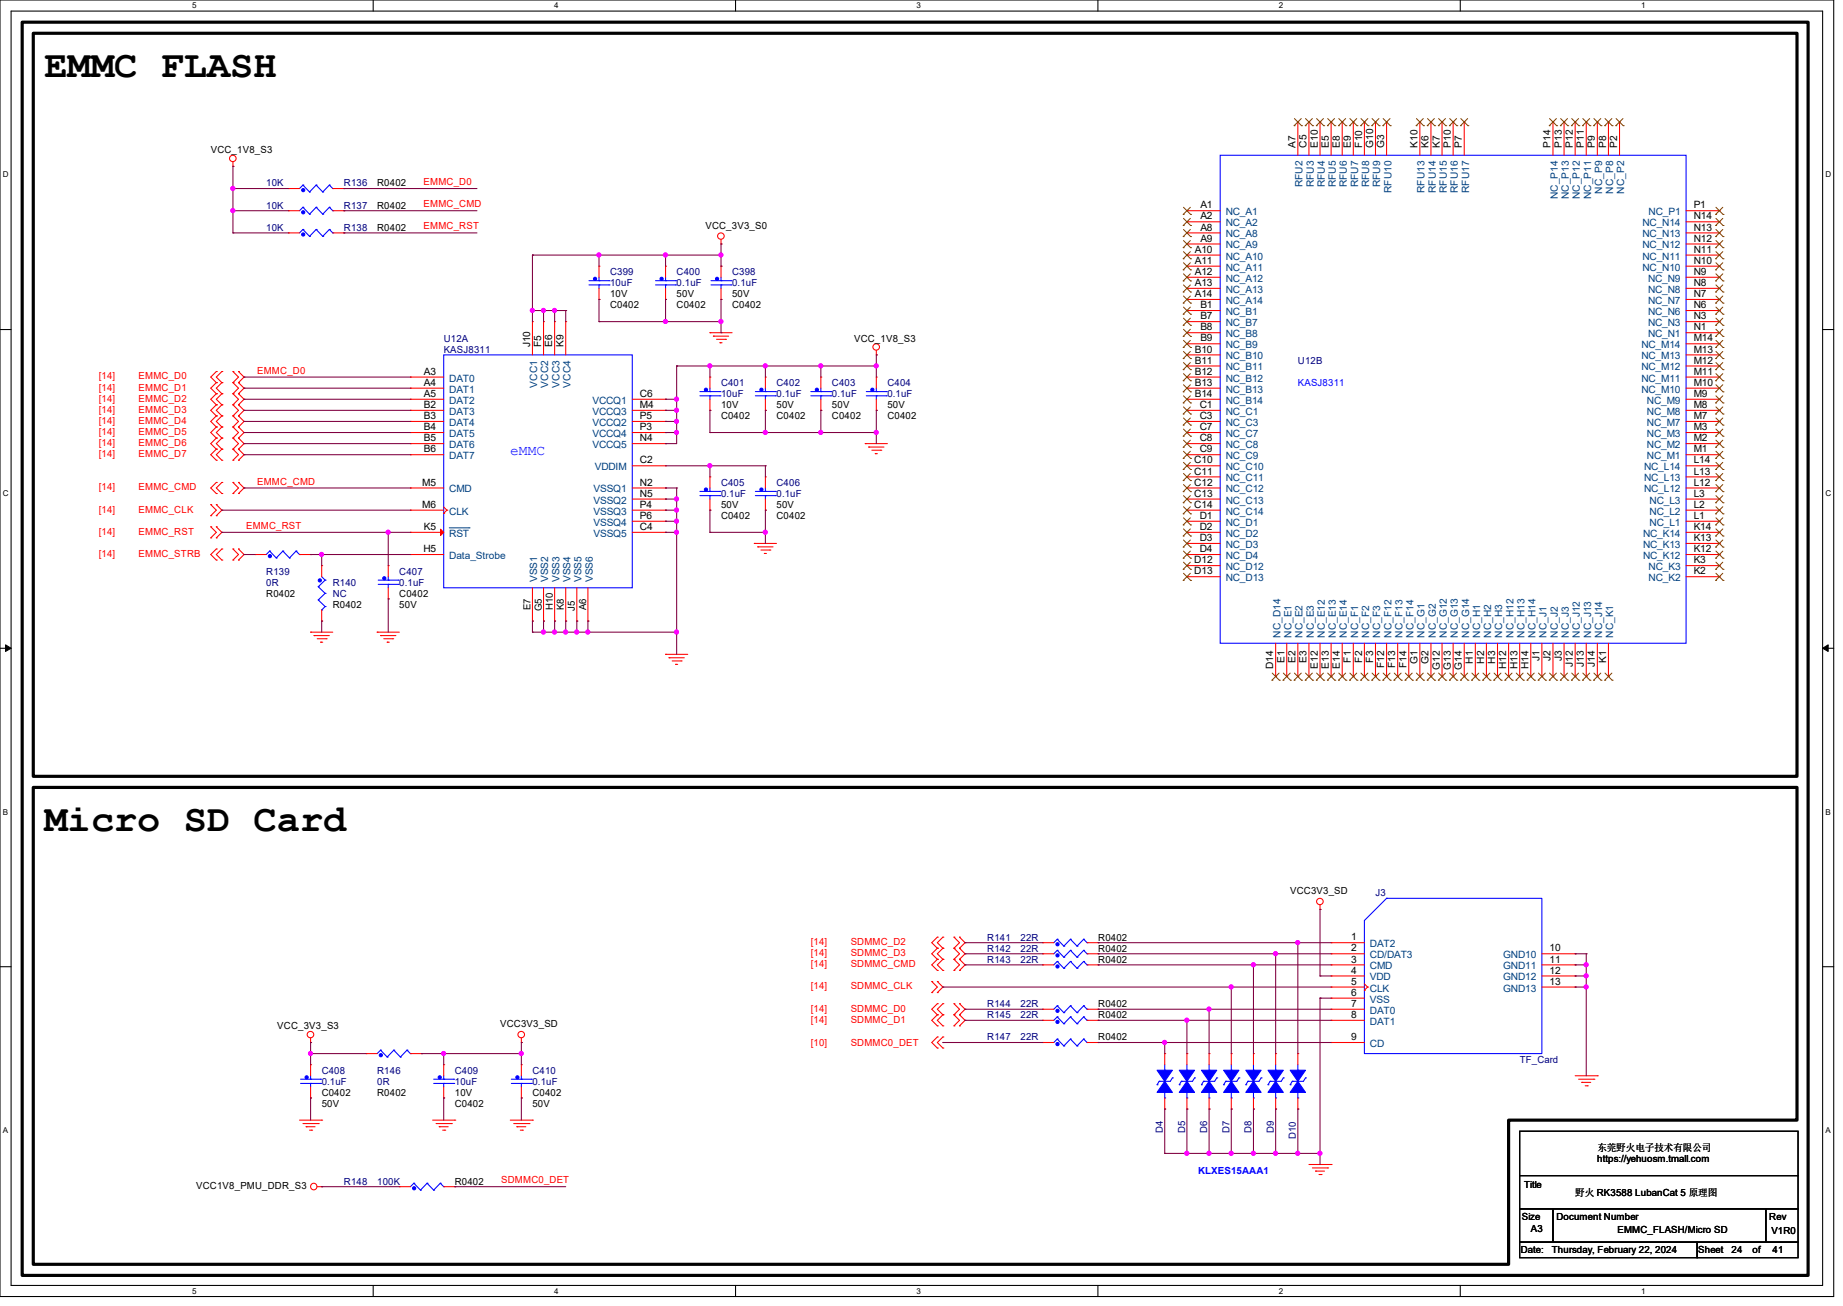
[picture p27: page 24]

东莞野火电子技术有限公司 https://yehuosm.tmall.com

# IO Use an external power supply：1.8V

# ETH_1

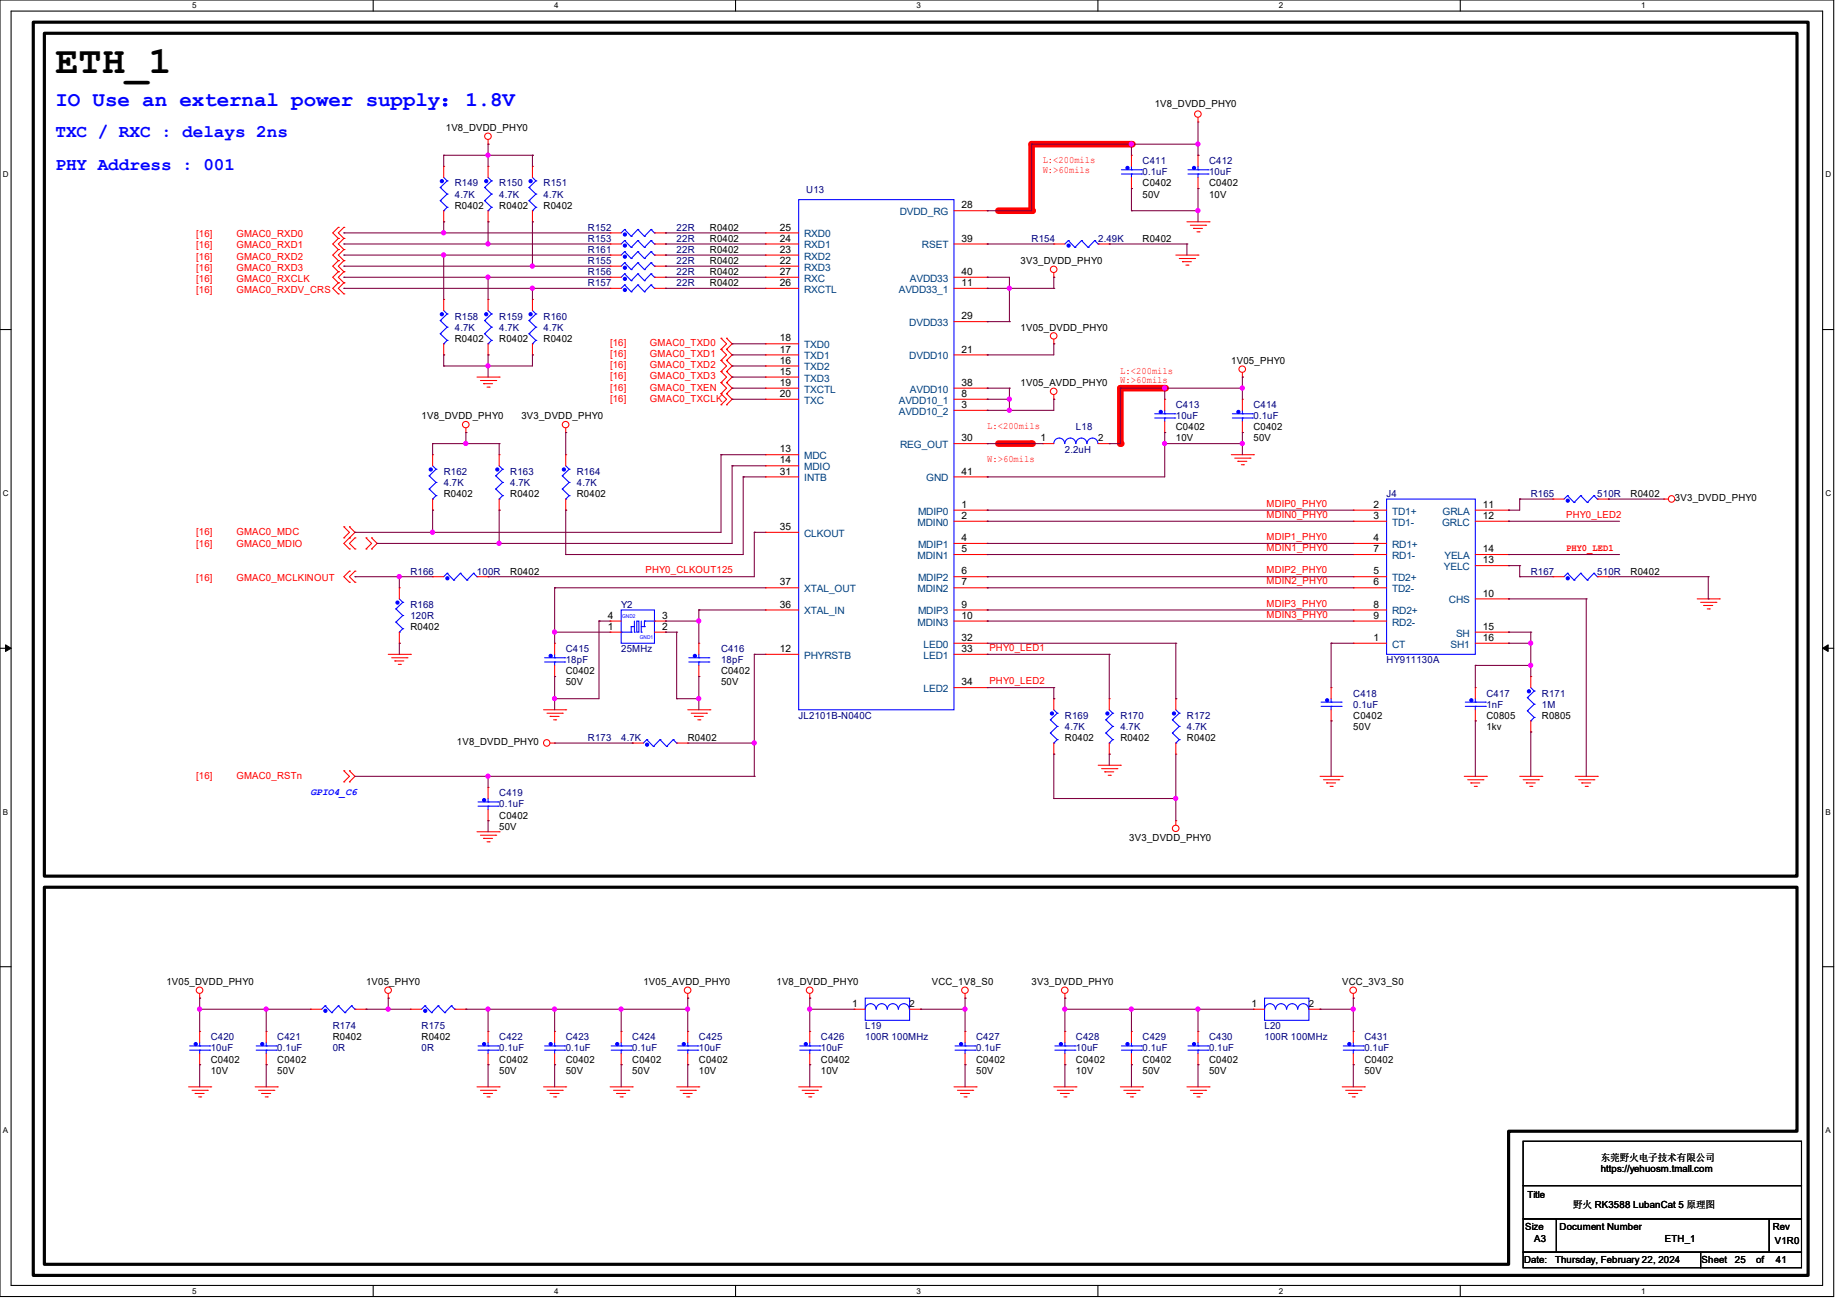
[picture p28: page 25]

JL2101B-N040C MDC 13 MDIO 14 TXD0 18 TXD1 17 TXD2 16 TXD3 15 TXCTL 19 TXC 20 RXD0 25 RXD1 24 RXD2 23 RXD3 22 RXC 27 CLKOUT 35
RSET 39 GND 41 MDIP0 1 MDIN0 2 MDIP1 4 MDIN1 5 MDIP2 6 MDIN2 7 MDIP3 9 MDIN3 10

东莞野火电子技术有限公司 https://yehuosm.tmall.com

# IO Use an external power supply：3.3v

# ETH_0

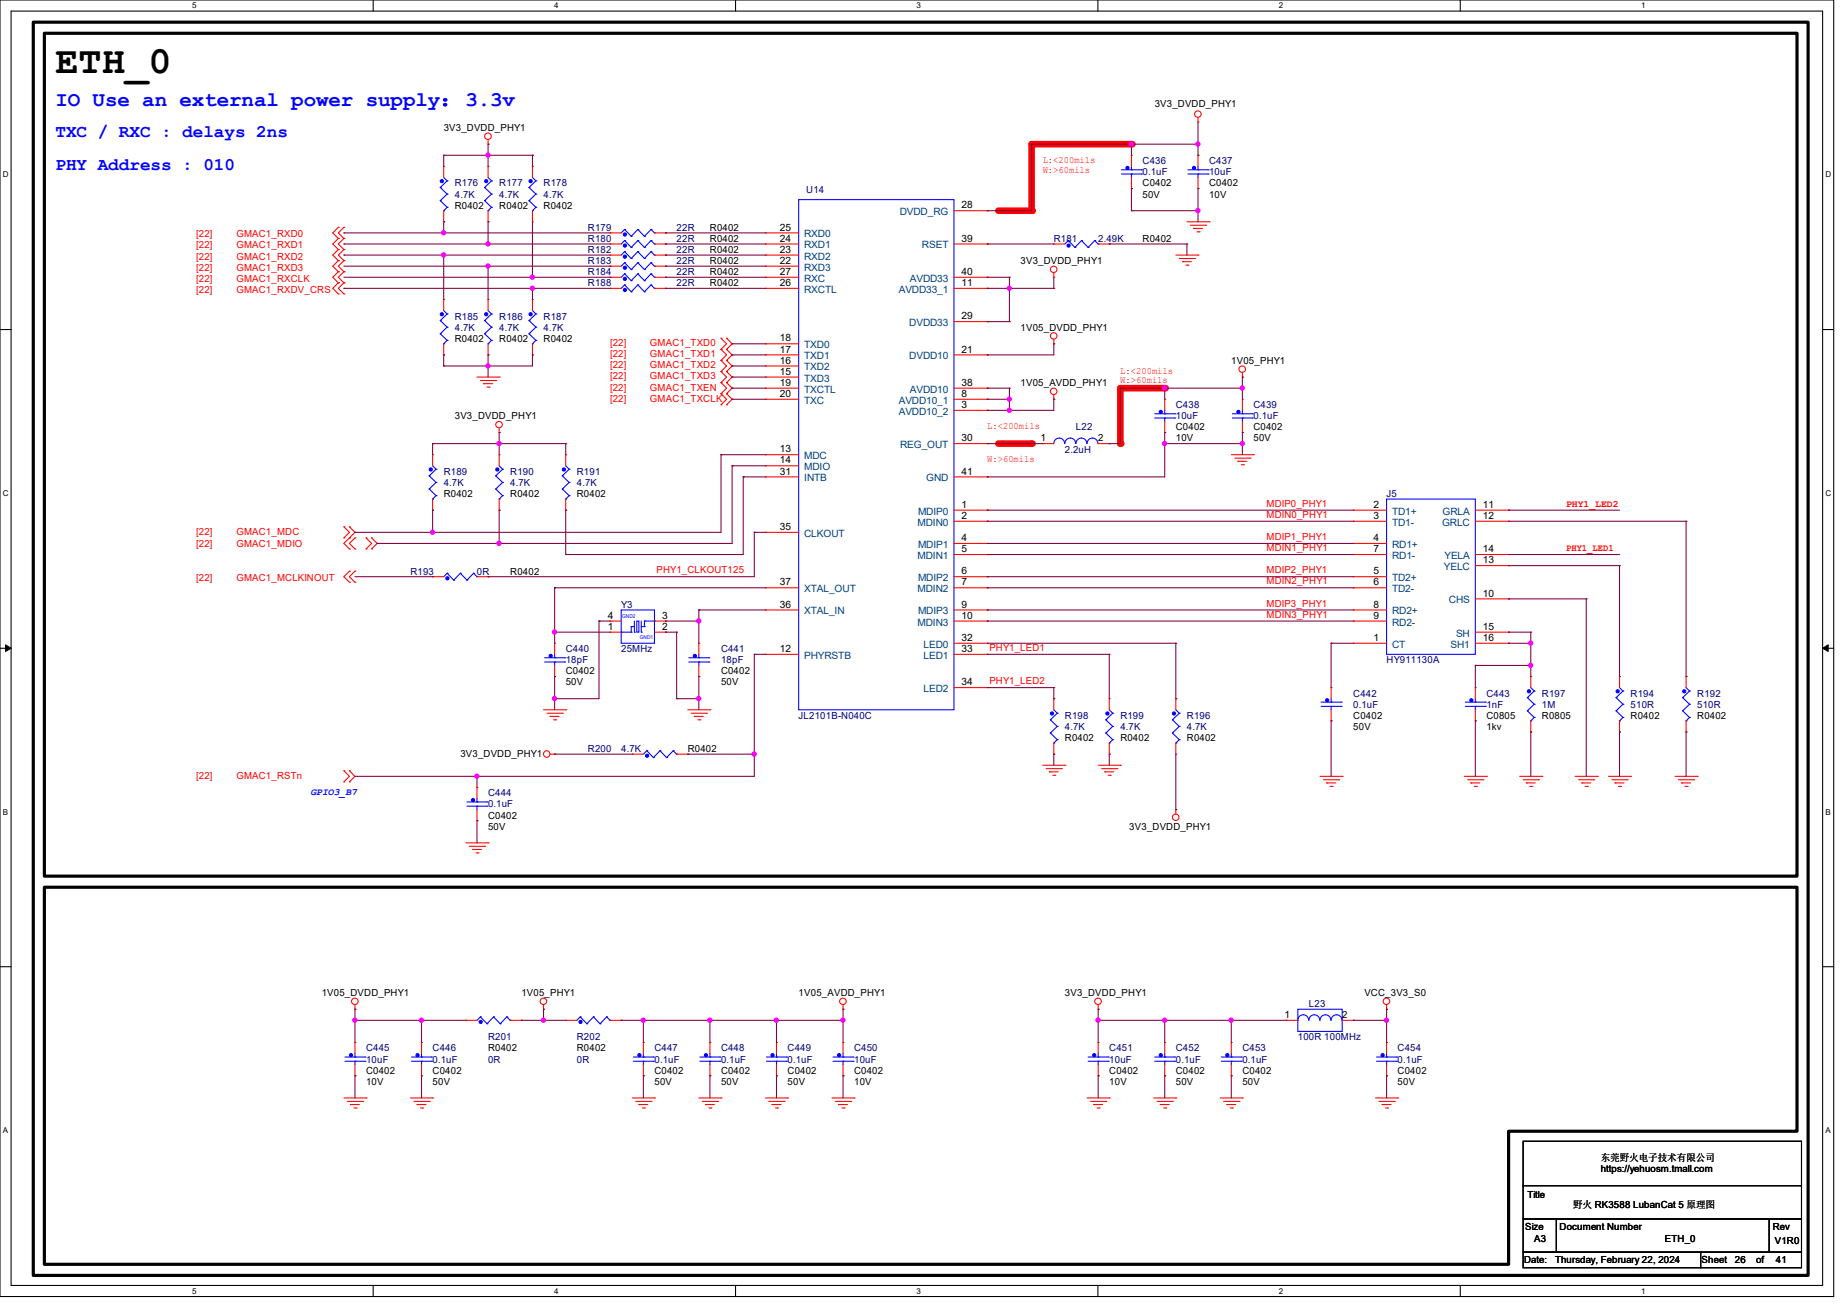
[picture p29: page 26]
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

东莞野火电子技术有限公司 https://yehuosm.tmall.com

D D

I2C Level Translation | I/O Expand A

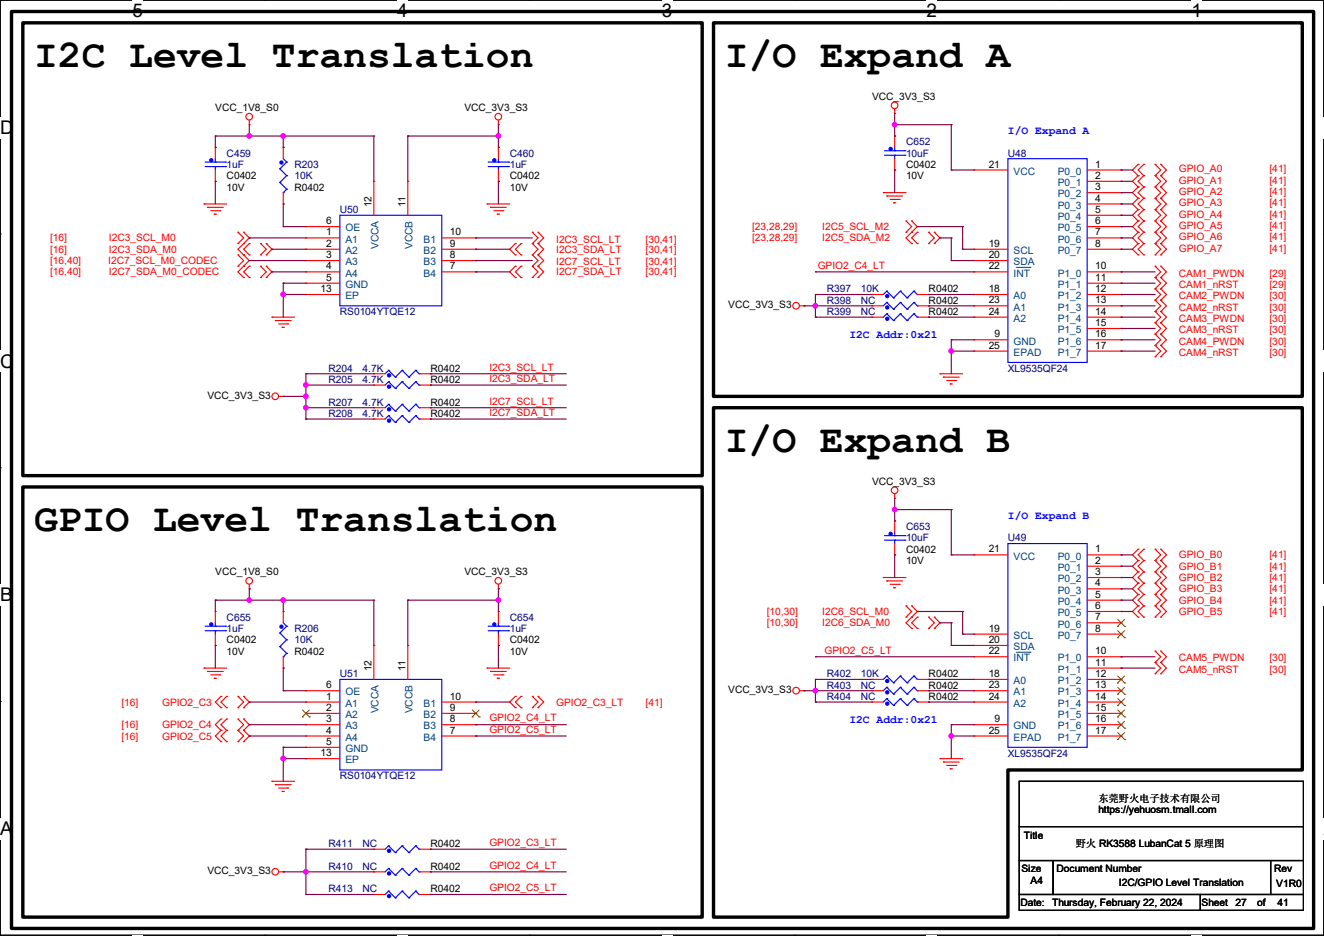
[picture p30: page 27]

I/O Expand B GPIO Level Translation

东莞野火电子技术有限公司
https://yehuosm.tmall.com

MIPI_DSI_TX0 PORT | MIPI_DSI_TX1 PORT

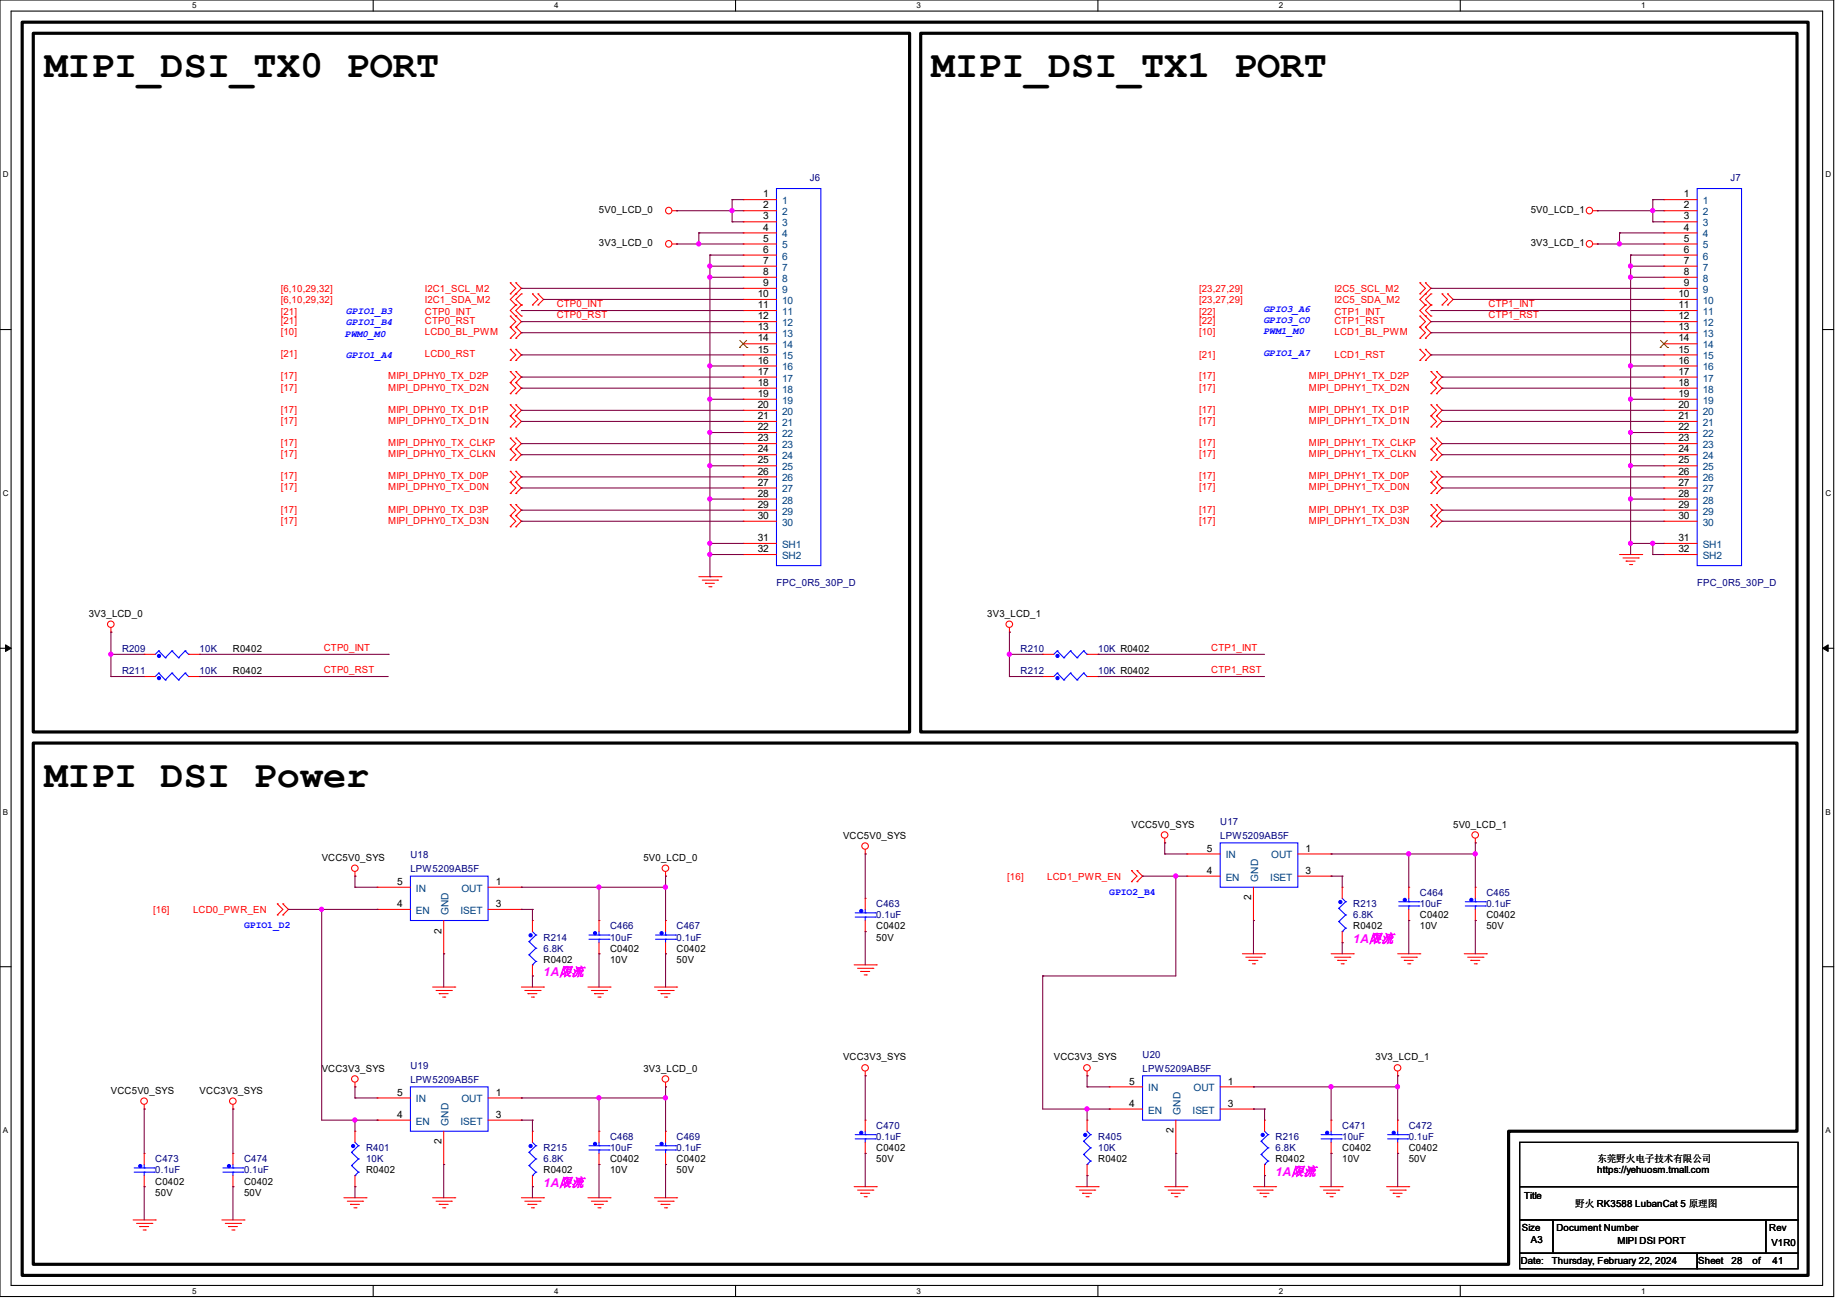
[picture p31: page 28]

东莞野火电子技术有限公司 https://yehuosm.tmall.com

MIPI CSI 0 PORT | MIPI CSI 1 PORT

## 5V0_CAM1

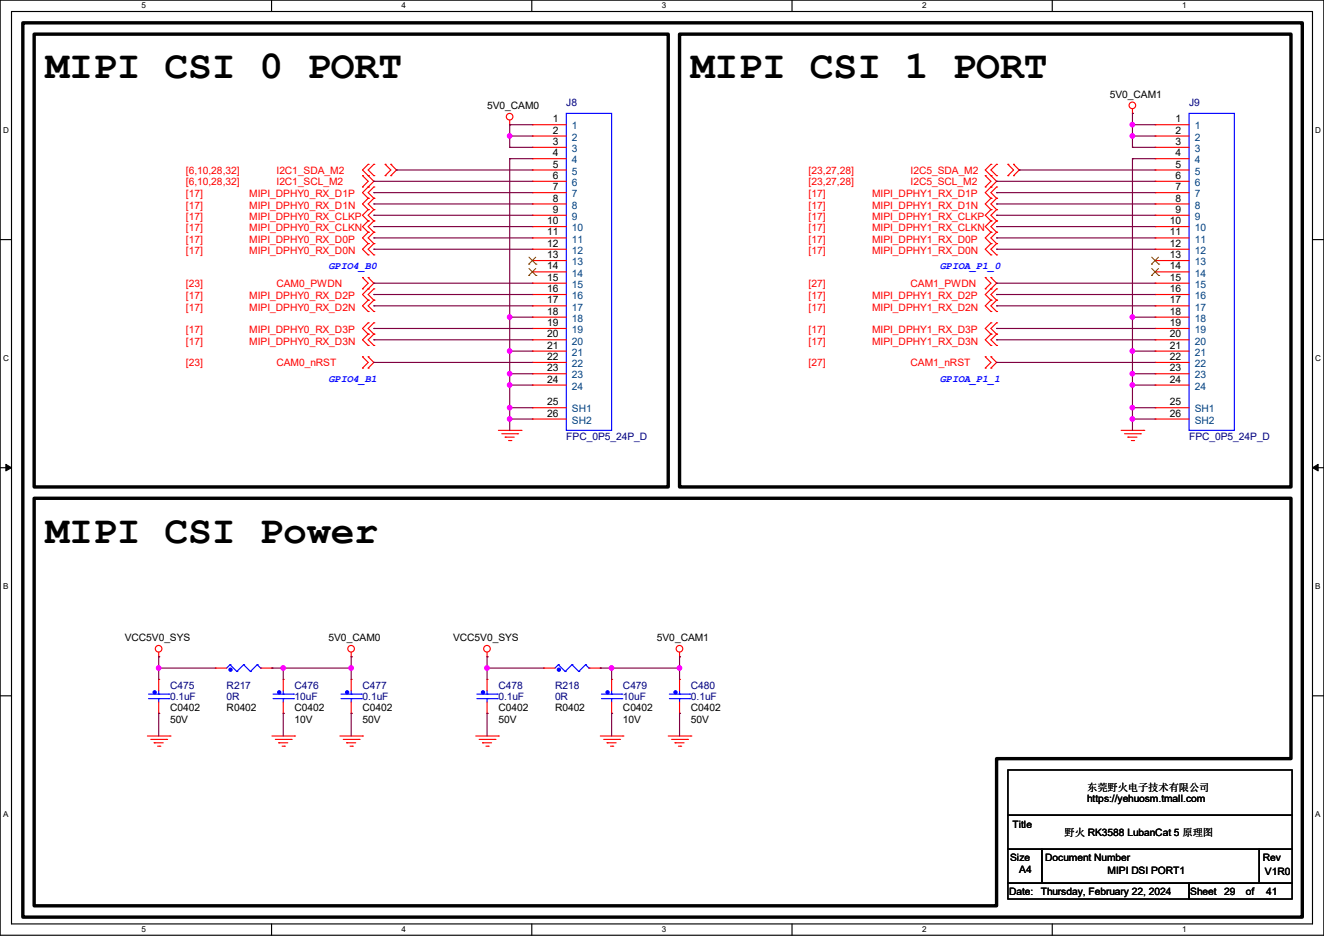
[picture p32: page 29]

东莞野火电子技术有限公司
https://yehuosm.tmall.com

D D

MIPI_CSI2_PORT | MIPI_CSI3_PORT

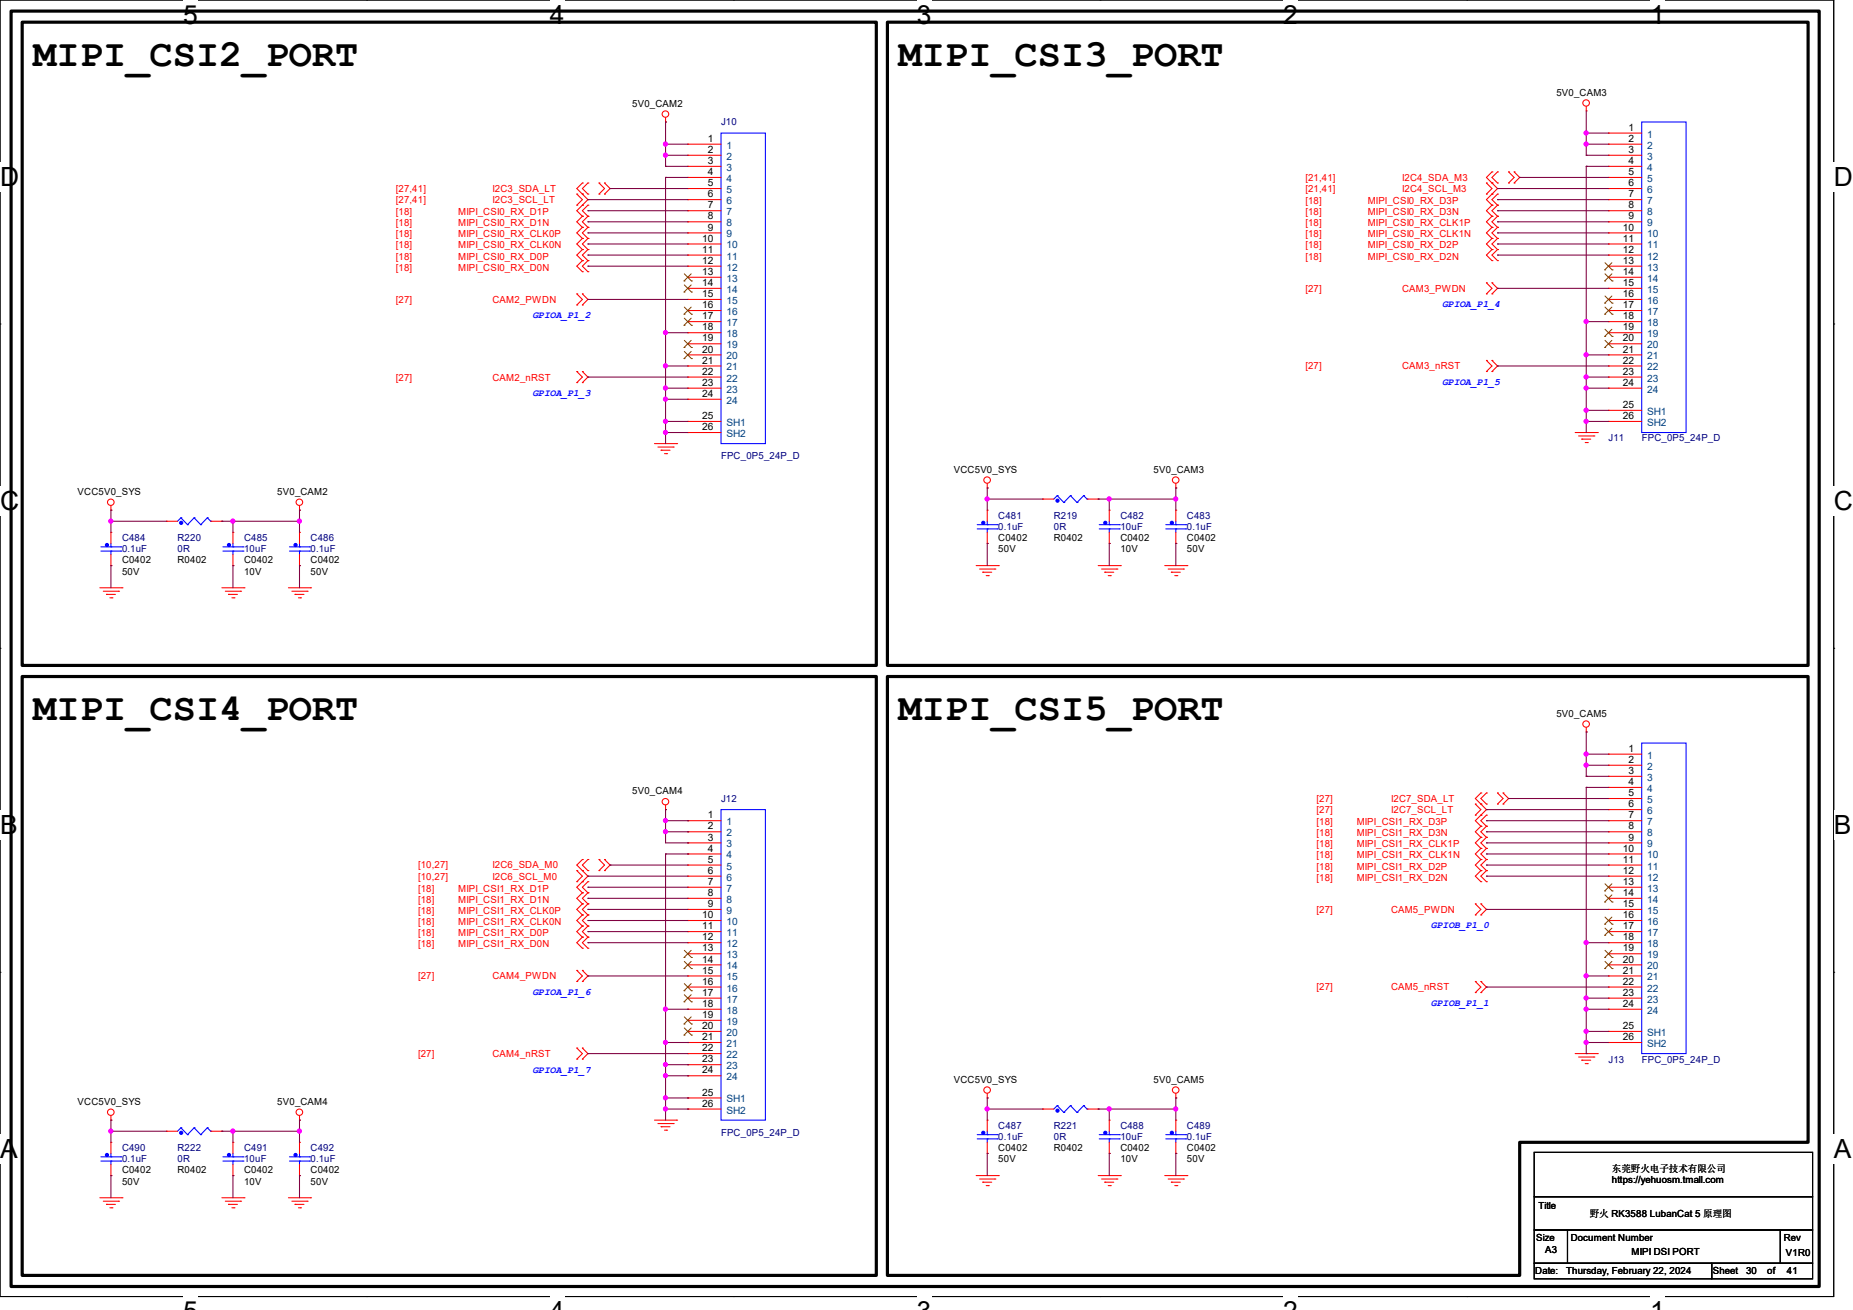
[picture p33: page 30]

东莞野火电子技术有限公司 https://yehuosm.tmall.com

# eDP1.3 PORT

## 3V3_EDP

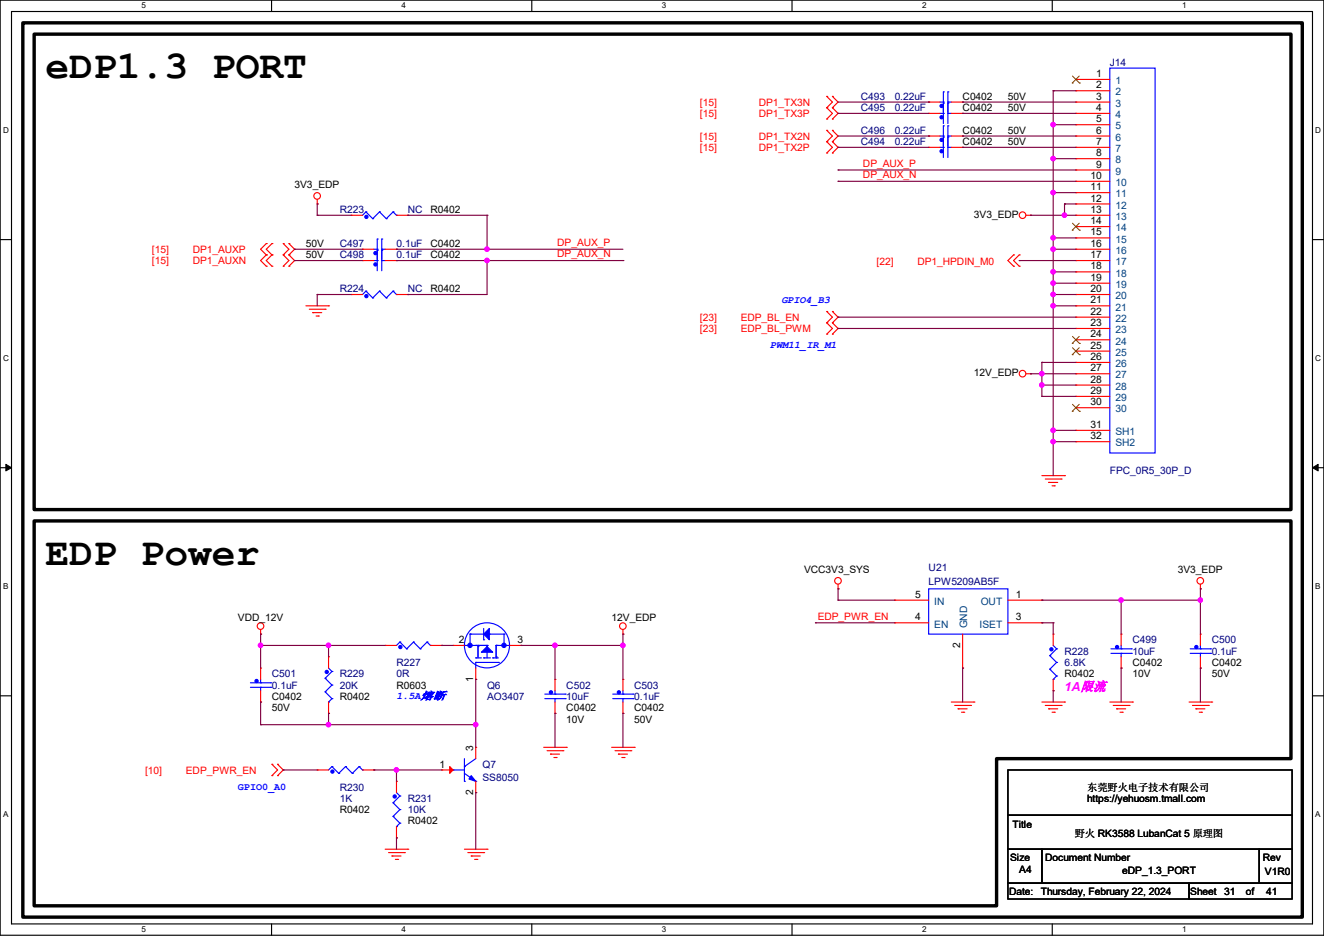
[picture p34: page 31]

东莞野火电子技术有限公司
https://yehuosm.tmall.com

D D

# ESD

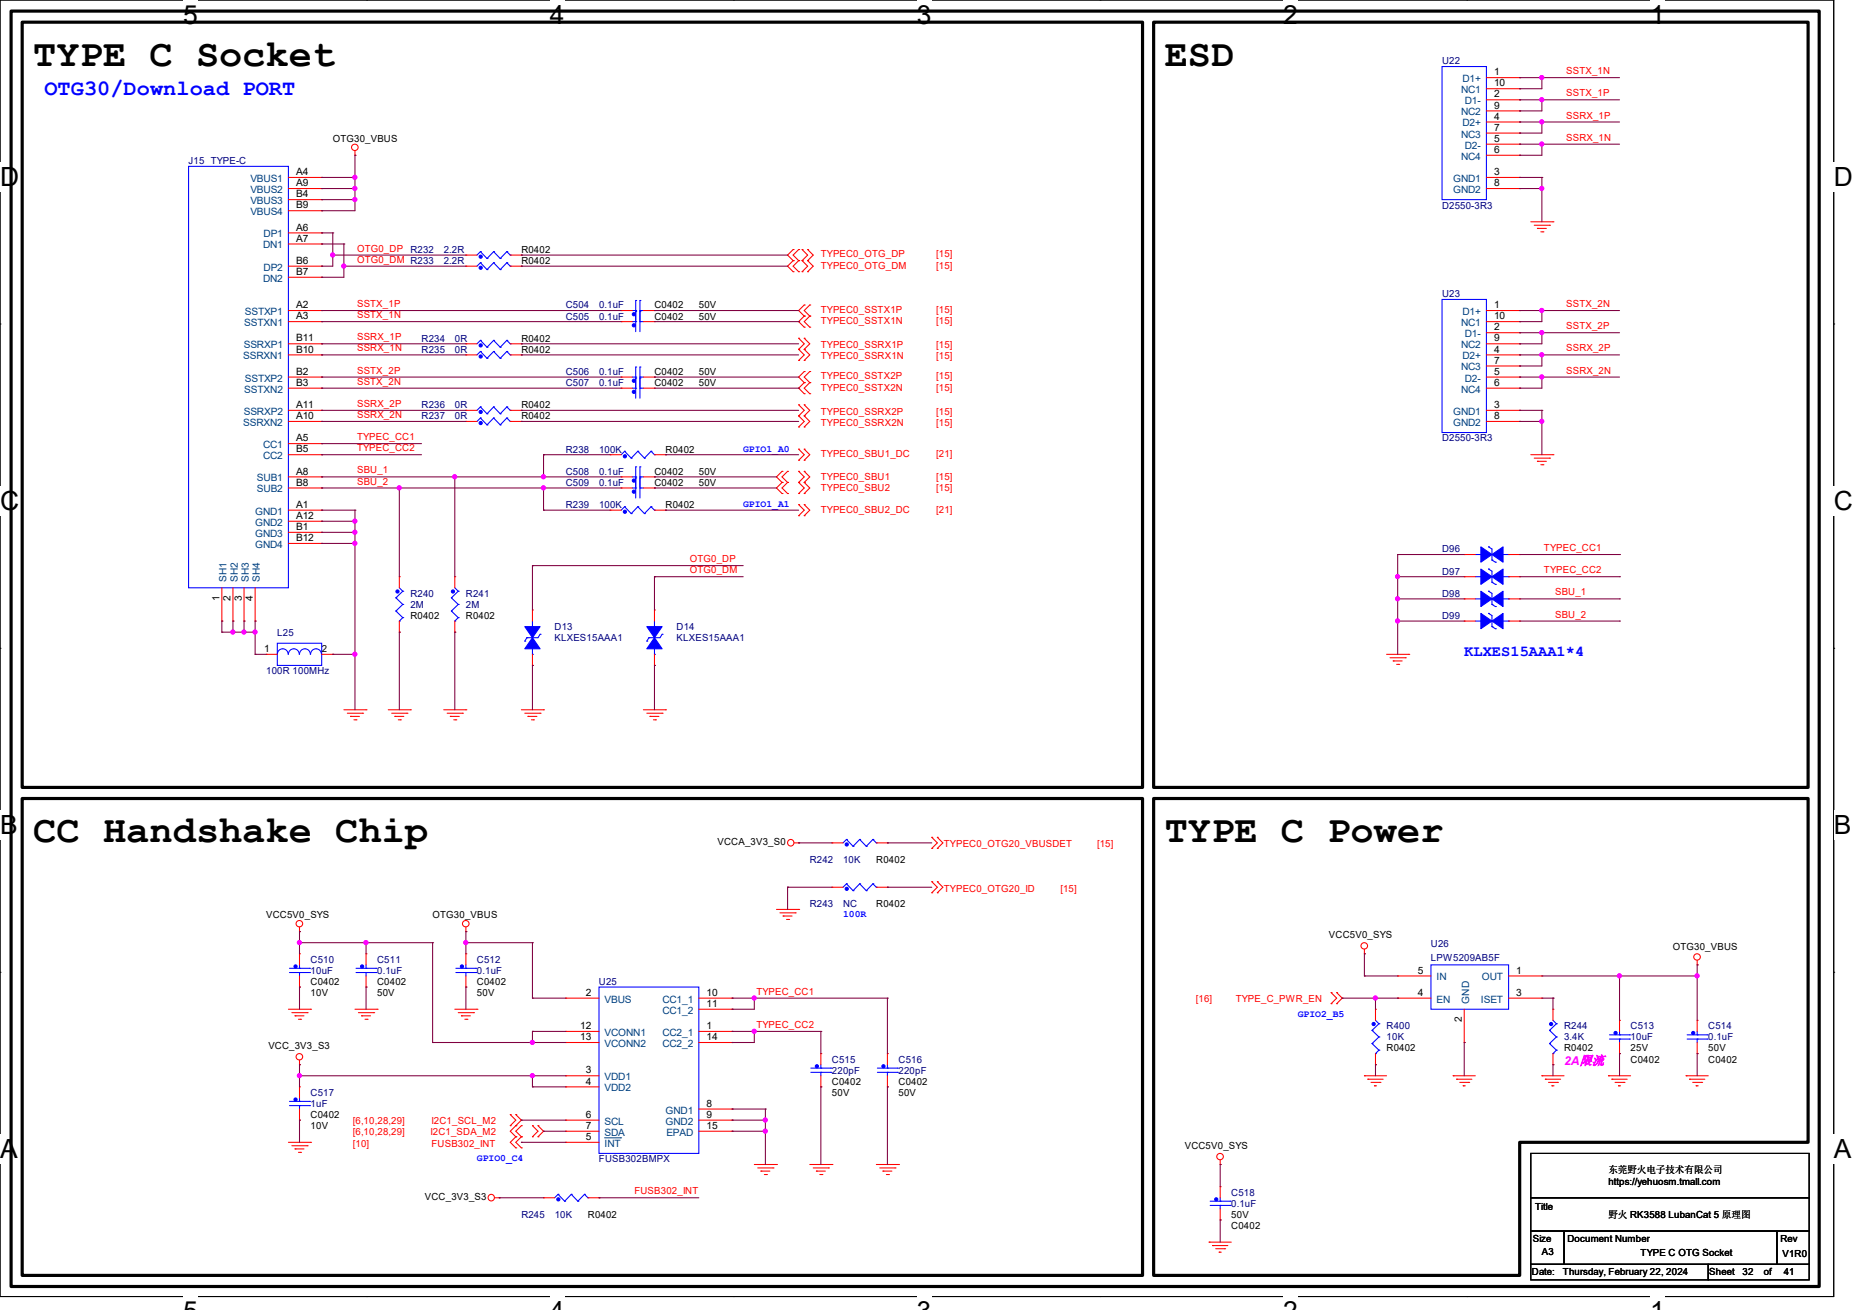
[picture p35: page 32]

东莞野火电子技术有限公司 https://yehuosm.tmall.com

USB 3.0 HOST x2 | USB POWER

# USB 2.0 HOST x2

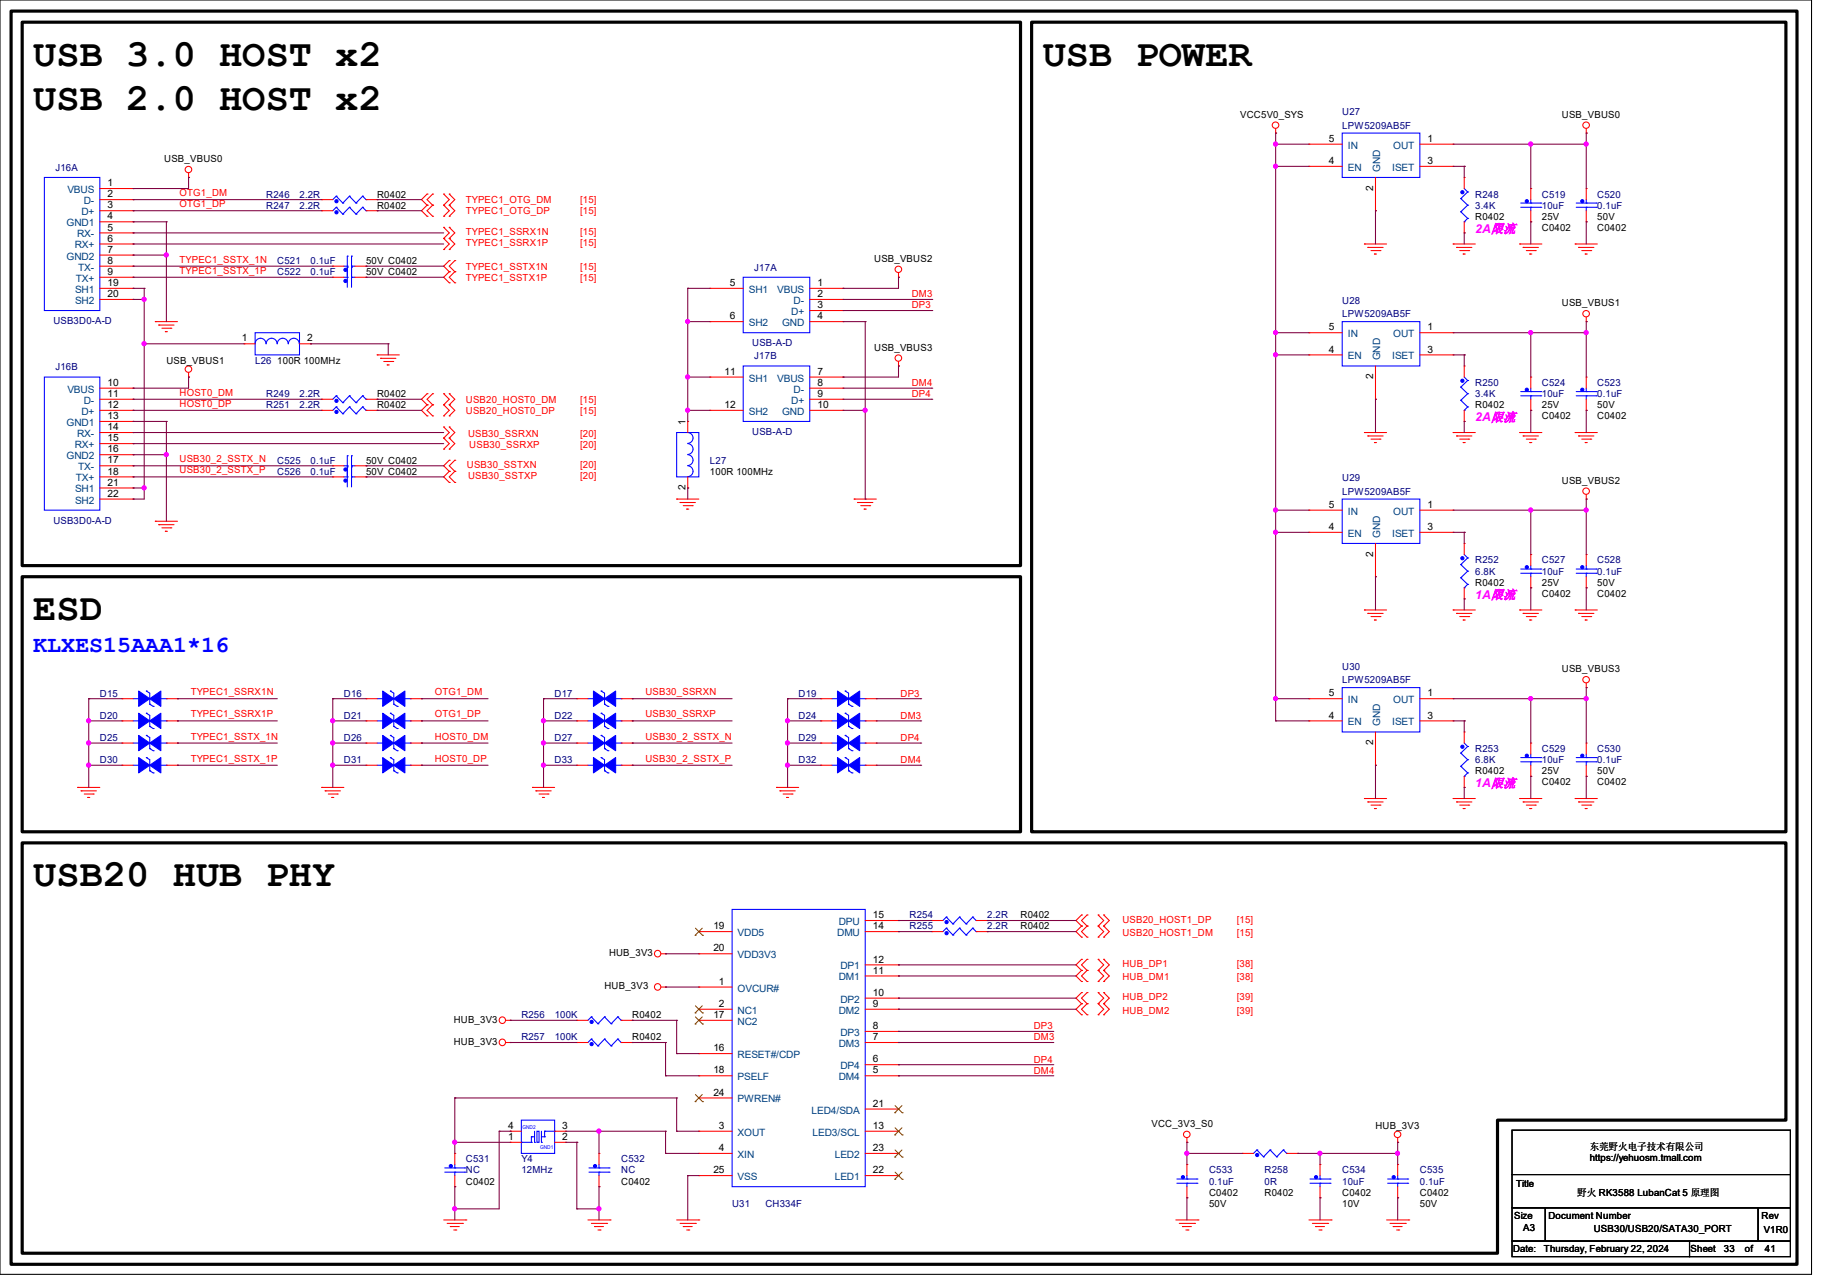
[picture p36: page 33]

LED3/SCL 13 DMU 14 DPU 15 RESET#/CDP 16 NC2 17 PSELF 18 VDD5 19 VDD3V3 20

东莞野火电子技术有限公司 https://yehuosm.tmall.com

# HDMI2.1 PORT

# J18A QJ11191-DFB2-4H

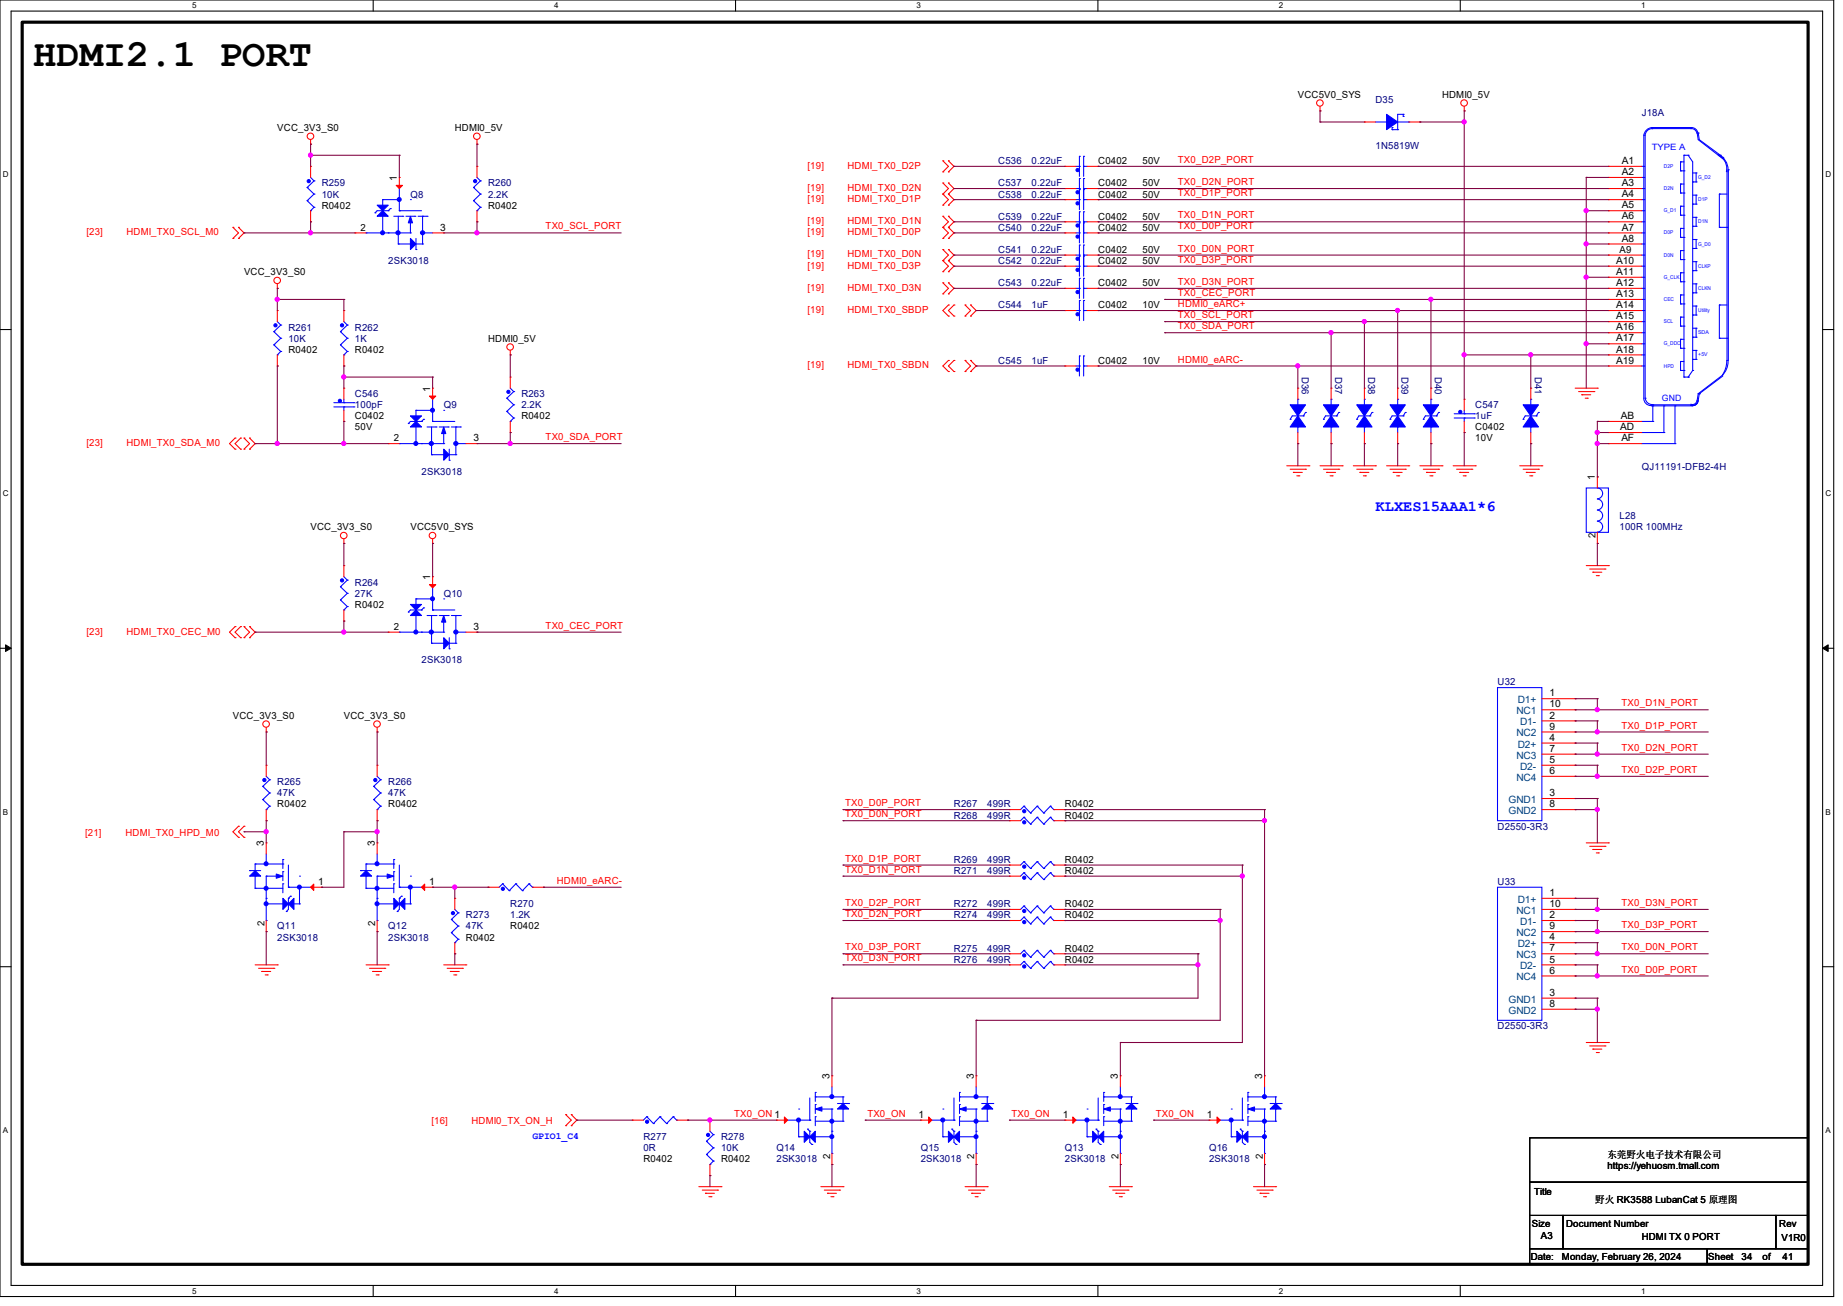
[picture p37: page 34]

TX0_D0N_PORT | A1A2A3A4A5A6A7A8 A9 A10 A11 A12 A13 A14 A15 A16 A17 A18 A19 AB

TX0_D1P_PORT

TX0_D1N_PORT
TX0_D0P_PORT

东莞野火电子技术有限公司 https://yehuosm.tmall.com

# HDMI2.1 PORT

D1N G_D1 D2P D0P G_CLK | G_D2 D1P D2N | G_D0 D0N

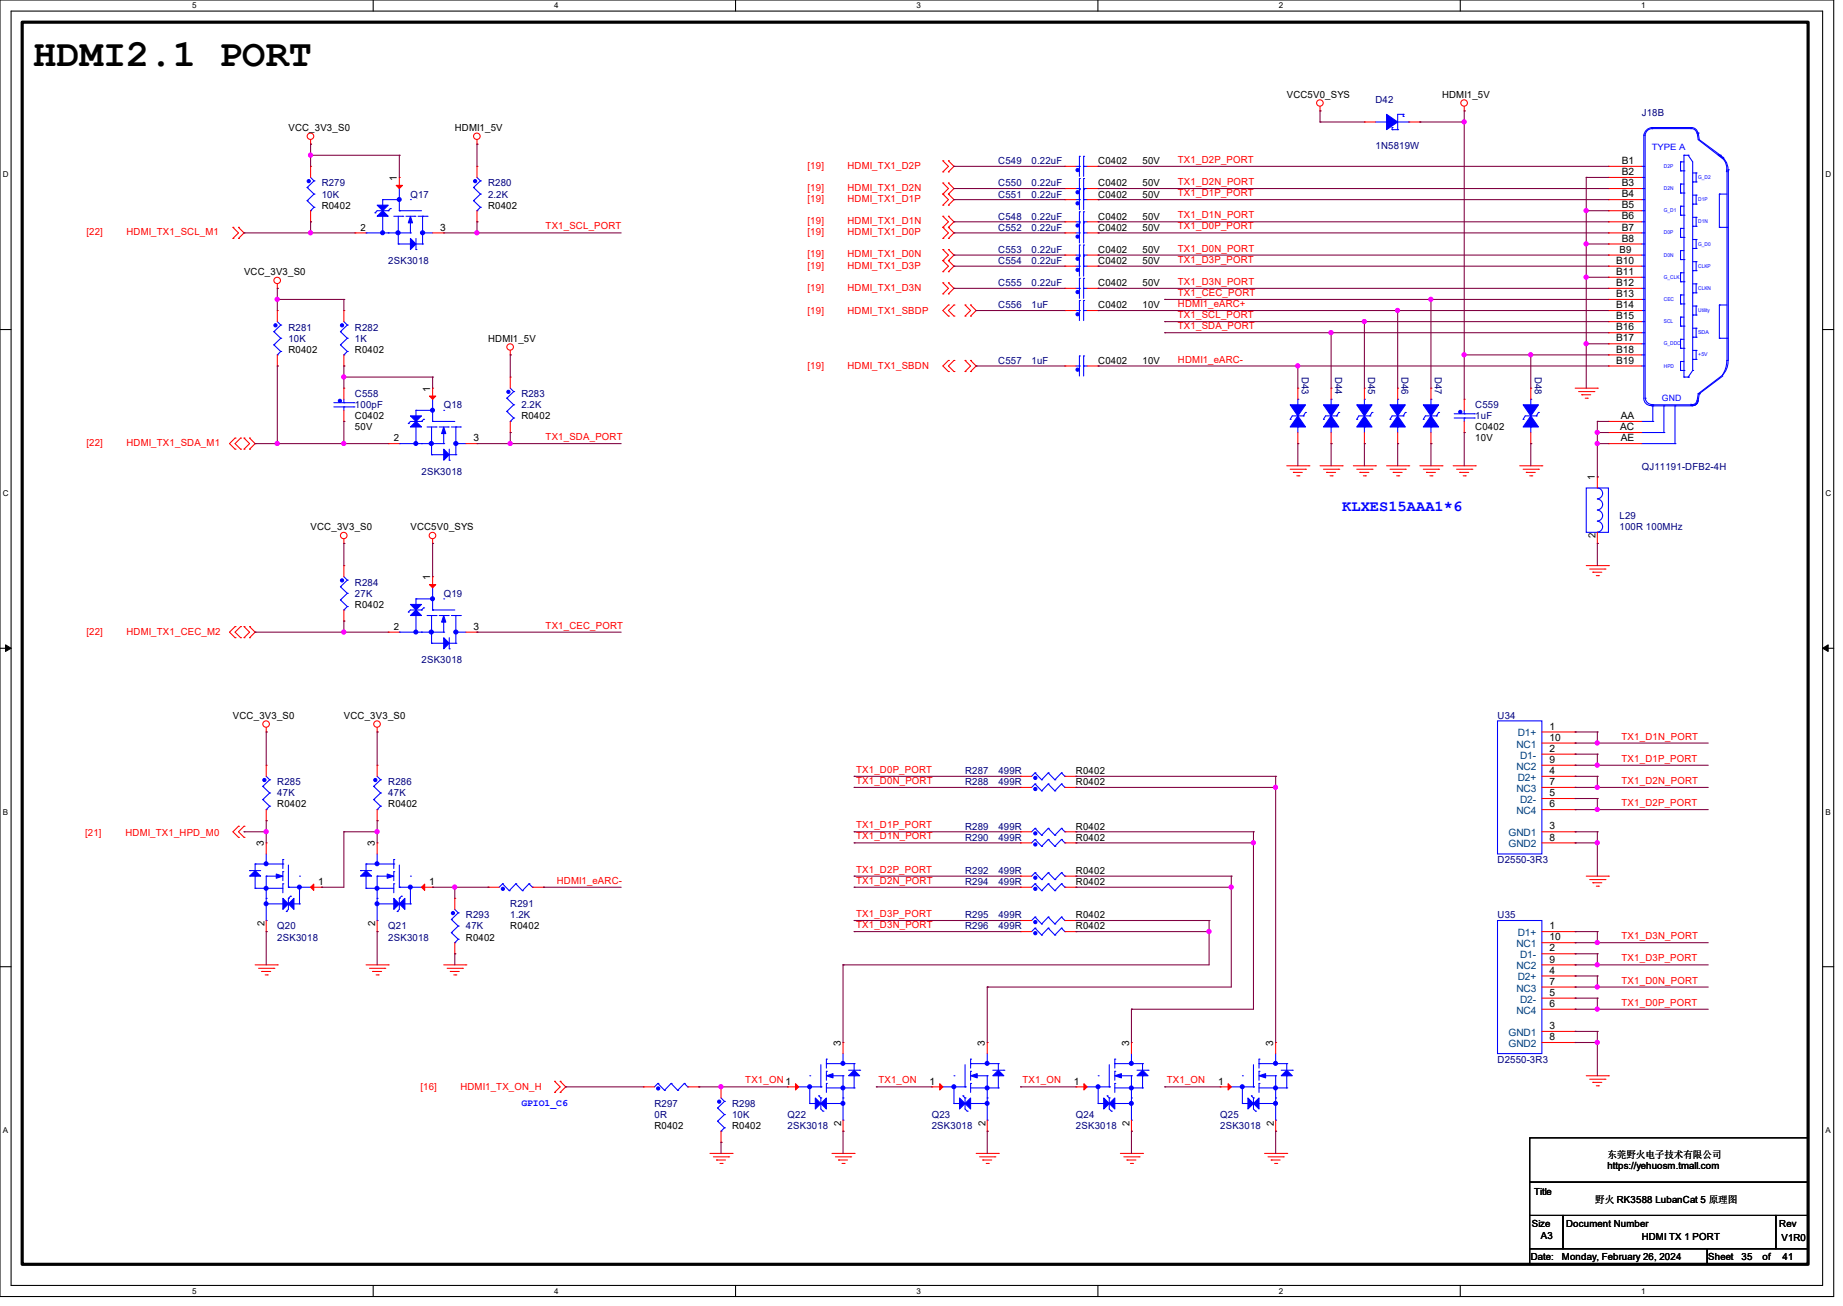
[picture p38: page 35]

TX1_D0N_PORT | B1B2B3B4B5B6B7B8 B9 B10 B11 B12 B13 B14 B15 B16 B17 B18 B19 AA

TX1_D1P_PORT

TX1_D1N_PORT
TX1_D0P_PORT

TX1_D3P_PORT

TX1_D3N_PORT

东莞野火电子技术有限公司 https://yehuosm.tmall.com

# HDMI2.0 RX PORT

D1N G_D1 D2P D0P G_CLK | G_D2 D1P D2N | G_D0 D0N

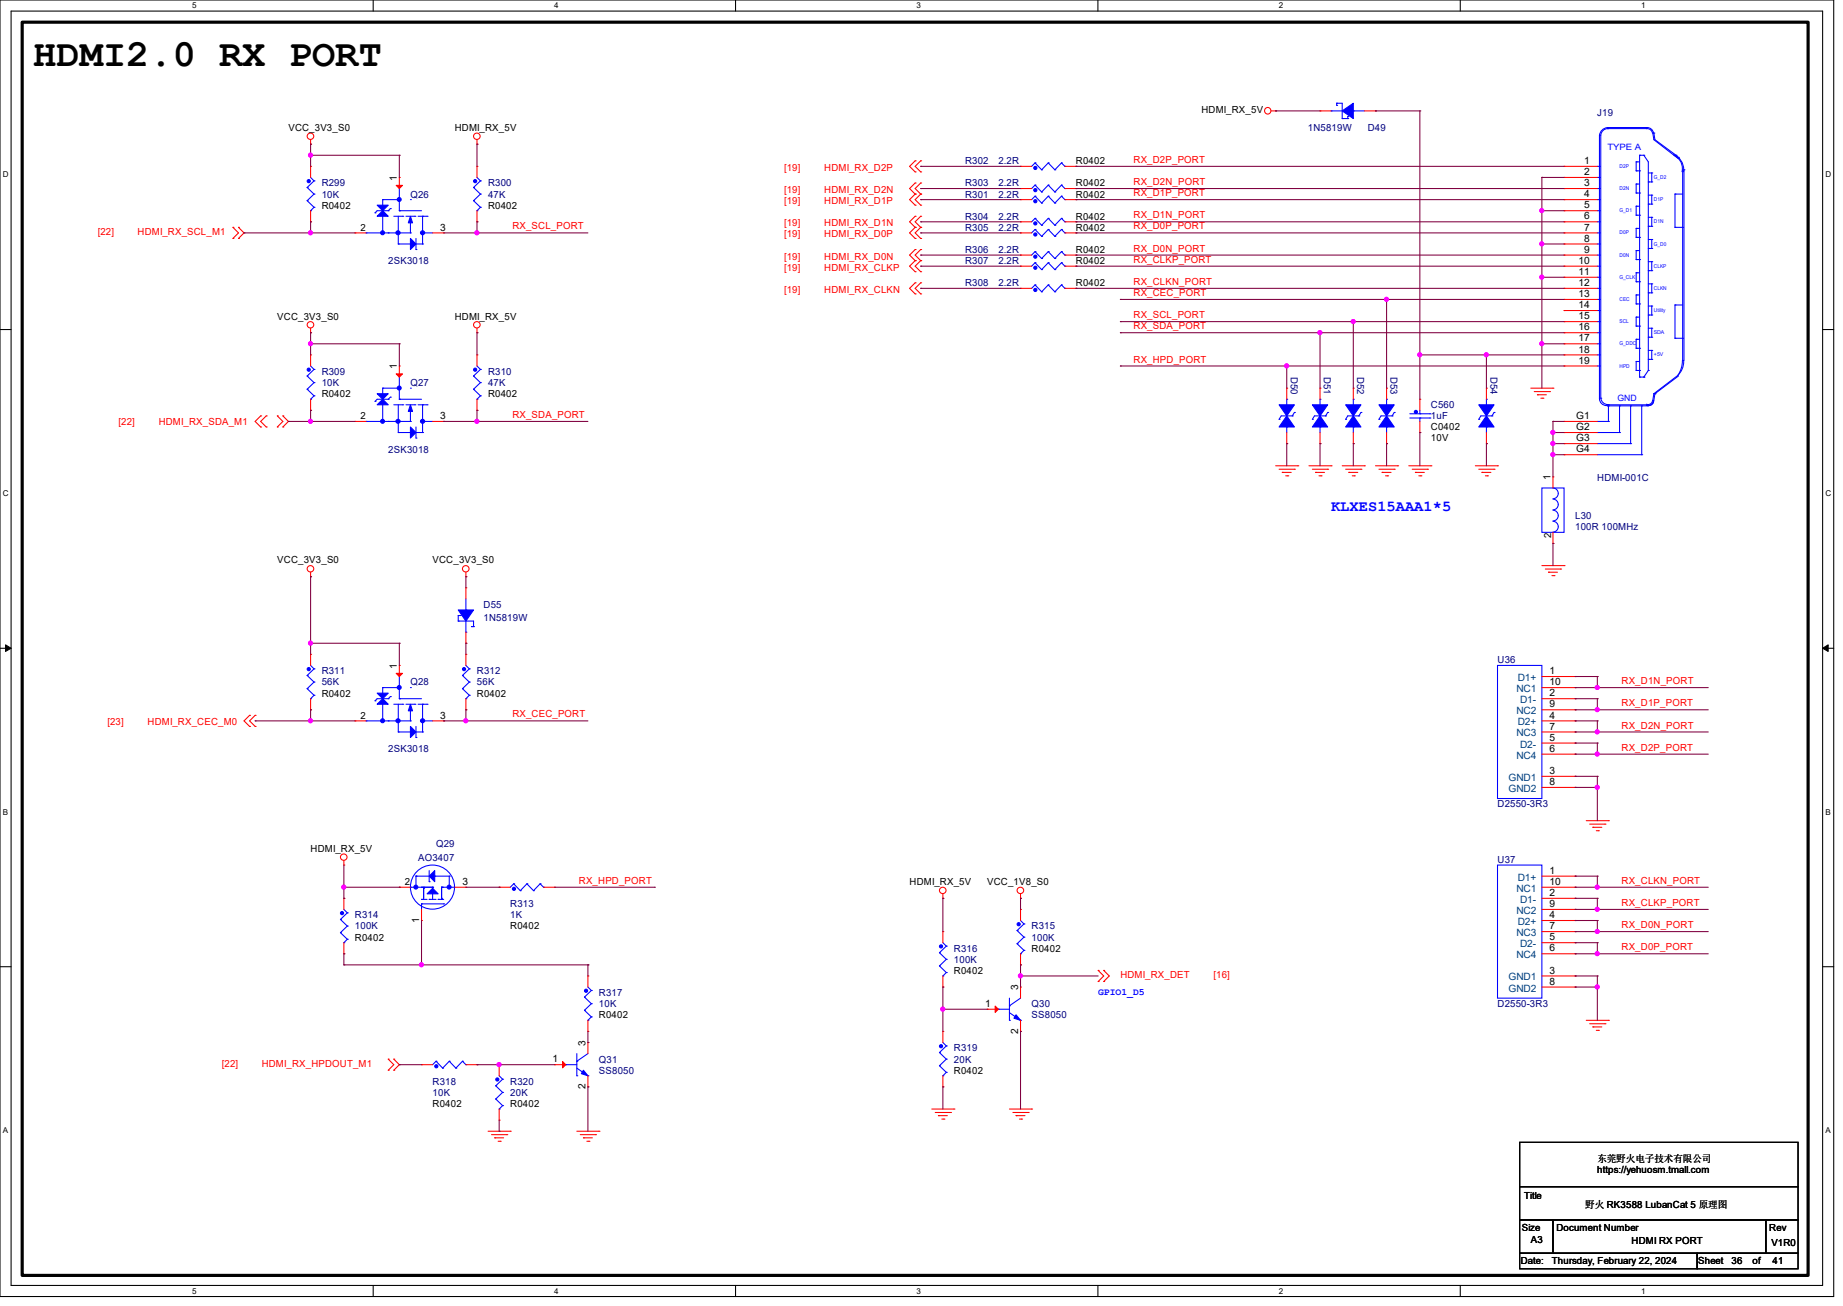
[picture p39: page 36]

东莞野火电子技术有限公司 https://yehuosm.tmall.com

## HCSL

# PCIE3.0_ REFCLK

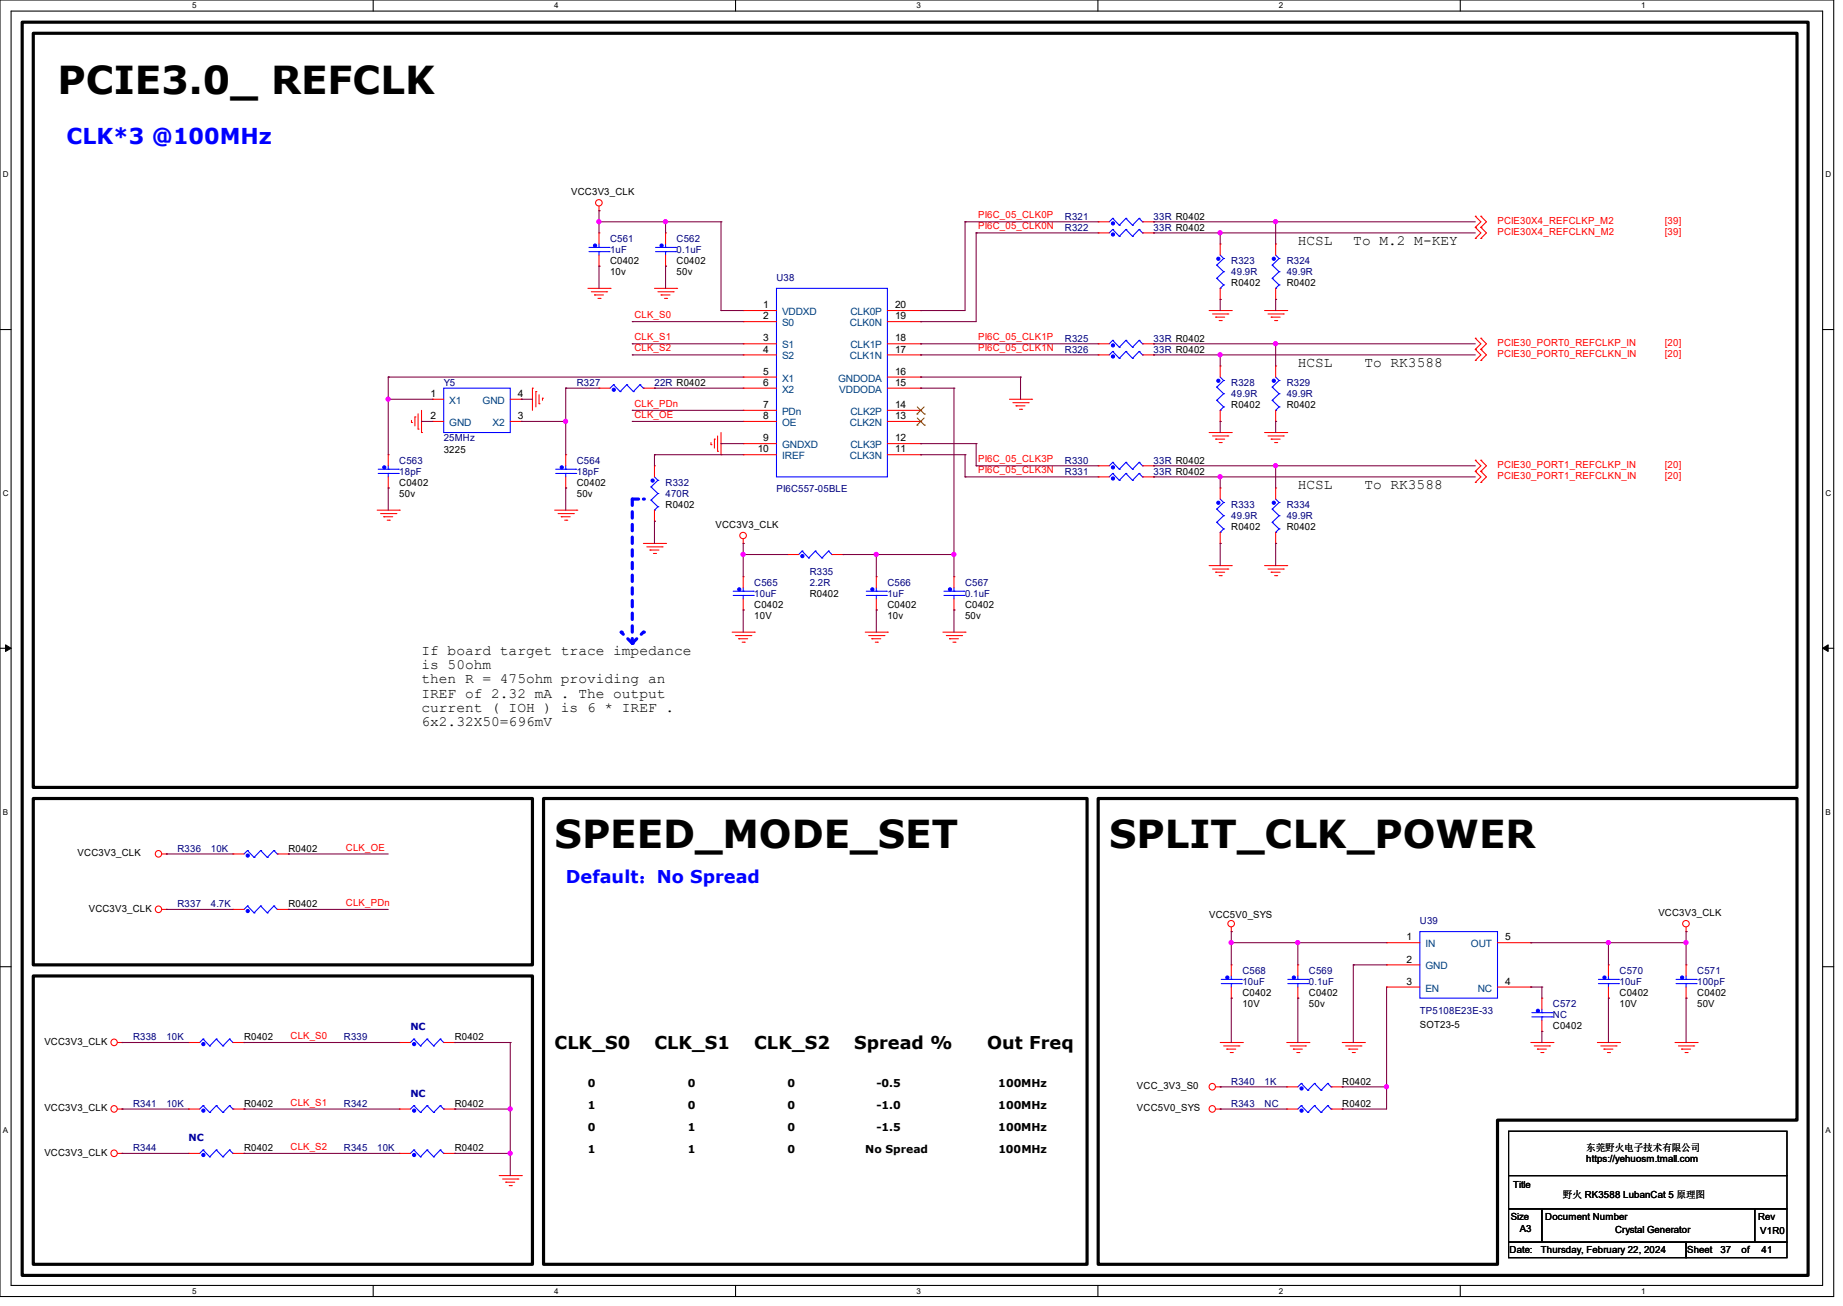
[picture p40: page 37]

If board target trace impedance
is 50ohm
then R = 475ohm providing an
IREF of 2.32 mA . The output
current ( IOH ) is 6 * IREF .

东莞野火电子技术有限公司 https://yehuosm.tmall.com

# MINI PCIE

J20 MINI-PCIE MIC-P 1 MIC-N 3 SPK-P 5 SPK-N 7 GND1 9 VDD-EXT 11 RESERVED 13 GND2 15 RESERVED5 17 WAKEUP-IN 19 GND3 21 UART-RXD 23 UART-RTS 25 GND4 27 GND5 29 UART-TXD 31 PERST2 33 GND6 35 GND7 37 VBAT2 39 VBAT3 41 GND8 43 RESERVED1 45 RESERVED2 47 RESERVED3 49 RESERVED4 51

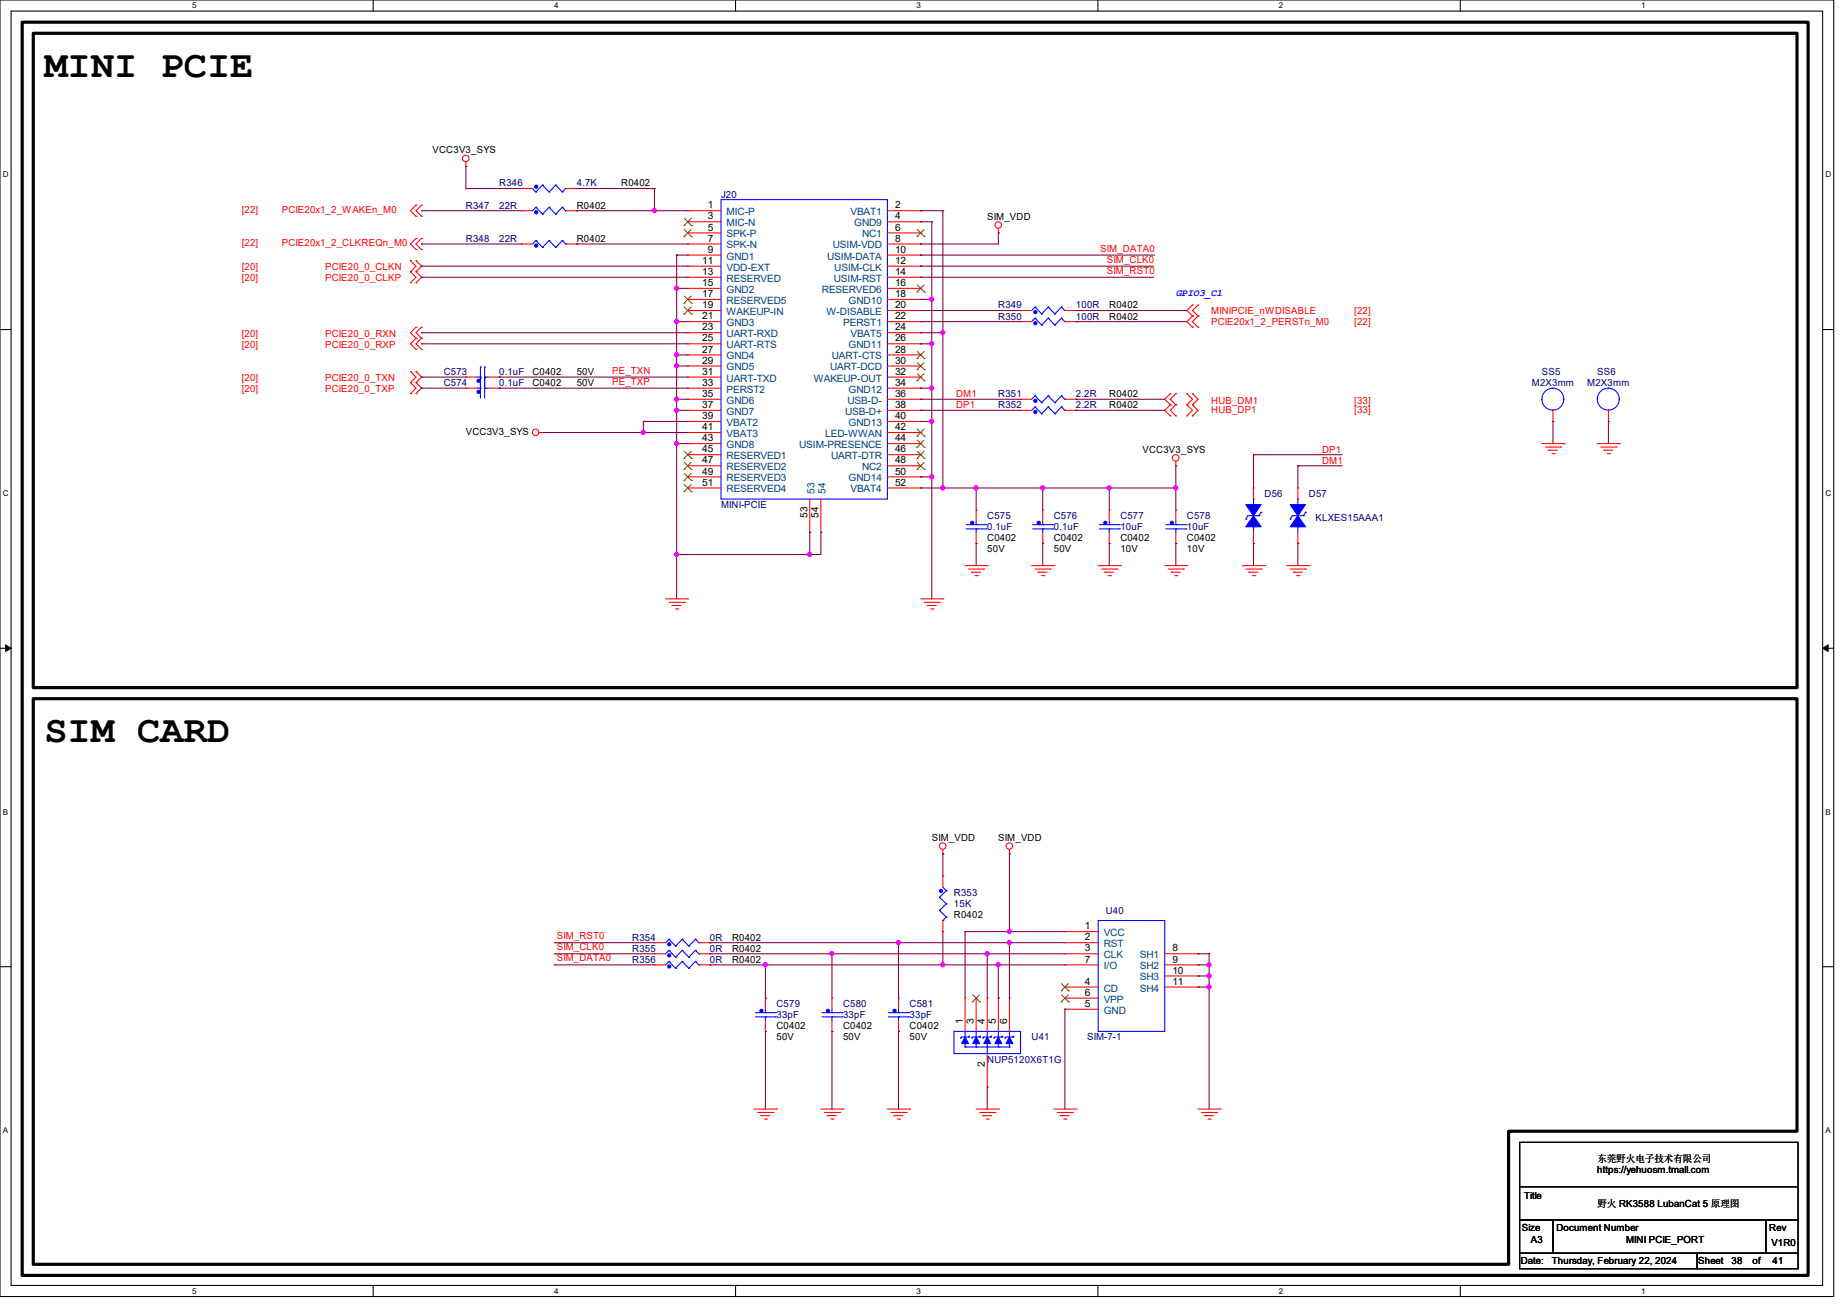
[picture p41: page 38]

VBAT1 2 GND9 4 NC1 6 USIM-VDD 8 USIM-DATA 10 USIM-CLK 12 USIM-RST 14 RESERVED6 16 GND10 18 W-DISABLE 20 PERST1 22 VBAT5 24 GND11 26 UART-CTS 28 UART-DCD 30 WAKEUP-OUT 32 GND12 34 USB-D- 36 USB-D+ 38 GND13 40

U40 SIM-7-1 CLK 3 VPP 6 RST 2 GND 5 VCC 1

东莞野火电子技术有限公司 https://yehuosm.tmall.com

D D

# PCIE2.0 x 1Lanes E-KEY WLAN

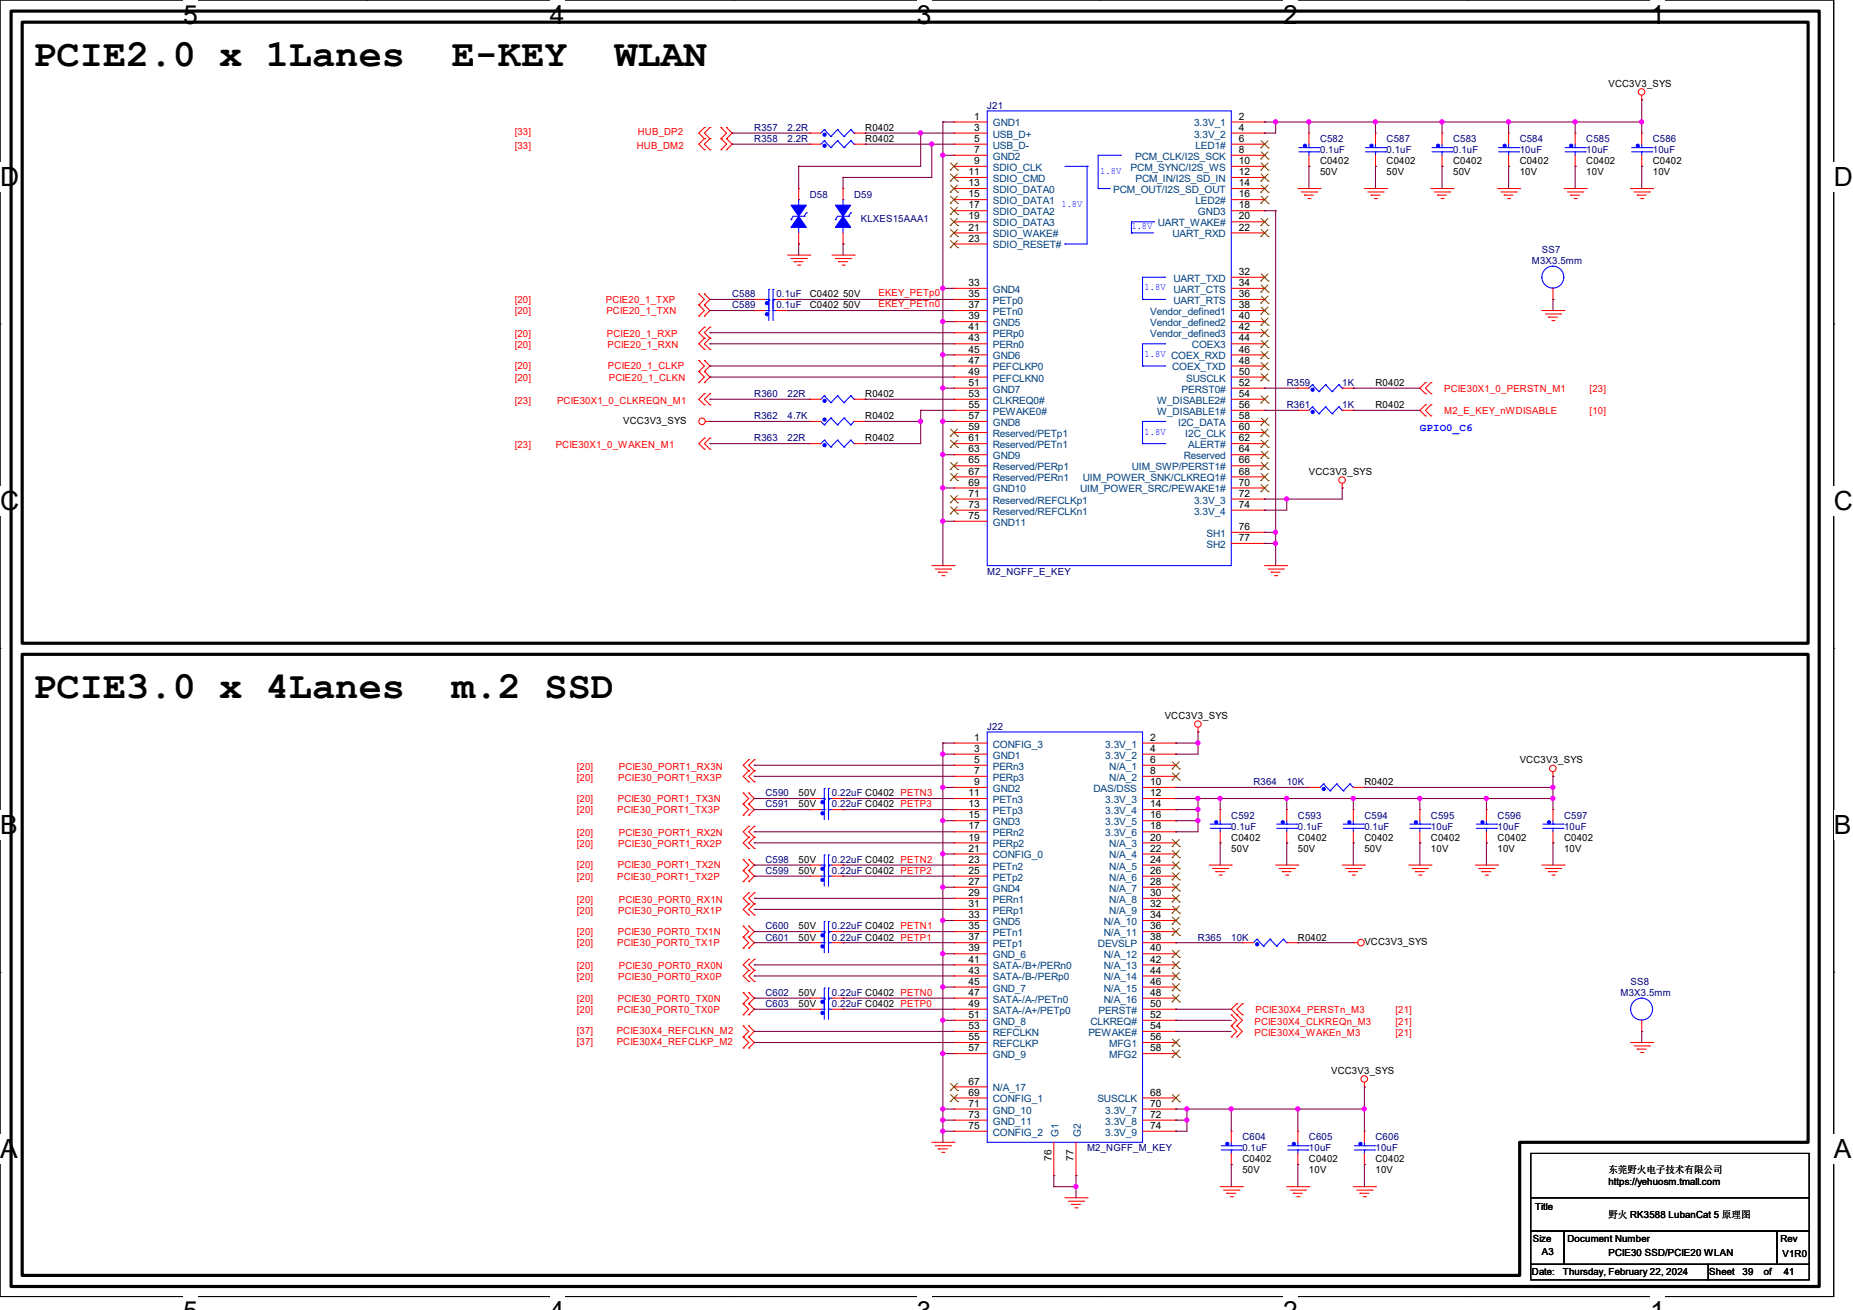
[picture p42: page 39]

东莞野火电子技术有限公司 https://yehuosm.tmall.com

D D

# ES8388 CODEC

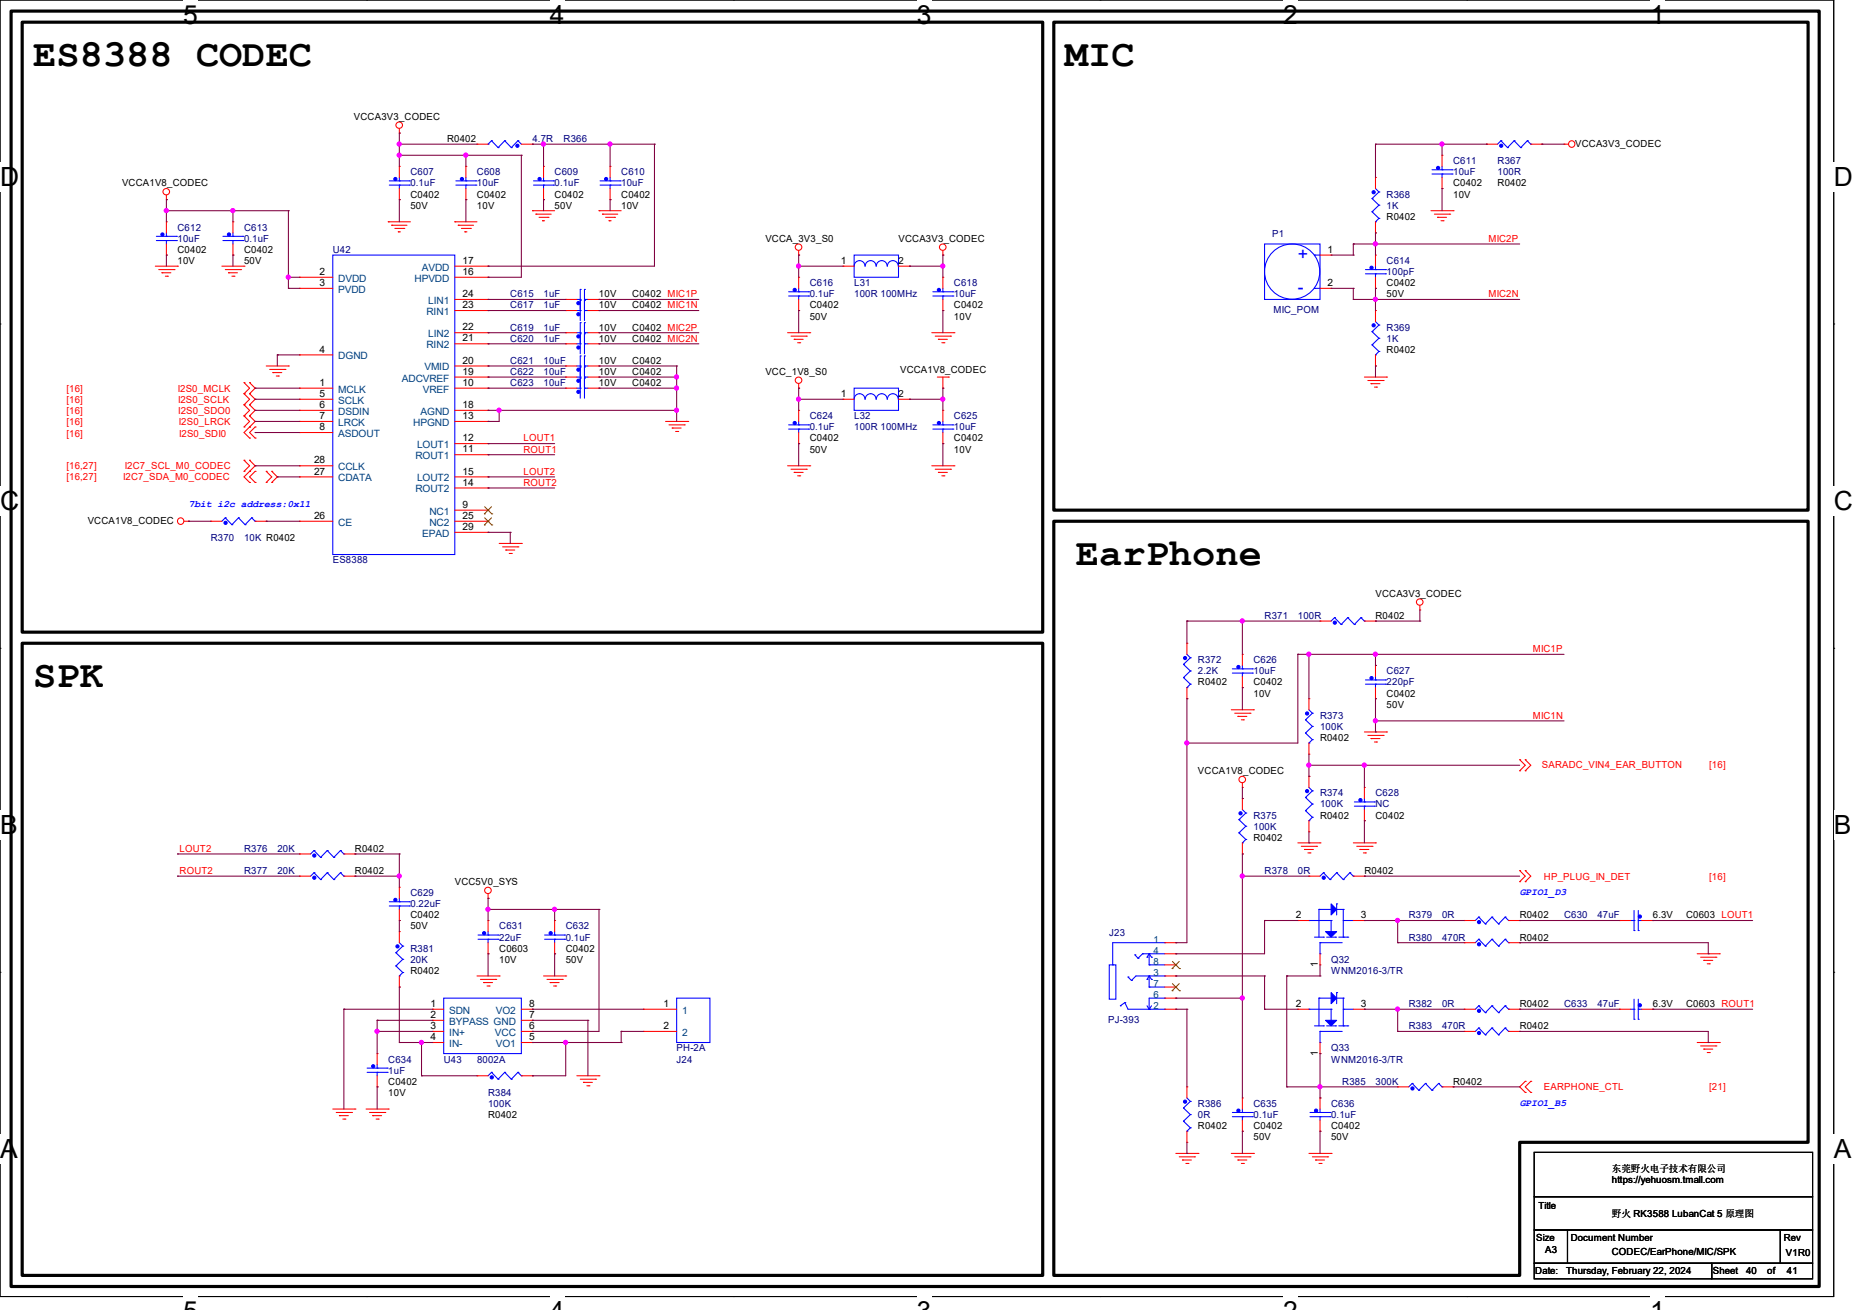
[picture p43: page 40]

东莞野火电子技术有限公司 https://yehuosm.tmall.com

D D

RTC | 40P GPIO

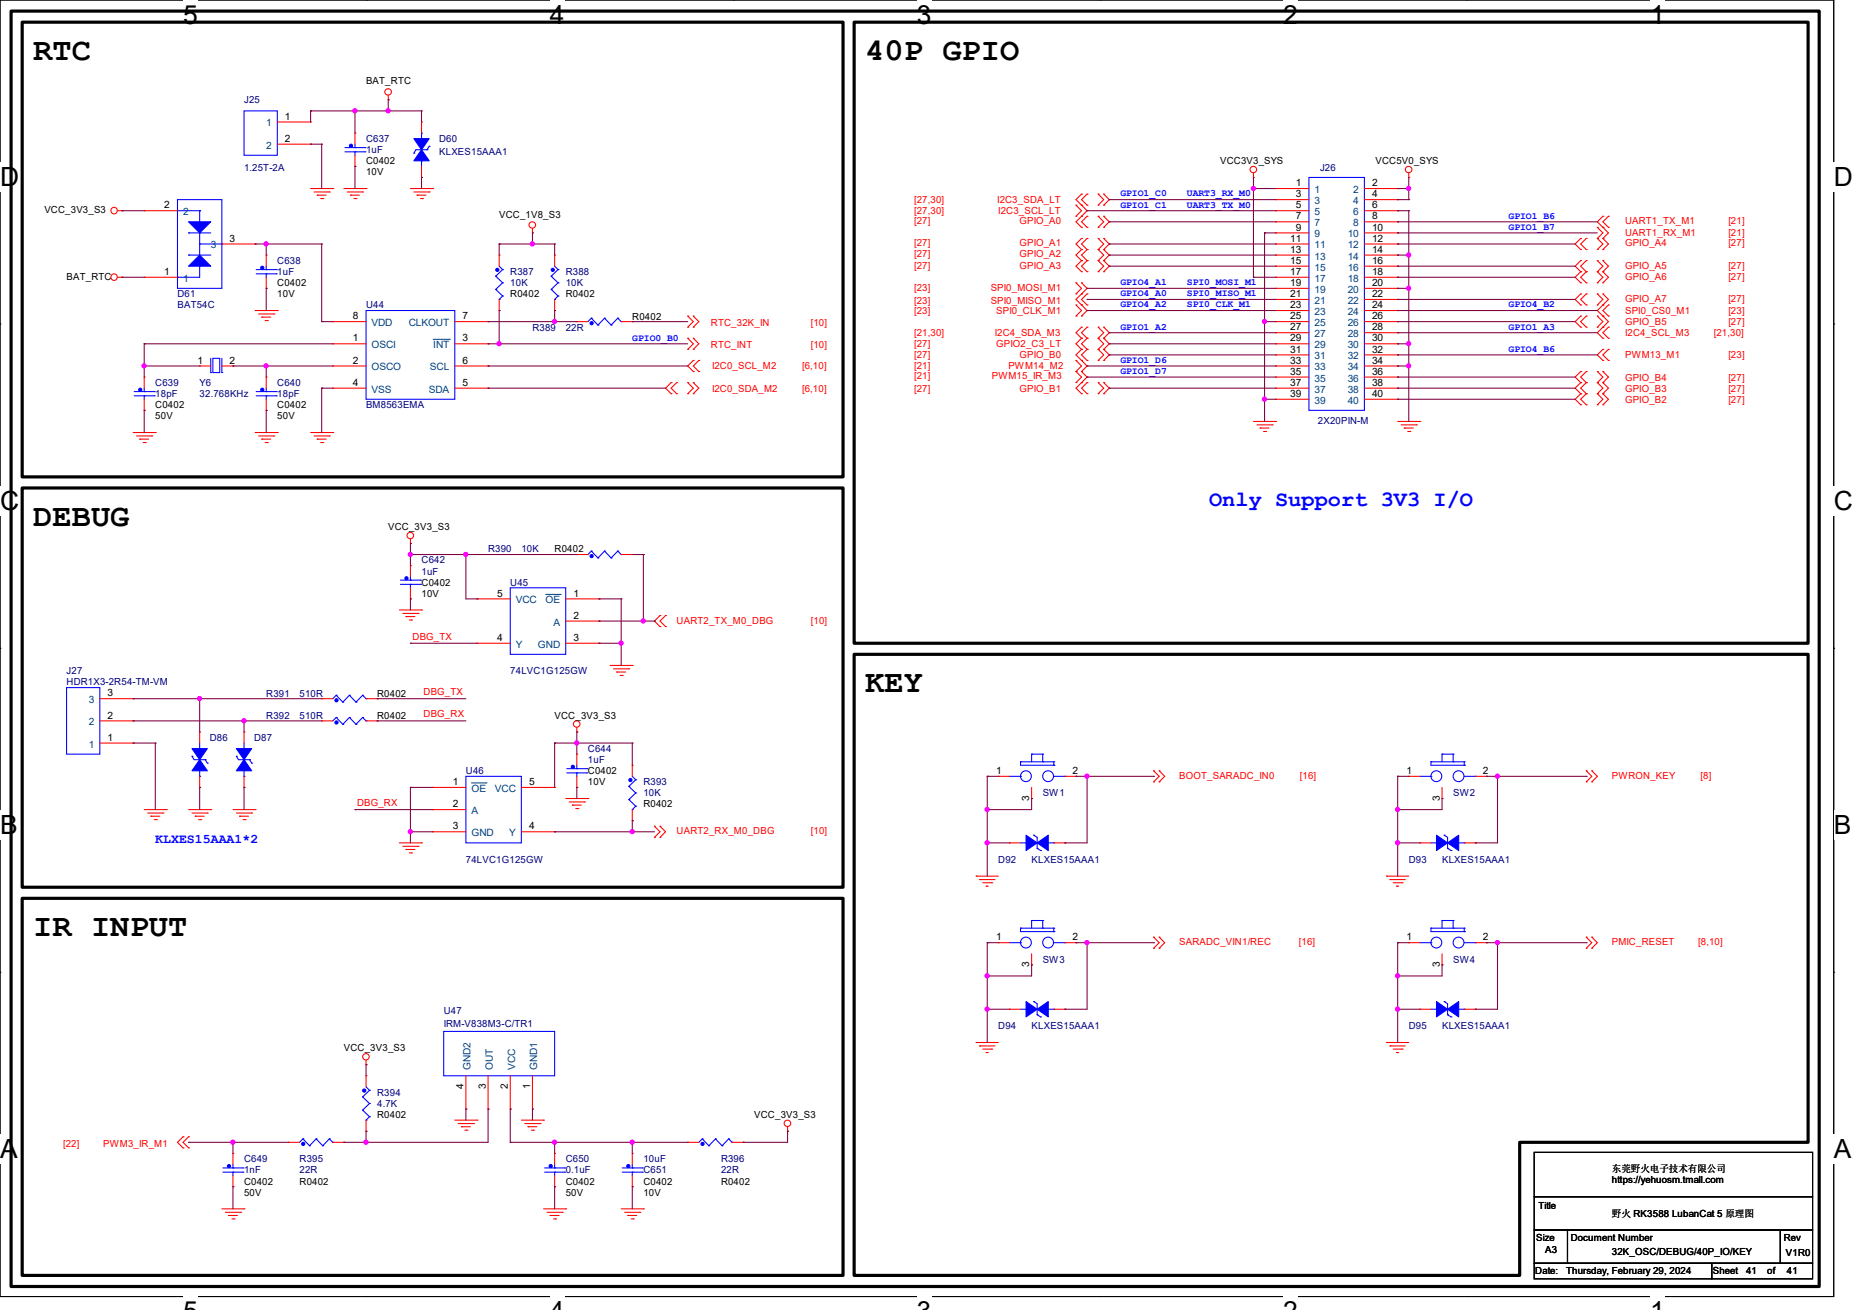
[picture p44: page 41]

东莞野火电子技术有限公司 https://yehuosm.tmall.com
