lc285800/rk3588-camera-robot/硬件_鲁班猫5/EBF410149V1R0_20240221/LubanCat5_EBF410149V1R0_尺寸图_20240221.pdf

# ART FILM - SILKTOP

125

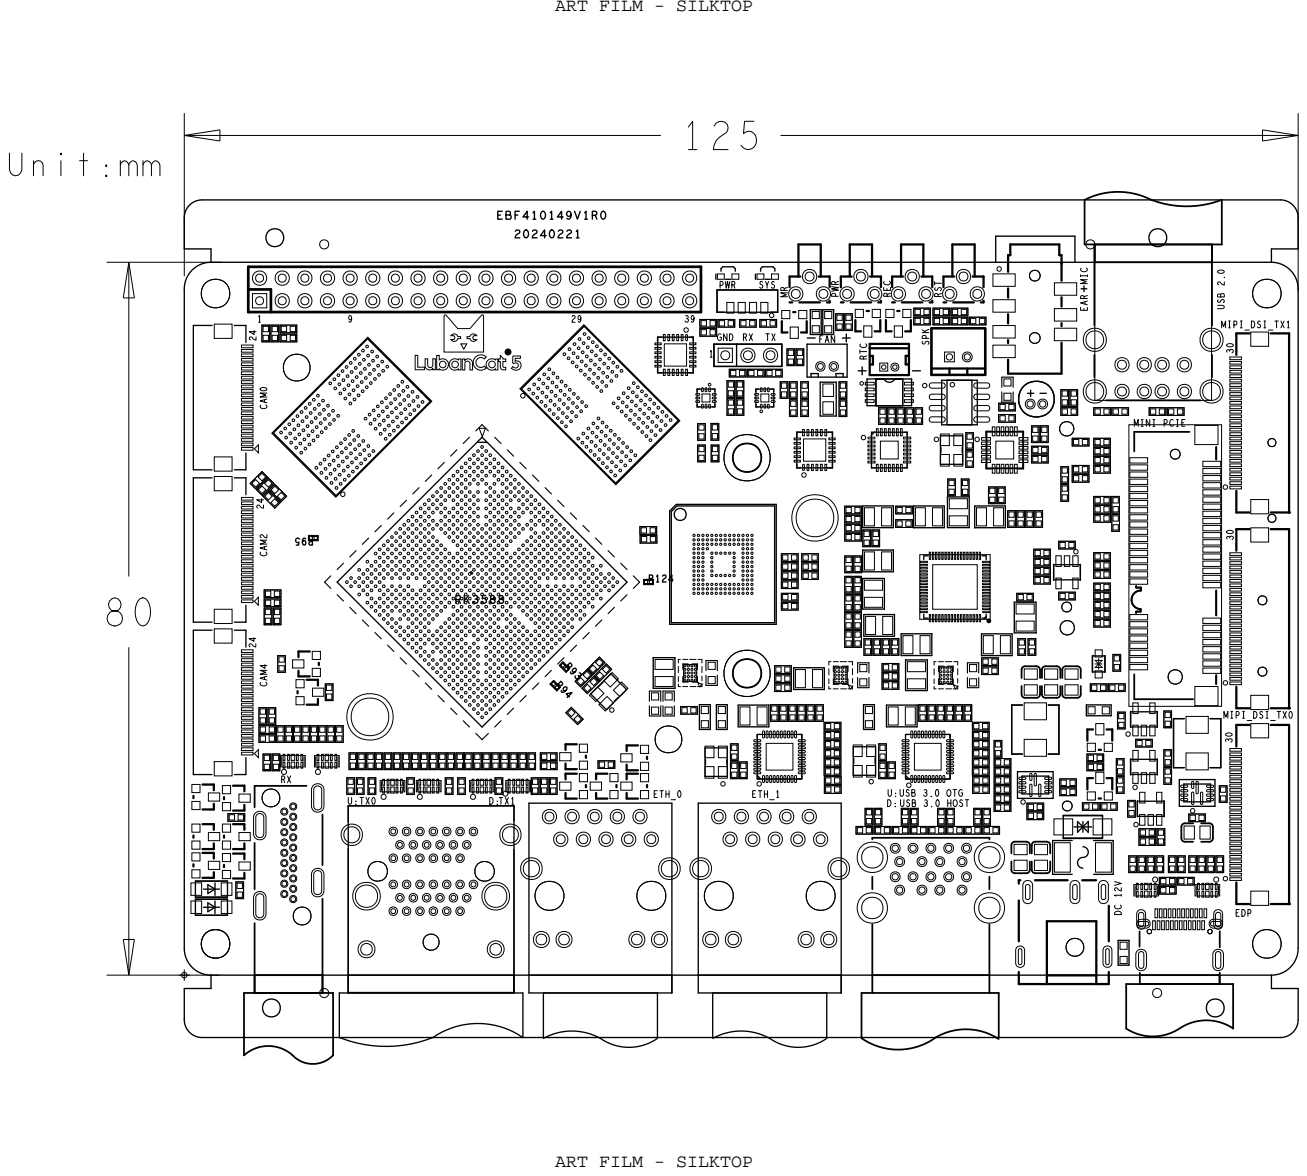
[picture p45: page 1]
30 30 30 EDP; USB 2.0 MIPI_DSI_TX1; MIPI_DSI_TX0; MINI PCIE; MIC EAR; RST; SPK; REC D:; U: USB 3.0 OTG USB 3.0 HOST; RTC; PWR; FAN; SYS; ETH_1; GND; ETH_0; EBF410149V1R0; CAM0 24 CAM2 CAM4; Unit:mm

ART FILM - SILKTOP
