lc285800/rk3588-camera-robot/硬件_鲁班猫5/EBF410149V1R0_20240221/LubanCat5_EBF410149V1R0_位号文件_20240221.pdf

# ART FILM - SILKTOP

J24U43

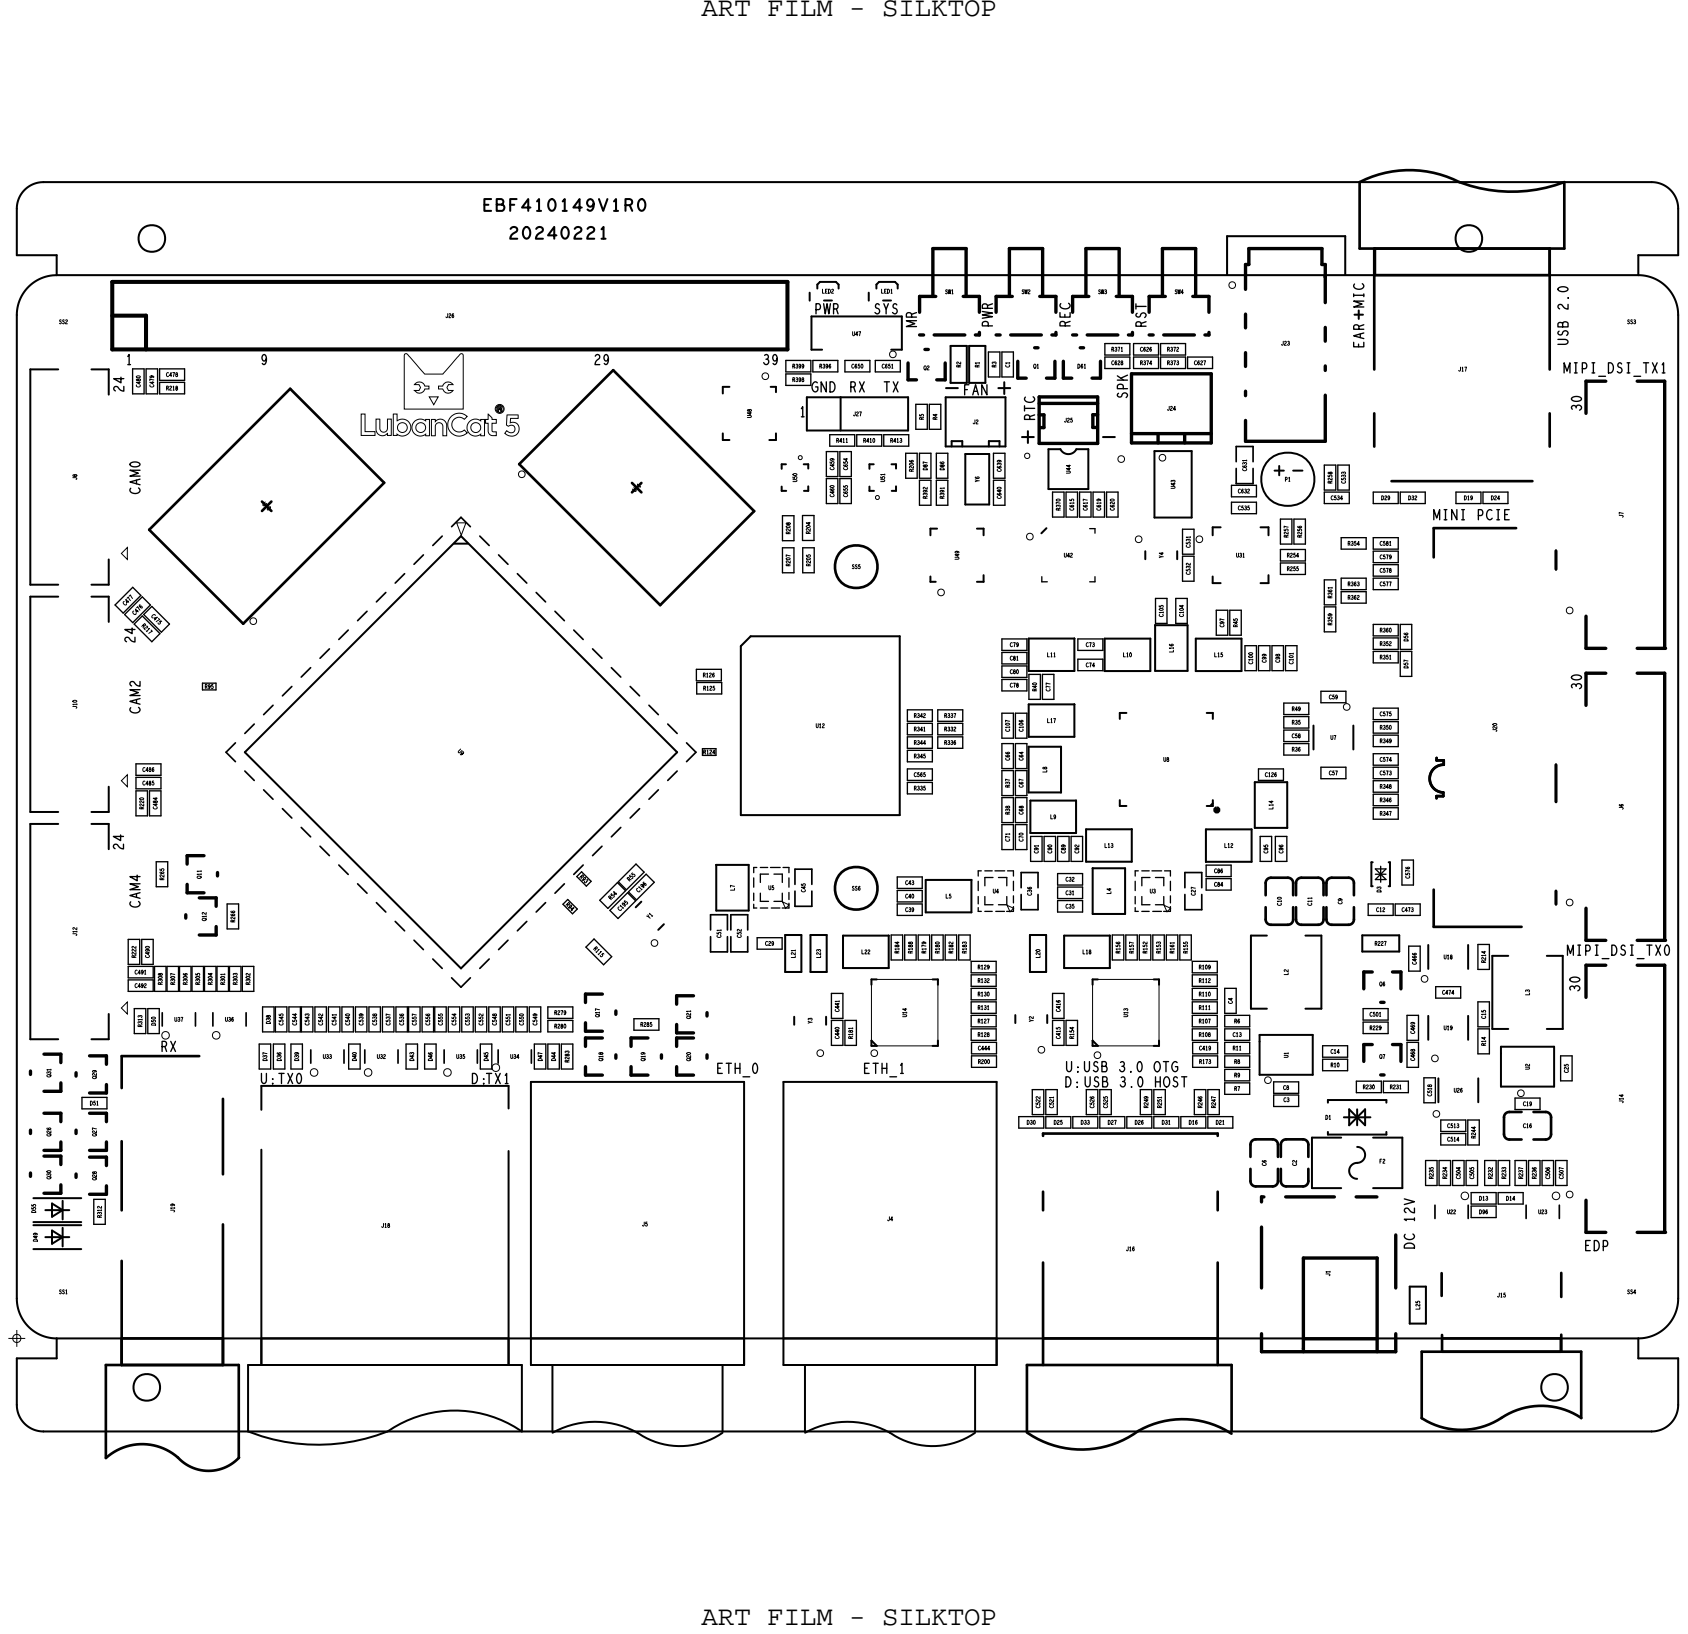
[picture p46: page 1]

# ART FILM - SILKBOT

R379C630

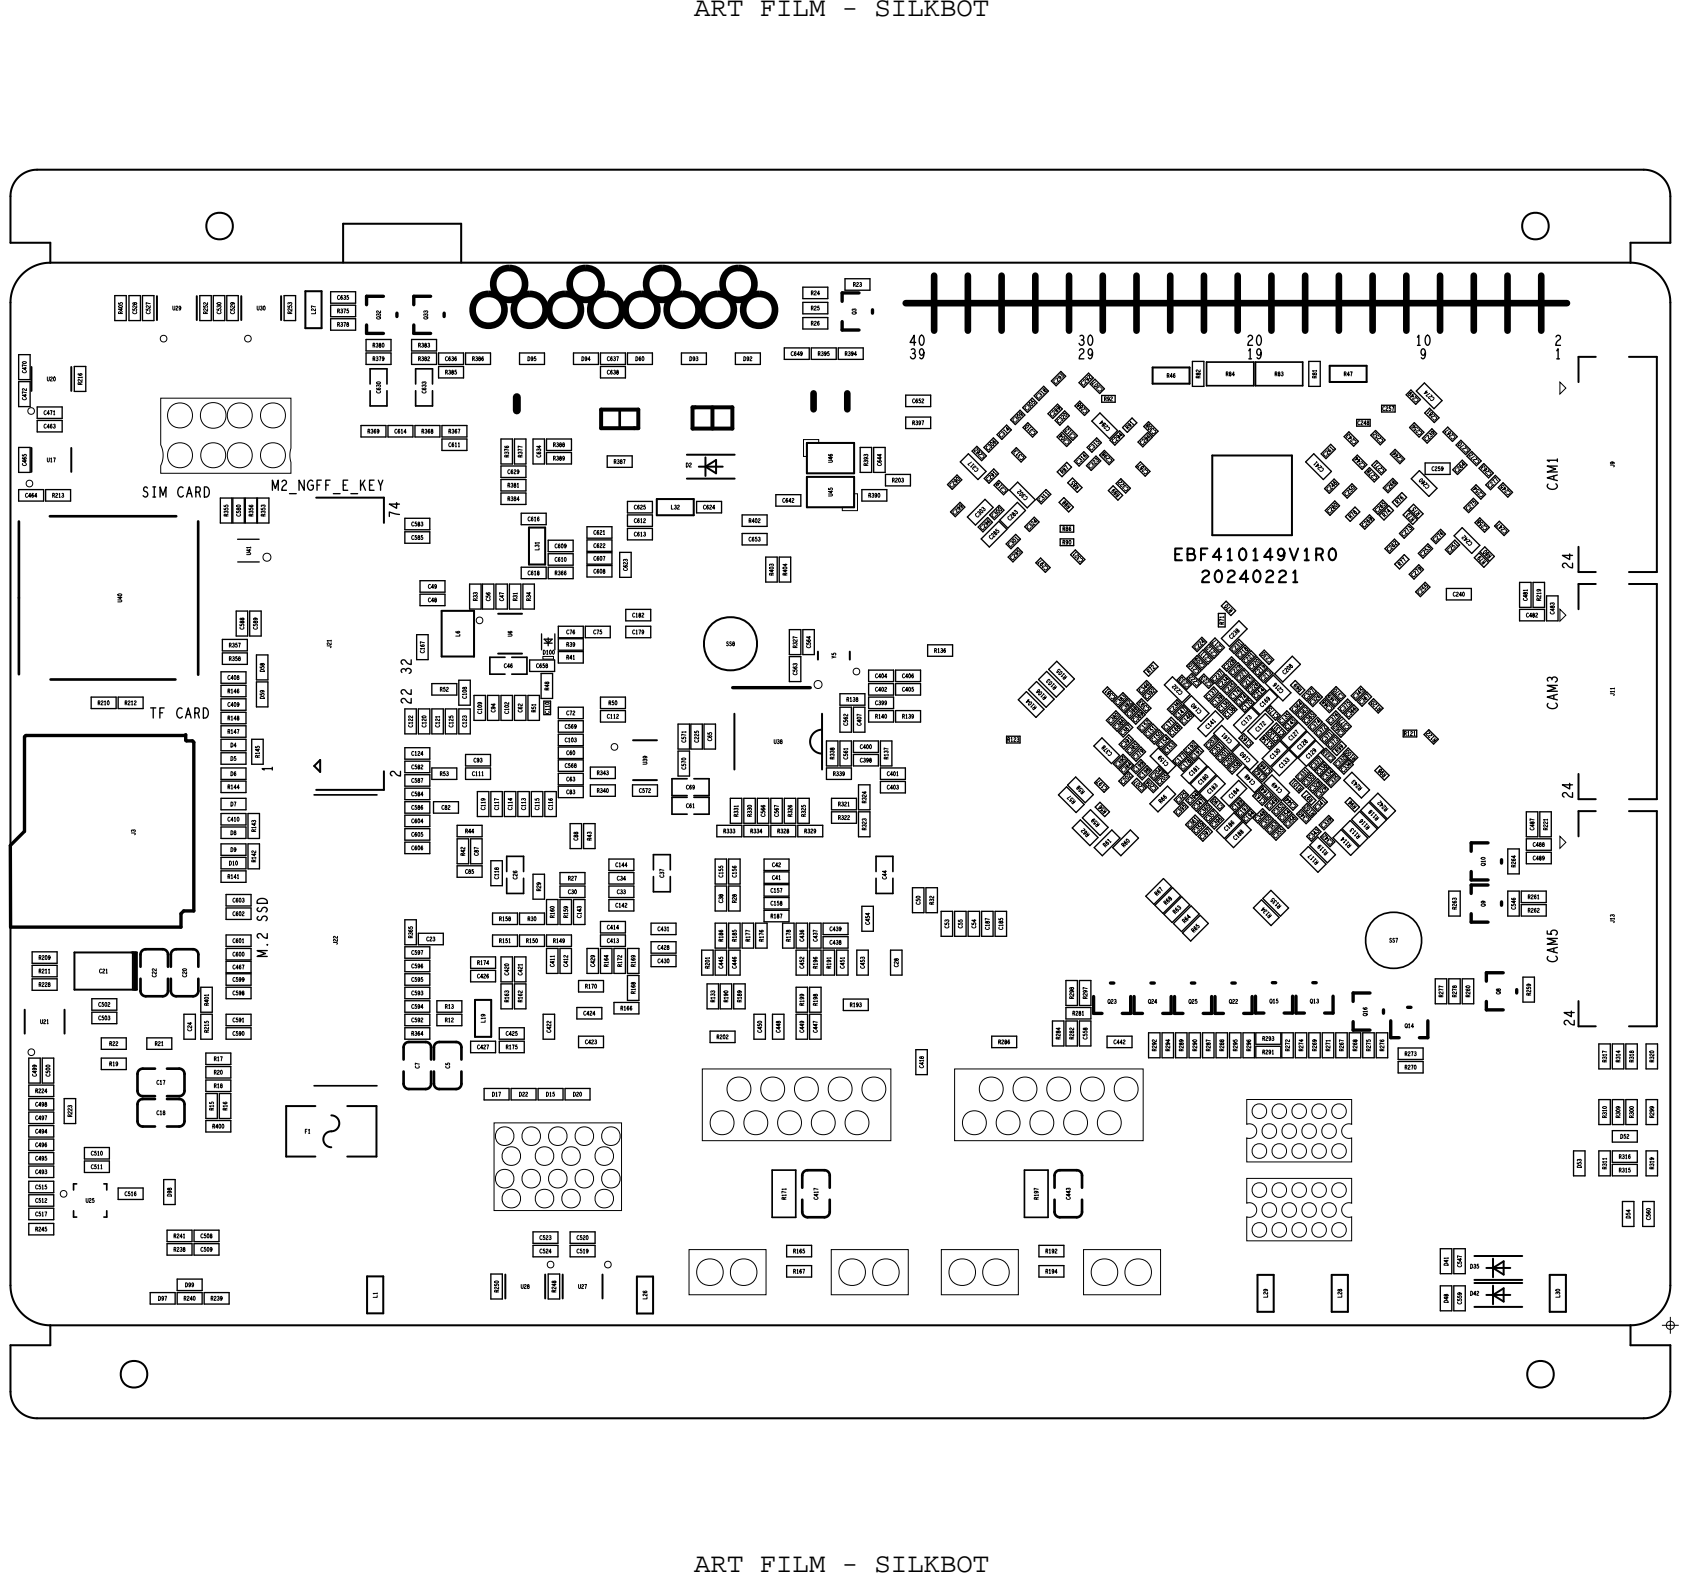
[picture p47: page 2]
