lc285800/rk3588-camera-robot/硬件_鲁班猫5/EBF410149V1R0_20240221/LubanCat5_EBF410149V1R0_器件值_20240221_16+128GB.pdf

# ART FILM - SILKTOP

# PH-2A8002A

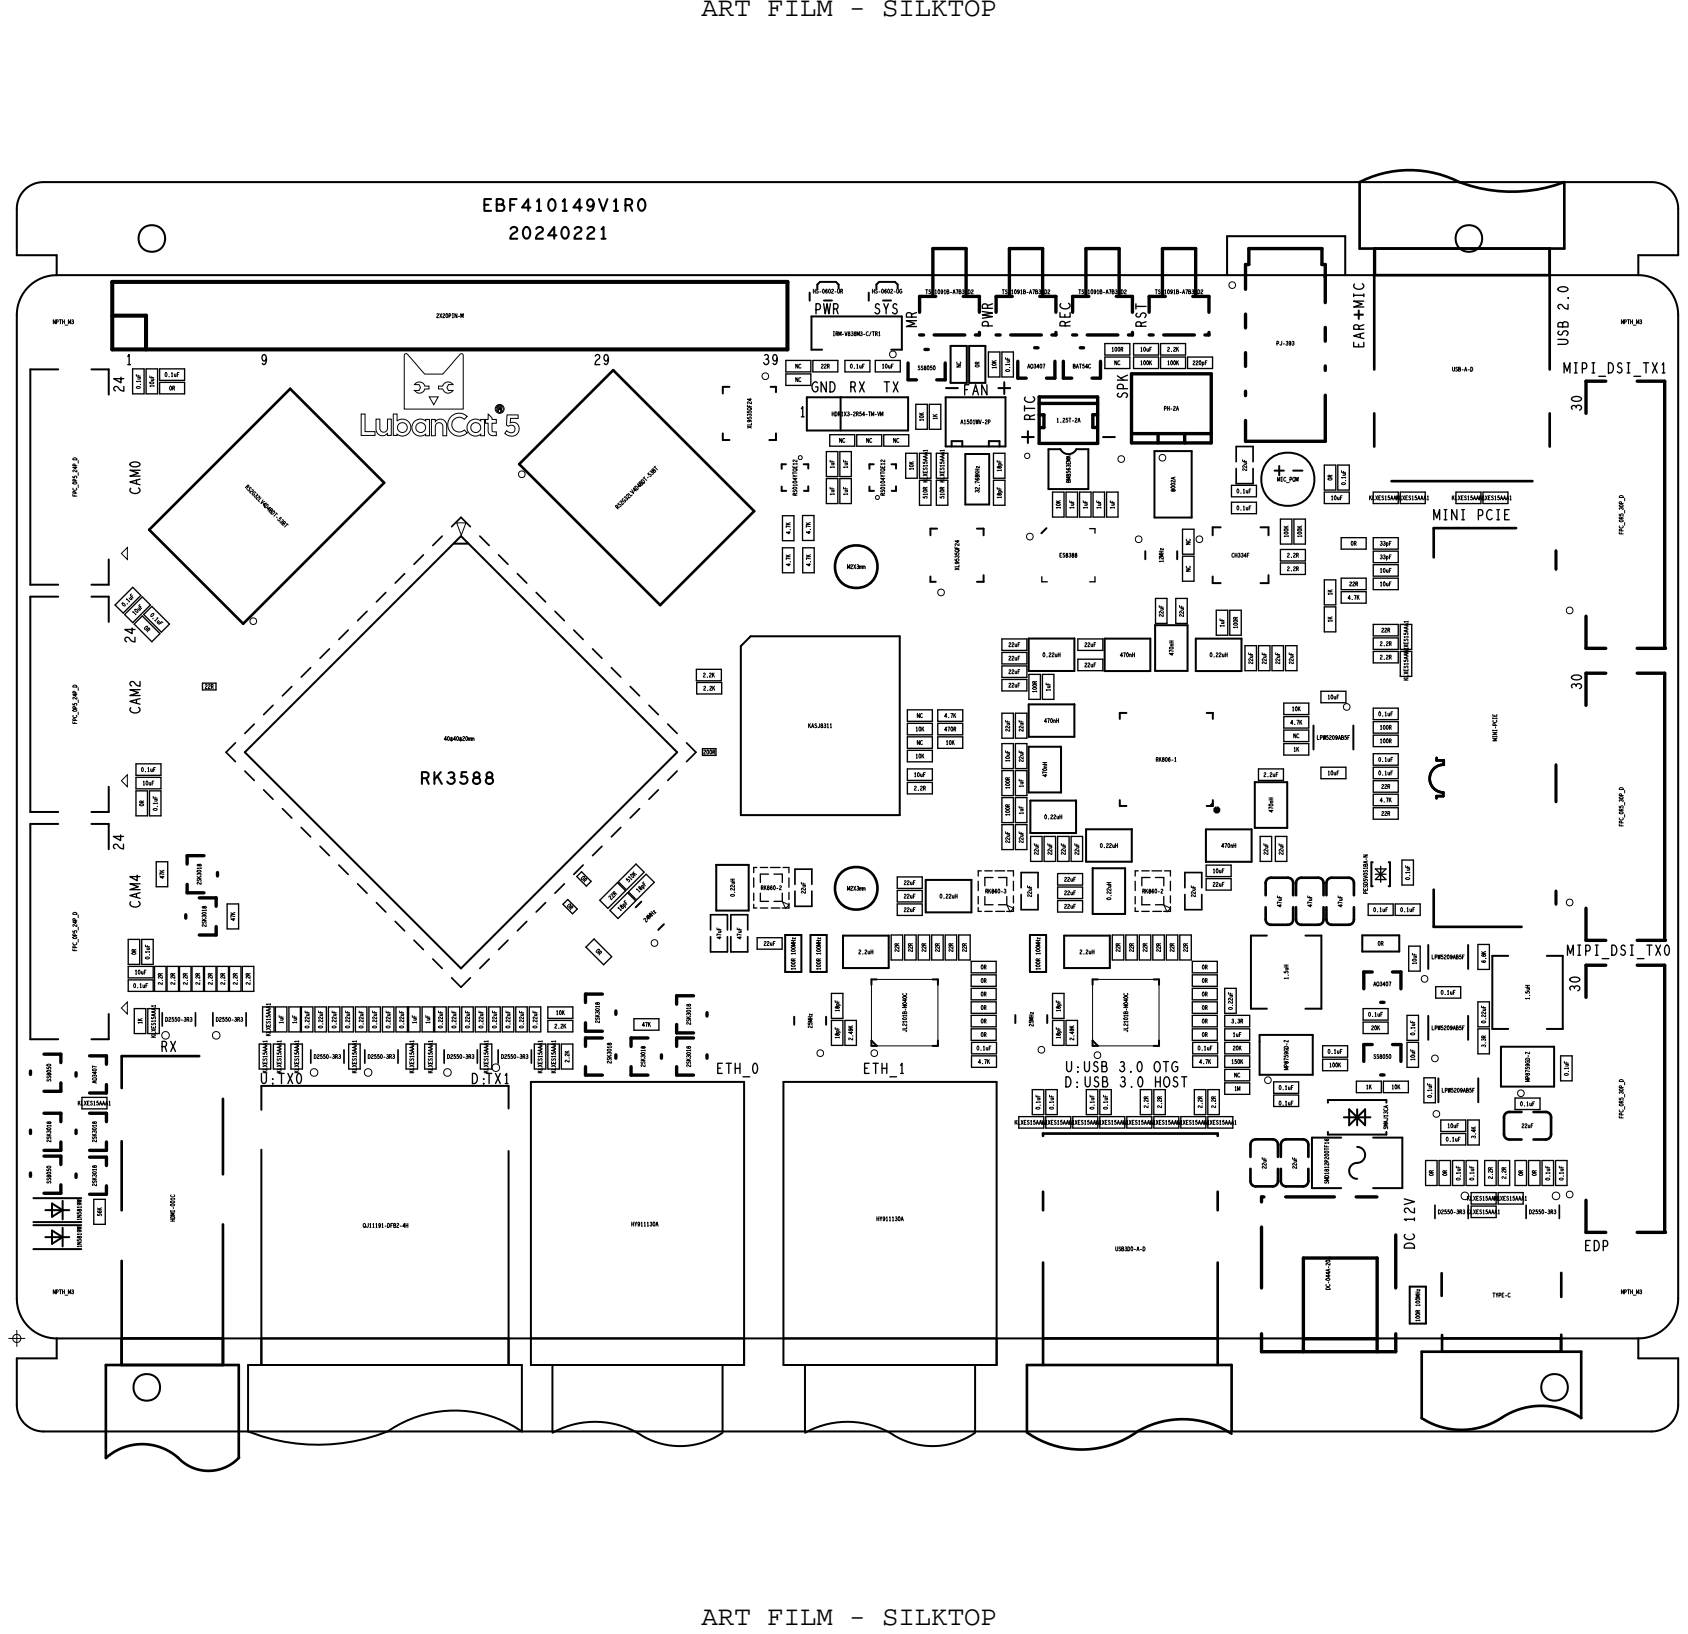
[picture p48: page 1]
NPTH_M3; FPC_0R5_30P_D; EDP; USB 2.0 MIPI_DSI_TX1; MIPI_DSI_TX0; KLXES15AAA1 MINI-PCIE 6.8K 0.22uF 3.3R; KLXES15AAA1; KLXES15AAA1KLXES15AAA1 ⁰.1uF; TYPE-C; USB-A-D; KLXES15AAA1 MINI PCIE; LPW5209AB5F; 100R 100MHz; KLXES15AAA1KLXES15AAA1; PESD5V0S1BA-N; 10K SMAJ13CA; MIC EAR; SMD1812P200TF16 DC-044A-20A; MIC_POM 100K; 0.1uF²²uF; 12MHz 22uF; RST; SPK; USB3D0-A-D; TS-1091B-A7B3-D2 REC BAT54C; 1.25T-2A BM8563EMA 10K; U: USB 3.0 OTG USB 3.0 HOST; RTC; 25MHz; PWR; FAN32.768KHz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

ART FILM - SILKTOP

# ART FILM - SILKBOT

# KLXES15AAA1 1uF

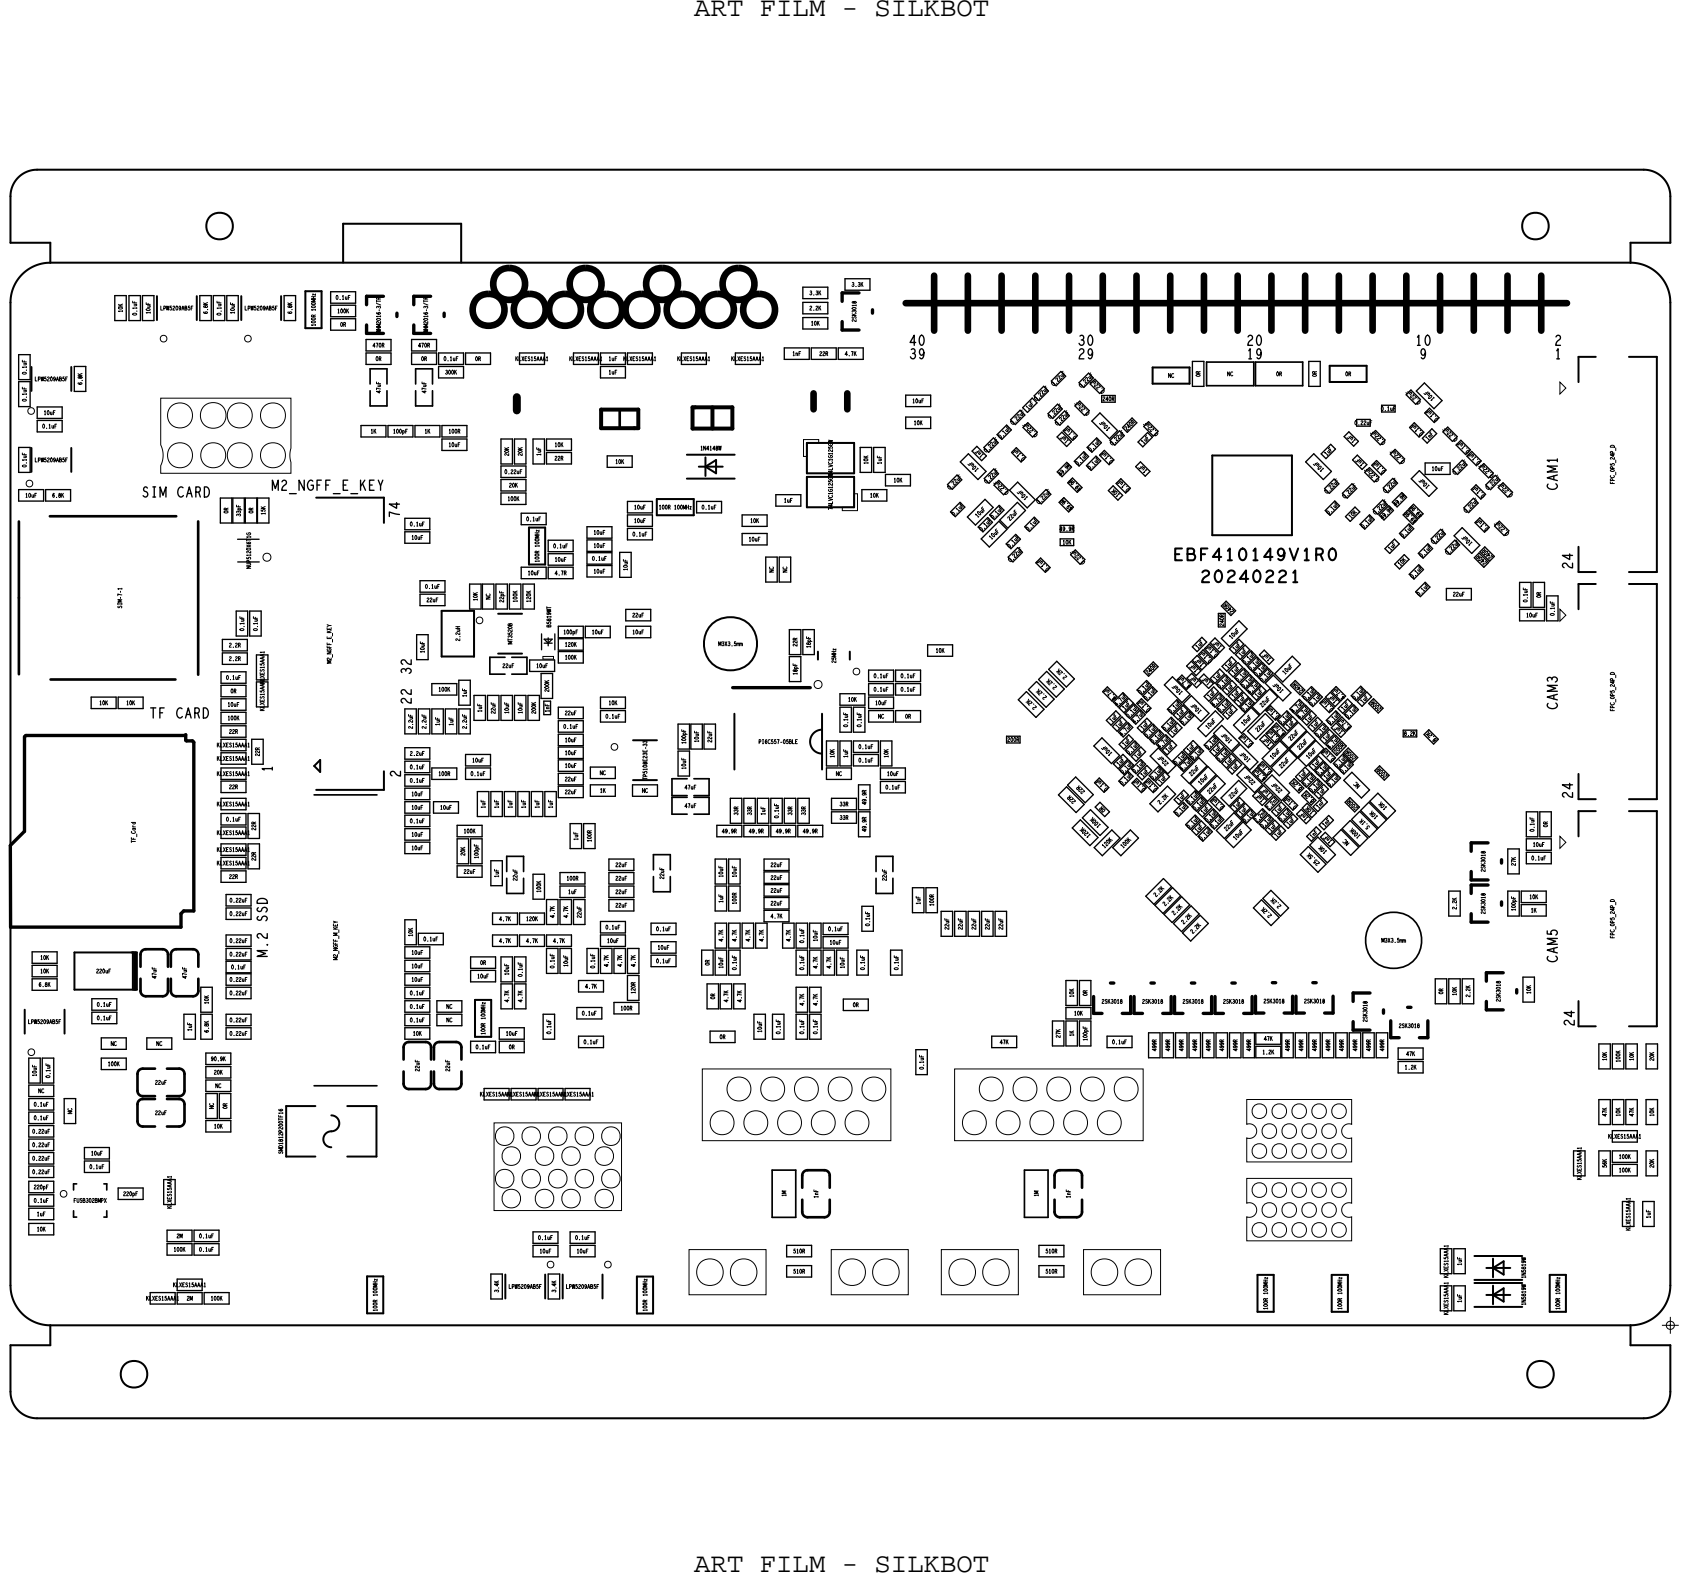
[picture p49: page 2]
LPW5209AB5F; LPW5209AB5F 10uF; FUSB302BMPX; 10K SIM-7-1; 10KTF_Card; SIM CARD; TF CARD 47uF 1uF; KLXES15AAA1; KLXES15AAA1 2M; 0R NUP5120X6T1G; M.2 SSD; 100R 100MHz; SMD1812P200TF16; M2_NGFF_E_KEY; M2_NGFF_M_KEY; WNM2016-3/TR; 0.22uF ²⁰K; 22uFMT3520B; 0R100R 100MHz; 0R KLXES15AAA1 3.4K; 0.1uF100R 100MHz; KLXES15AAA1KLXES15AAA1; 74LVC1G125GW; 25MHz; PI6C557-05BLE; 49.9R ³³R; EBF410149V1R0; 499R 100R 100MHz; KLXES15AAA1 KLXES15AAA1; CAM1; CAM3; CAM5; FPC_0P5_24P_D; KLXES15AAA1 ¹⁰K

ART FILM - SILKBOT
