lc285800/rk3588-camera-robot/config/platforms/lubancat5.yaml

platform:
  name: lubancat5
  camera_device: /dev/video1
  ros_domain_id: 20
  servo_pwm:
    physical_pin: 32
    gpio_name: GPIO4_B6
    gpio_number: 142
    controller: pwm13
    pinmux: m1
    pwmchip: 3
    channel: 0
    period_ns: 20000000
    center_ns: 1900000
    min_pulse_ns: 1850000
    max_pulse_ns: 1950000
    calibration_status: observed_short_hold
    enabled_by_default: false
    nominal_angle:
      min_deg: 85.0
      center_deg: 90.0
      max_deg: 95.0
      pulse_per_degree_ns: 10000.0
      increasing_pulse_direction: right
    observed_short_hold_calibration:
      min_pulse_ns: 1000000
      min_angle_deg: 0.0
      center_pulse_ns: 1900000
      center_angle_deg: 90.0
      max_tested_pulse_ns: 2500000
      max_observed_angle_deg: 150.0
      position_servo_not_continuous: true
      measurement_method: hand_held_visual_estimate
  tracking:
    enabled_by_default: false
    target_id: 23
    update_rate_hz: 20.0
    observation_timeout_sec: 0.35
    hold_timeout_sec: 0.75
    return_rate_deg_sec: 2.0
    pid:
      kp: 4.0
      ki: 0.0
      kd: 0.15
      direction: -1.0
      deadband: 0.03
      integral_limit: 0.0
      output_limit_deg_sec: 3.0
      delta_limit_deg_sec: 0.5
    validated_live_test_profile:
      min_angle_deg: 70.0
      center_angle_deg: 90.0
      max_angle_deg: 110.0
      min_pulse_ns: 1700000
      center_pulse_ns: 1900000
      max_pulse_ns: 2100000
      kp: 6.0
      output_limit_deg_sec: 5.0
      delta_limit_deg_sec: 0.75
      direction: -1.0
      status: basic_tracking_passed
