lc285800/rk3588-camera-robot/(commit log)

2026-07-08 feat: add RK camera foundation and execution roadmap
2026-07-08 fix: use sensor QoS for camera images
2026-07-09 Complete M06 camera smoke path
2026-07-16 Complete M14 simulated gimbal loop
    [step_response.csv]
2026-07-16 Record M15 SoC PWM software validation
2026-07-20 Align documentation with current hardware status
2026-07-20 Record M15 SG90 hardware smoke test
    [LubanCat5_EBF410149V1R0_PCB_20240221_BOT.dxf, LubanCat5_EBF410149V1R0_PCB_20240221_TOP.dxf]
2026-07-20 Add safety-bounded PWM core
2026-07-20 Record M16 provisional servo calibration
2026-07-21 Correct SG90 observed calibration
    [lubancat5.yaml]
